thanhbinh89/Bow32/README.md

# Bow32 — MCU RISC-V 32-bit cho mục đích học tập

Bow32 là một vi điều khiển (MCU) 32-bit đơn giản, xây dựng quanh lõi
[lowRISC Ibex](https://github.com/lowRISC/ibex) (RV32IMC), được thiết kế để
**học kiến trúc SoC từ RTL tới firmware** và kiểm chứng trên board
**AMD Kria KV260 (SOM K26)**. Bow32 có một **ISP (image signal processor)**,
một **bộ thu MIPI CSI-2** tự viết (D-PHY trên primitive I/O của UltraScale+,
không dùng IP của AMD) và một **bộ mã hoá H.264** tự viết cùng **DMA** và
**video RAM 1 MiB**: camera → CSI-2 → ISP → H.264 → DMA → RAM là một luồng
phần cứng liền mạch, ra file **MP4** trên PC. Chạy thử với Raspberry Pi camera
v2 (IMX219) của KV260 ở **1080p30** hoặc **720p60**. Bộ thu còn có bản **4 lane ×
1440 Mbit/s** cho Sony IMX274 trên bo **Huins MFP-VP1902** (AMD Versal Premium; D-PHY
trên XPHY của Versal, cũng không dùng IP; chạy trên bo lần đầu 2026-11-10: 1080p30 / 720p60,
H.264 1080p). Bow32 còn có khối tăng tốc
**mã khối MKV** theo TCVN 14263:2024 (MKV-128 / MKV-256, đủ 6 phiên bản khoá),
kiểm chứng với Phụ lục A của chuẩn, **SDRAM DDR2/DDR3**:
controller **LiteDRAM** (sinh từ Python) trên PHY riêng của Bow32 (`ODDRE1`/`IDDRE1` +
MMCM dịch pha, điều khiển level shifter, hiệu chỉnh bằng phần mềm), và **HyperRAM**
(bộ điều khiển HyperBus tự viết cho S80KS2562: read buffer, ghi posted, BIST, quản lý
nguồn), cả hai chạy trên bo **Arm MPS4** (Virtex UltraScale+) và Huins MFP-VP1902.

```
                 +-----------------------------------------------------------+
                 |                         bow32_top                         |
                 |                                                           |
                 |  +-----------+ instr +------------------+                 |
                 |  |   Ibex    |------>|                  |---> ROM   8 KiB |  0x0000_0000
                 |  |  RV32IMC  |       |   main crossbar  |---> FLASH 128KiB|  0x0800_0000
                 |  | (2-stage) |------>|  3 hosts x 9 dev |---> SRAM  16KiB |  0x2000_0000
                 |  +-----------+ data  +------------------+---> VRAM  1 MiB |  0x2400_0000
                 |        ^           DMA --^      |  +-----> ISP buffer     |  0x3000_0000
                 |        ^ irq_fast[12:0]         |  +--------> AXI4-Lite --+--> m_axil_*  0x5000_0000
                 |        |                        |  +--> HyperRAM -------+--> hr_io_*   0x6000_0000
                 |        |                        |  +--> DDR (LiteDRAM) --+--> ddr_io_*  0x8000_0000
                 |        |                        v                         |
                 |        |                       +----------------+         |
                 |        +-----------------------| periph xbar    |         |  0x4000_0000
                 |                                |  SYSCTRL       |         |  + reset manager
                 |                                |  FLASH_CTRL    |         |
   uart0 <-------+--------------------------------|  UART0         |         |  console / bootloader
                 |                           +----|  UART1         |         |
   gpioa[7:0] <--+---------------------------|----|  GPIOA         |         |  PA7 = camera enable
   gpiob[7:0] <--+---------------------------+--->|  GPIOB         |         |  PB0/PB1 = UART1
                 |                                |  ISP regs -----+---+     |  0x4000_6000
   i2c0 <--------+--------------------------------|  I2C0          |   |     |  0x4000_7000
                 |       +------------------------|  CSI2RX regs   |   |     |  0x4000_8000
                 |       |                  +-----|  H264 regs     |   |     |  0x4000_9000
                 |       |                  |  +--|  DMA regs      |   |     |  0x4000_A000
                 |       |                  |  |  |  MKV cipher    |   |     |  0x4000_B000
                 |       |                  |  |  |  DDR CSR, PHY  |   |     |  0x4000_C000, _E000
                 |       |                  |  |  |  HyperRAM regs |   |     |  0x4000_F000
                 |       |                  |  |  +----------------+   |     |
                 |       v                  |  |                       v     |
   D-PHY (J9) ---+--> CSI-2 RX ---> ISP: BLC DPC WB demosaic CCM gamma CSC --+--> isp_* RGB/YUV
   (2 lane)      |                          v  v                YUV 4:4:4    |
                 |          H.264 encoder (intra, CAVLC) --stream--> DMA ----+--> VRAM
                 +-----------------------------------------------------------+
```

## Tính năng

| Khối | Mô tả |
|---|---|
| CPU | Ibex cấu hình "small": RV32IMC + Zicsr, pipeline 2 tầng, mul 3 chu kỳ, ngắt nhanh (fast IRQ) |
| Bus | Giao thức kiểu OBI (giống bus native của Ibex), crossbar có arbiter round-robin, bus error cho địa chỉ không ánh xạ |
| SRAM | 16 KiB, 0 wait-state (BRAM) |
| Flash nội | 128 KiB, mô phỏng ngữ nghĩa NOR flash: erase theo page 1 KiB / mass erase, program chỉ xoá bit 1→0, khoá bằng key, có ngắt EOP |
| Boot ROM | 8 KiB, kiểm tra header + CRC32 của ảnh trong flash, **UART loader** để nạp chương trình vào flash |
| UART ×2 | 8N1, baud lập trình được, FIFO TX/RX 16 byte, ngắt |
| GPIO (IOPAD) ×2 | 2 port × 8 chân: hướng, push-pull/open-drain, set/clear/toggle nguyên tử, ngắt theo cạnh, **chức năng thay thế** (UART1 trên PB0/PB1); 6 chân ra PMOD của KV260 |
| SYSCTRL | Chip ID, tần số clock, nguyên nhân reset, soft reset, **UART BREAK → reset vào bootloader** |
| **ISP** | RAW10 Bayer → RGB888 / YUV444, 1 pixel/clock (200 MHz trên KV260): BLC, DPC, white balance, demosaic, CCM, gamma, CSC; thống kê AE/AWB/AF + histogram; capture có lọc thu nhỏ; test pattern; 2 miền clock ([docs/ip/isp.md](docs/ip/isp.md)) |
| **Bộ thu MIPI CSI-2** | CSI-2 RX 1, 2 hoặc 4 lane: máy trạng thái LP, tìm sync, ghép lane, ECC, CRC-16, lọc VC/DT, RAW10/RAW8 → AXI4-Stream 1 pixel/clock; D-PHY RX không dùng IP AMD: primitive I/O của UltraScale+ (`IBUFDS_DPHY`, `IDELAYE3`, `ISERDESE3`, `BUFGCE_DIV`; KV260) hoặc XPHY chế độ native của Versal (`bow_dphy_io_versal`: `IBUFDS_DPHY`, XPHY, XPLL, BISC; Huins MFP-VP1902); eye hiệu chỉnh bằng phần mềm; bộ đếm lỗi, log packet, word thô của PHY; 2 × 912 Mbit/s với IMX219 (KV260), 4 × 1440 Mbit/s với IMX274 (Huins, chạy trên bo lần đầu 2026-11-10) ([docs/ip/csi2rx.md](docs/ip/csi2rx.md)) |
| **Bộ mã hoá H.264** | Constrained Baseline, intra only (IDR mỗi frame, `I_16x16` đủ 4 mode luma + 4 mode chroma, chọn mode theo SAD), CAVLC, 4:2:0, QP 10…51 mỗi frame, cờ deblocking; 392 chu kỳ/macroblock ở 200 MHz (1080p tới ~62 fps); stream Annex B chuẩn, bit-exact với mô hình Python, giải mã bằng FFmpeg trùng từng pixel ([docs/ip/h264.md](docs/ip/h264.md)) |
| **DMA** | 2 kênh, bus master thứ ba của main crossbar: memory→memory, stream→memory (tuyến tính / vòng / bỏ), đếm packet (frame), lỗi bus, ngắt ([docs/ip/dma.md](docs/ip/dma.md)) |
| **Video RAM** | 1 MiB (UltraRAM), 0 wait-state, cổng crossbar riêng cho buffer DMA / stream video |
| **Mã khối MKV** | TCVN 14263:2024: MKV-128 (khoá 128/192/256) và MKV-256 (khoá 256/384/512), lược đồ khoá trong phần cứng, mã hoá / giải mã 4R + 4 chu kỳ mỗi khối (một nửa vòng / chu kỳ, mỗi lệnh làm hai lần và đối chiếu để phát hiện lỗi tiêm vào), xoá khoá sau khi dùng, CLEAR, ngắt; 9 500 LUT; khớp Phụ lục A của chuẩn từng khoá vòng, 360/360 khối ngẫu nhiên trên KV260 trùng mô hình Python ([docs/ip/mkv.md](docs/ip/mkv.md)) |
| **DDR2/DDR3 (LiteDRAM + PHY Bow32)** | cửa sổ 512 MiB ở `0x8000_0000` cho CPU/DMA; controller LiteDRAM sinh từ cấu hình (`make litedram`, phiên bản ghim): bank machine, refresh, DFII, BIST; DDR2 x8 (bo RAM, CK 133,33 MHz) và DDR3 x16 chế độ DLL-off (≤ 125 MHz, mô phỏng), BL8; bộ chuyển DFI 1:4 sang PHY riêng chỉ dùng `ODDRE1`/`IDDRE1` + 3 MMCM (pha đọc và pha ghi dịch được 1/504 CK); hiệu chỉnh mắt đọc bằng phần mềm qua DFII + chụp thô; đọc-sửa-ghi khi không có chân DM; điều khiển DIR/OE của level shifter cho bo RAM mở rộng; DRAM giả lập tổng hợp được (kiểm tra luật JEDEC) để chạy trên bo khi chưa có chip ([docs/ip/ddr.md](docs/ip/ddr.md)) |
| **HyperRAM** | bộ điều khiển HyperBus tự viết cho HyperRAM 2.0 x8 (S80KS2562, 32 MiB): cửa sổ ở `0x6000_0000` cho CPU (thực thi mã được), read buffer 4 line với line fill wrapped (word cần trước), ghi posted gộp khối 32 byte thành một burst, latency cố định / biến đổi theo RWDS, BIST trong phần cứng, CR0/CR1, deep power down / hybrid sleep; mọi thông số thời gian là thanh ghi; PHY `ODDRE1`/`IDDRE1` + 2 MMCM (pha đọc 1/672 CK trên cả chu kỳ, pha ghi ±3T/16), bộ căn dữ liệu theo RWDS, điều khiển DIR/OE của level shifter; HyperRAM giả lập tổng hợp được cho bản loopback; đã chạy trên chip thật qua bo RAM ở khe FMC+ của MPS4: toàn 32 MiB 0 lỗi, BIST 184 MB/s ([docs/ip/hyperram.md](docs/ip/hyperram.md)) |
| I2C master | 100/400 kHz, START lặp lại, clock stretching; điều khiển cảm biến camera |
| Cầu AXI4-Lite | cửa sổ `0x5000_0000` tới IP AXI4-Lite của block design (hiện để trống), timeout → bus error |
| Công cụ | `bow32_flash.py` (nạp qua UART), `bow32_cam.py` (chụp ảnh → PNG, xem trực tiếp), `bow32_video.py` (quay video → `.h264` + `.mp4`), `bow32_mkv.py` (kiểm chứng IP MKV trên board), `bow32_ddr.py` (self-test, hiệu chỉnh, mắt đọc, băng thông, kiểm tra dữ liệu DDR trên board), `bow32_hyperram.py` (như vậy cho HyperRAM), `bow32_mps4.py` (chép bitstream lên thẻ microSD của MPS4, khởi động lại bo qua console MCC, trả lại cấu hình cũ), `huins_pins.py` (XDC chân của bo Huins từ netlist cục bộ lúc build), `bow32_image.py` (header/CRC), `gen_memmap.py` (memory map một nguồn), `isp_model.py` (mô hình ISP bit-exact), `csi2_model.py` (mô hình bộ thu CSI-2), `h264/h264_model.py` (mô hình encoder bit-exact + decoder), `h264/mp4.py` (ghi MP4, không cần ffmpeg), `mkv/mkv_model.py` (mô hình MKV + véc tơ trích từ PDF của chuẩn) |
| Kiểm chứng | Lint Verilator `-Wall` (cả RTL mức bo của Versal với stub chỉ có cổng của primitive AMD), 15 test mô phỏng hệ thống (boot, nạp qua UART, BREAK, flash, ngắt, GPIO, camera, CSI-2, H.264, MKV, DDR, HyperRAM; bản IMX274 4 lane + PHY Versal: camera, CSI-2, video) + test riêng của ISP, bộ thu CSI-2, bộ mã hoá H.264, khối MKV (so với mô hình Python), DDR (lõi LiteDRAM thật + mô hình DRAM, level shifter) và HyperRAM (mô hình S80KS2562 mức chân viết từ datasheet, level shifter), chạy trong CI; test chân D-PHY (UltraScale+ và XPHY của Versal), chân DDR / HyperRAM và MMCM bằng xsim (cần Vivado) |
| FPGA | Flow Vivado bằng script cho Kria KV260 (bản cơ bản và bản camera `kv260_cam`, không cần IP/license MIPI), overlay để nạp bằng `xmutil` trên Linux; Arm MPS4 (`BOARD=mps4`, XCVU13P) có bộ điều khiển DDR và HyperRAM, nạp qua thẻ microSD của MCC; Huins MFP-VP1902 (`BOARD=huins_vp1902`, Versal Premium xcvp1902): bo RAM ở khe FMC+ (DDR2 + HyperRAM) hoặc camera IMX274 qua bo chuyển của Huins ở FMC+01 (`CARD=cam`), PDI nạp qua USB JTAG, số chân của Huins không có trong repo (sinh từ netlist cục bộ lúc build) |

## Bắt đầu nhanh

```bash
git clone --recursive https://github.com/thanhbinh89/Bow32.git
cd Bow32
# (đã clone mà quên --recursive)  git submodule update --init --recursive

pip install -r requirements.txt   # pyserial, PyYAML

make sw        # boot ROM + ứng dụng mẫu   -> build/sw/
make lint      # lint RTL
make test      # chạy toàn bộ test mô phỏng (Verilator)
make test-ip   # test riêng của ISP, bộ thu CSI-2, bộ mã hoá H.264, MKV, DDR và HyperRAM
make test-tools # unit test của công cụ Python
make test-fpga-dv # test mức chân D-PHY I/O + bộ thu CSI-2, D-PHY Versal, chân DDR / HyperRAM + MMCM (xsim, cần Vivado)
make fpga      # bitstream + firmware cho Kria KV260 (cần Vivado)
```

Nạp ứng dụng vào flash qua UART0 (board đang chạy bitstream Bow32):

```bash
python3 tools/bow32_flash.py -p /dev/ttyUSB0 flash build/sw/hello/hello.bin
python3 tools/bow32_flash.py -p /dev/ttyUSB0 monitor
```

Camera (Raspberry Pi camera v2 trên J9, bitstream `kv260_cam`), xem
[docs/camera_kv260.md](docs/camera_kv260.md):

```bash
make fpga BOARD=kv260_cam
python3 tools/bow32_flash.py -p /dev/ttyUSB0 flash build/sw/camera/camera.bin
python3 tools/bow32_cam.py -p /dev/ttyUSB0 --fast 921600 cmd cam "ae on" "awb on"
python3 tools/bow32_cam.py -p /dev/ttyUSB0 -b 921600 snap -o frame.png
# kiểm tra bộ thu CSI-2: nạp build/sw/csi2_test/csi2_test.bin, gõ `test`
```

Camera IMX274 4 lane trên Huins MFP-VP1902 (Versal, bo chuyển camera của Huins ở FMC+01;
chuẩn bị bo, khoá ở `make jtag`, `csi2_test`, ảnh và video), xem
[docs/camera_huins.md](docs/camera_huins.md):

```bash
make fpga BOARD=huins_vp1902 CARD=cam      # cần bản sao cục bộ của tài liệu Huins (HUINS_DOCS)
make fpga-jtag BOARD=huins_vp1902 CARD=cam # in card / khe của PDI và bo phải cắm; có thể từ chối (mục 2 của doc)
```

Video H.264 → MP4 (camera → ISP → H.264 → DMA → video RAM → UART), xem
[docs/video_kv260.md](docs/video_kv260.md):

```bash
python3 tools/bow32_flash.py -p /dev/ttyUSB0 flash build/sw/video/video.bin
python3 tools/bow32_video.py -p /dev/ttyUSB0 --fast 921600 rec -n 45 --skip 1 -o video.mp4
```

Mã khối MKV (bitstream nào cũng có; KV260 hay Arm MPS4), xem [docs/mkv_kv260.md](docs/mkv_kv260.md):

```bash
python3 tools/bow32_flash.py -p /dev/ttyUSB0 flash build/sw/mkv/mkv.bin
python3 tools/bow32_mkv.py -p /dev/ttyUSB0 test          # self-test: mkv: PASS (19/19)
python3 tools/bow32_mkv.py -p /dev/ttyUSB0 verify -n 120 # khoá/khối ngẫu nhiên, so với mô hình
```

DDR2/DDR3 trên Arm MPS4 (bản loopback: PHY lái chân thật, DRAM giả lập trong FPGA), xem
[docs/ddr_mps4.md](docs/ddr_mps4.md):

```bash
make fpga BOARD=mps4 FLASH_VMEM=$PWD/build/sw/ddr/ddr.vmem
python3 tools/bow32_mps4.py deploy                            # chép lên thẻ microSD của MCC, REBOOT bo
PORT=/dev/serial/by-id/usb-FTDI_USB__-__Serial_Converter_<số serial>-if01-port0
python3 tools/bow32_ddr.py -p $PORT test                      # self-test: ddr: PASS (18/18)
python3 tools/bow32_ddr.py -p $PORT verify -n 40              # BIST / memtest với seed của PC, đọc lại so với mô hình
python3 tools/bow32_mps4.py restore                           # trả dòng APPFILE cũ cho nhóm dùng chung thẻ
```

HyperRAM trên Arm MPS4 (cùng bitstream có DDR; bản loopback: PHY lái chân thật, HyperRAM giả
lập trong FPGA; bản bo RAM: chip thật ở khe FMC+, mục 5), xem
[docs/hyperram_mps4.md](docs/hyperram_mps4.md):

```bash
make fpga BOARD=mps4 FLASH_VMEM=$PWD/build/sw/hyperram/hyperram.vmem
python3 tools/bow32_mps4.py deploy
python3 tools/bow32_hyperram.py -p $PORT test                 # self-test: hyperram: PASS (19/19)
python3 tools/bow32_hyperram.py -p $PORT verify -n 40         # BIST / ghi qua cửa sổ với seed của PC, đọc lại so với mô hình
python3 tools/bow32_mps4.py restore
```

### Công cụ cần có

| Công cụ | Phiên bản | Dùng cho |
|---|---|---|
| RISC-V GCC bare-metal (`riscv64-unknown-elf-`, `riscv32-unknown-elf-` hoặc `riscv-none-elf-`) | ≥ 12 | firmware |
| Verilator | ≥ 5.0 (CI dùng 5.020) | lint, mô phỏng |
| Python | ≥ 3.8 | công cụ host |
| Vivado (kèm `bootgen`) | 2022.2 trở lên, có hỗ trợ K26 (đã thử 2025.2; không cần IP MIPI hay license) | FPGA, test chân D-PHY (xsim) |
| `dtc` (device-tree-compiler) | | overlay cho Kria |

Ubuntu 24.04: `sudo apt install gcc-riscv64-unknown-elf verilator python3-serial python3-yaml device-tree-compiler`

## Cấu trúc thư mục

```
Bow32/
├── hw/
│   ├── vendor/lowrisc_ibex/      # Ibex (git submodule, pin theo commit)
│   ├── vendor/*.f                # filelist của Ibex
│   ├── ip/                       # IP của Bow32, mỗi IP: rtl/ + <ip>.f
│   │   ├── bus/                  #   bus package, crossbar, arbiter
│   │   ├── cpu/                  #   wrapper Ibex (cô lập interface CPU)
│   │   ├── mem/                  #   RAM 1 port, SRAM, ROM, video RAM (UltraRAM)
│   │   ├── flash/                #   flash nội + controller
│   │   ├── uart/                 #   UART
│   │   ├── gpio/                 #   GPIO / IOPAD (2 port, chức năng thay thế)
│   │   ├── isp/                  #   ISP: rtl/ + dv/ (test bit-exact với mô hình)
│   │   ├── csi2rx/               #   bộ thu MIPI CSI-2 (bow_mipi_rx, controller bow_csi2rx): rtl/ + dv/
│   │   │                         #   (mô hình máy phát D-PHY)
│   │   ├── dphy_rx/              #   phần số của D-PHY thu (bow_dphy_rx) và PPI (bow_ppi_pkg): rtl/,
│   │   │                         #   fm/ (tương đương hình thức với Formality)
│   │   ├── h264/                 #   bộ mã hoá H.264: rtl/ + dv/ (test bit-exact với mô hình)
│   │   ├── dma/                  #   DMA 2 kênh (bus master)
│   │   ├── mkv/                  #   mã khối MKV (TCVN 14263:2024): rtl/ + dv/ (so với mô hình)
│   │   ├── ddr/                  #   DDR2/DDR3: litedram/ (bộ sinh + lõi LiteDRAM đã sinh), rtl/ (cầu, DFI, PHY,
│   │   │                         #   DRAM giả lập), dv/ (mô hình clock, chân, bo, DRAM)
│   │   ├── hyperram/             #   HyperRAM: rtl/ (cửa sổ, thanh ghi, controller, BIST, PHY, HyperRAM giả lập),
│   │   │                         #   dv/ (mô hình S80KS2562, bo TXV0108, clock, chân)
│   │   ├── i2c/                  #   I2C master
│   │   ├── axil/                 #   cầu Bow32 bus -> AXI4-Lite
│   │   ├── sysctrl/              #   system controller + reset manager
│   │   └── common/               #   FIFO (cả FIFO 2 clock), synchronizer, CDC, RAM 2 port
│   ├── top/
│   │   ├── data/bow32_memmap.yaml#   memory map: NGUỒN DUY NHẤT
│   │   └── rtl/                  #   bow32_top.sv + package sinh tự động
│   ├── fpga/
│   │   ├── common/               #   primitive cho Xilinx, đọc filelist bằng Tcl,
│   │   │                         #   rtl/: D-PHY I/O (UltraScale+, Versal), chân + clock DDR và HyperRAM, dv/: test chân (xsim)
│   │   ├── kv260/                #   top board, XDC, Tcl Vivado, overlay Linux
│   │   ├── kv260_cam/            #   bản camera: D-PHY J9 -> bộ thu CSI-2, clock video 200 MHz
│   │   ├── mps4/                 #   Arm MPS4: top board, XDC (DDR / HyperRAM: loopback / bo RAM), file cho thẻ microSD
│   │   └── huins_vp1902/         #   Huins MFP-VP1902 (Versal): bo RAM (CARD=ram), camera IMX274 (CARD=cam), pins.txt
│   └── lint/                     # waiver Verilator, stub chỉ có cổng của primitive Versal
├── sim/                          # testbench hệ thống (Verilator)
├── sw/
│   ├── common/                   # HAL, driver (UART, I2C, ISP, CSI-2 RX, IMX219, IMX274, H.264, DMA, DDR, HyperRAM...), crt0, linker script,
│   │                             # litedram/ (khởi tạo + hiệu chỉnh DDR qua LiteDRAM)
│   ├── bootrom/                  # romcode: boot + UART loader
│   ├── apps/                     # hello, uart_irq, flash_demo, gpio_demo, camera, csi2_test, video, mkv, ddr, hyperram
│   └── mk/                       # Makefile dùng chung
├── tools/                        # công cụ Python phía host (+ isp/, csi2/, h264/, mkv/: mô hình, MP4)
├── docs/                         # tài liệu (tiếng Việt); tài liệu của Arm/AMD (docs/fpga/) và văn bản
│                                 # chuẩn MKV (docs/ref/) chỉ để bản cục bộ, không có trong git
└── .github/workflows/ci.yml      # CI: gen-check, sw, test-tools, lint, test, ISP / CSI-2 RX / H.264 / MKV / DDR / HyperRAM dv
```

## Tài liệu

| Tài liệu | Nội dung |
|---|---|
| [docs/architecture.md](docs/architecture.md) | Kiến trúc tổng thể, clock/reset, ngắt, quyết định thiết kế |
| [docs/memory_map.md](docs/memory_map.md) | Bản đồ bộ nhớ (sinh tự động) |
| [docs/bus.md](docs/bus.md) | Giao thức bus, crossbar, cách gắn thiết bị mới |
| [docs/ip/](docs/ip/) | Đặc tả từng IP và thanh ghi: CPU, UART, GPIO, flash, sysctrl, bộ nhớ, ISP, bộ thu CSI-2, H.264, DMA, MKV, DDR, HyperRAM, I2C, cầu AXI4-Lite |
| [docs/ip/isp.md](docs/ip/isp.md) | ISP: pipeline, công thức từng stage, thống kê, capture, thanh ghi |
| [docs/ip/csi2rx.md](docs/ip/csi2rx.md) | Bộ thu MIPI CSI-2: D-PHY, I/O UltraScale+ và XPHY của Versal, 4 lane, CDC, packet, thanh ghi, hiệu chỉnh eye, ràng buộc |
| [docs/csi2rx_review.md](docs/csi2rx_review.md) | Đánh giá bộ thu CSI-2 cho camera công nghiệp và SoC camera AI: phát hiện, khoảng cách, kiến trúc và lộ trình đề xuất |
| [docs/ip/mipi_rx_arch.md](docs/ip/mipi_rx_arch.md) | Kiến trúc bộ thu MIPI cho ASIC (đặc tả; RTL tới bước 2 của kế hoạch chuyển): giao diện AFE của D-PHY analog, D-PHY số `bow_dphy_rx`, PPI, bộ điều khiển CSI-2 sau khi tách, thanh ghi, hiệu chỉnh, kiểm chứng, cổng sẵn sàng ASIC, kế hoạch chuyển từng bước |
| [docs/camera_kv260.md](docs/camera_kv260.md) | Chạy camera trên KV260: bitstream, ứng dụng `camera` và `csi2_test`, chụp ảnh về PC |
| [docs/camera_huins.md](docs/camera_huins.md) | Camera IMX274 (4 lane) trên Huins MFP-VP1902: VCCIO và bo nào ở khe nào, build `CARD=cam`, khoá ở `make jtag`, `csi2_test`, `camera`, `video`, danh sách kiểm khi bring-up, D-PHY trên XPHY của Versal |
| [docs/ip/h264.md](docs/ip/h264.md) | Bộ mã hoá H.264: kiến trúc, các khối, quyết định của encoder, stream, thanh ghi, kiểm chứng |
| [docs/ip/dma.md](docs/ip/dma.md) | DMA: chế độ M2M / stream, ring buffer, thanh ghi |
| [docs/ip/mkv.md](docs/ip/mkv.md) | Mã khối MKV: thuật toán (TCVN 14263:2024), so với bản dự thảo, kiến trúc, thanh ghi, kiểm chứng |
| [docs/mkv_kv260.md](docs/mkv_kv260.md) | Chạy và kiểm chứng IP MKV trên Arm MPS4 và KV260: `test`, `kat`, `verify`, `bench` |
| [docs/mkv_security_review.md](docs/mkv_security_review.md) | Đánh giá IP MKV cho SoC camera AI: mô hình đe doạ, chuẩn tham chiếu, phát hiện (tiêm lỗi, kênh kề, khoá, tích hợp), lộ trình sửa |
| [docs/ip/ddr.md](docs/ip/ddr.md) | DDR2/DDR3: lõi LiteDRAM (sinh, CSR), cầu bus, bộ chuyển DFI, PHY, level shifter, khởi tạo, hiệu chỉnh, thanh ghi, kiểm chứng |
| [docs/ddr_mps4.md](docs/ddr_mps4.md) | Chạy bộ điều khiển DDR trên Arm MPS4: build, thẻ microSD, `test`, `cal`, `verify`, `bench` |
| [docs/ip/hyperram.md](docs/ip/hyperram.md) | HyperRAM: giao thức HyperBus, cửa sổ (read / write buffer), controller, PHY, level shifter, thanh ghi, khởi tạo, hiệu chỉnh, BIST, kiểm chứng |
| [docs/hyperram_mps4.md](docs/hyperram_mps4.md) | Chạy bộ điều khiển HyperRAM trên Arm MPS4: build, clock, `test`, `cal`, `verify`, `bench` |
| [docs/ddr_huins.md](docs/ddr_huins.md) | DDR2 và HyperRAM với bo RAM thật trên Huins MFP-VP1902: VADJ, build, nạp PDI qua JTAG, kết quả trên bo |
| [docs/ddr_board_review.md](docs/ddr_board_review.md) | Khả năng làm DDR trên Bow32, bo RAM mở rộng hợp với bo FPGA nào, góp ý schematic |
| [docs/fmc_ram_card_review.md](docs/fmc_ram_card_review.md) | Review toàn bộ bo RAM mở rộng (DDR2 + HyperRAM, cơ khí, BOM), lắp trên Arm MPS4 và Huins MFP-VP1902, chức năng IP test được trên mỗi board |
| [docs/video_kv260.md](docs/video_kv260.md) | Quay video H.264 / MP4 trên KV260: ứng dụng `video`, `bow32_video.py`, kết quả |
| [docs/boot.md](docs/boot.md) | Quy trình boot, định dạng ảnh, giao thức UART loader |
| [docs/simulation.md](docs/simulation.md) | Chạy mô phỏng, xem waveform, viết test mới |
| [docs/fpga_kria.md](docs/fpga_kria.md) | Build và chạy trên Kria KV260 |
| [docs/adding_an_ip.md](docs/adding_an_ip.md) | Hướng dẫn thêm IP mới (ví dụ GPIO) |
| [docs/ip_upgrade.md](docs/ip_upgrade.md) | Nâng cấp Ibex và các IP, quản lý phiên bản |
| [docs/roadmap.md](docs/roadmap.md) | Lộ trình học / mở rộng tiếp theo |

## Giấy phép

Mã nguồn Bow32 dùng giấy phép Apache-2.0 (giống Ibex), xem [LICENSE](LICENSE).
Ibex và các primitive của lowRISC giữ giấy phép gốc trong submodule.
