thanhbinh89/Bow32/docs/roadmap.md

# Lộ trình học và mở rộng

Các bước gợi ý theo độ khó tăng dần. Mỗi bước là một IP/tính năng có thể thêm
theo [adding_an_ip.md](adding_an_ip.md) và kiểm chứng bằng test mô phỏng.

## Mức 1 — ngoại vi cơ bản

- [ ] **Timer / CLINT** (`mtime`, `mtimecmp`) → nối `irq_timer_i`; viết `delay`
      bằng ngắt và một scheduler nhỏ.
- [x] **GPIO / IOPAD**: 2 port × 8 chân, ngắt theo cạnh, open-drain, chức năng thay thế;
      6 chân ra PMOD ([ip/gpio.md](ip/gpio.md)).
- [ ] **Watchdog** reset SoC qua `bow_rstmgr` (thêm `RST_CAUSE.WDOG`).
- [ ] UART: parity, oversampling 16×, ngắt theo mức FIFO.

## Mức 2 — hệ thống

- [ ] **PLIC** đơn giản → `irq_external_i`, nhiều nguồn ngắt có ưu tiên.
- [ ] **SPI master** (cảm biến / màn hình qua PMOD).
- [x] **I2C master** ([ip/i2c.md](ip/i2c.md)): điều khiển cảm biến camera.
- [x] **DMA** ([ip/dma.md](ip/dma.md)): host thứ 3 trên crossbar, 2 kênh M2M /
      stream → bộ nhớ; ghi stream H.264 vào video RAM 1 MiB.
- [ ] Flash: wait-state đọc + prefetch buffer; bật `ICache` của Ibex để thấy hiệu quả.
- [ ] Bộ đếm hiệu năng (`MHPMCounterNum`) và đo CoreMark.

## Mức 3 — debug và phần mềm

- [ ] **Debug module** RISC-V ([pulp riscv-dbg](https://github.com/pulp-platform/riscv-dbg))
      + JTAG → debug bằng OpenOCD/GDB (`debug_req_i` của Ibex).
- [ ] Port **FreeRTOS** (cần timer + ngắt).
- [ ] Bootloader thứ 2 trong flash, cập nhật firmware an toàn (A/B, rollback).
- [ ] Bật **PMP**, tách chế độ M/U.

## Mức 4 — tích hợp với Kria

- [ ] UART của Bow32 ↔ PS qua AXI UART Lite: điều khiển từ Linux, không cần adapter.
- [x] Cầu **Bow32 bus → AXI4-Lite** ([ip/axil_bridge.md](ip/axil_bridge.md)): Bow32 điều khiển IP AXI
      của Xilinx (đã dùng cho CSI-2 RX của AMD; nay cửa sổ để trống cho IP khác).
- [ ] AXI4 master (DMA) để Bow32 ghi ảnh / dữ liệu vào DDR của PS.
- [ ] Flash không bay hơi: backing store trên QSPI/eMMC thông qua PS.
- [ ] Bus TL-UL (OpenTitan) hoặc AXI làm interconnect chính, so sánh độ phức tạp.

## Mức 5 — xử lý ảnh / camera

- [x] **ISP** RAW10 → RGB/YUV 1 pixel/clock, thống kê AE/AWB/AF, capture
      ([ip/isp.md](ip/isp.md)); camera IMX219 1080p30 / 720p60 trên KV260
      ([camera_kv260.md](camera_kv260.md)).
- [x] **Bộ thu MIPI CSI-2 của Bow32** thay IP AMD ([ip/csi2rx.md](ip/csi2rx.md)):
      D-PHY RX trên `IBUFDS_DPHY`/`IDELAYE3`/`ISERDESE3`/`BUFGCE_DIV`, máy trạng
      thái LP, phát hiện SoT, căn byte, ghép lane, lớp packet (header, ECC,
      CRC-16), unpack RAW10/RAW8, eye hiệu chỉnh bằng phần mềm; `csi2_test`
      PASS 18/18 trên KV260. Giai đoạn 0 của review công nghiệp: giữ khung
      dòng/frame khi tràn FIFO, `tuser[1]` dòng lỗi, `FRAME_ERR` mỗi frame,
      deskew, cờ EXTRA, `SETTLE` theo tốc độ lane, kiểm tra lề sau hiệu chỉnh.
- [ ] Bộ thu CSI-2 nâng cao: 4 lane (2 pixel/clock), RAW12, LRTE (nhiều packet
      trong một burst, CSI-2 v2.0+), bám eye và hiệu chỉnh theo nhiệt, ULPS
      ([csi2rx_review.md](csi2rx_review.md) mục 7).
- [x] **Bộ mã hoá H.264** ([ip/h264.md](ip/h264.md)): intra only, `I_16x16`,
      CAVLC; camera → ISP → H.264 → DMA → video RAM → MP4 ([video_kv260.md](video_kv260.md)).
- [ ] H.264 nâng cao: Intra 4x4, frame P (`P_Skip` + tìm chuyển động, cần frame
      tham chiếu trong DDR), rate control theo hàng macroblock, streaming liên tục
      qua UART / Ethernet của PS.
- [ ] Hiển thị: đưa `isp_*` ra DisplayPort (live video của PS) hoặc HDMI.
- [ ] ISP nâng cao: demosaic thích nghi theo cạnh, khử nhiễu, sharpen, lens
      shading, thống kê theo lưới, 2 pixel/clock.

## Mức 6 — mật mã

- [x] **Mã khối MKV** (TCVN 14263:2024, [ip/mkv.md](ip/mkv.md)):
      MKV-128 / MKV-256, 6 phiên bản khoá, lược đồ khoá trong phần cứng, một nửa
      vòng mỗi chu kỳ; kiểm chứng với Phụ lục A và trên KV260, MPS4 ([mkv_kv260.md](mkv_kv260.md)).
- [ ] Chế độ hoạt động trong phần cứng (CTR / CBC / GCM) và nạp dữ liệu bằng DMA.
- [ ] Hàm băm (SHA-2 / SHA-3) và TRNG (ring oscillator) để có khoá sinh ngay trên chip.

## Mức 7 — bộ nhớ ngoài

- [x] **DDR2/DDR3** ([ip/ddr.md](ip/ddr.md)): controller LiteDRAM (sinh từ cấu hình, phiên
      bản ghim) trên PHY riêng (`ODDRE1`/`IDDRE1` + MMCM dịch pha, level shifter), hiệu
      chỉnh bằng phần mềm qua DFII; chạy trên Arm MPS4 với DRAM giả lập
      ([ddr_mps4.md](ddr_mps4.md)).
- [x] **HyperRAM** ([ip/hyperram.md](ip/hyperram.md)): bộ điều khiển HyperBus tự viết cho
      S80KS2562 (x8, 32 MiB): read buffer với line fill wrapped, ghi posted gộp khối, BIST,
      CR0/CR1, deep power down / hybrid sleep, PHY `ODDRE1`/`IDDRE1` + 2 MMCM dịch pha, điều
      khiển level shifter; chạy trên Arm MPS4 với HyperRAM giả lập ([hyperram_mps4.md](hyperram_mps4.md)).
- [ ] Chạy với bo RAM mở rộng thật (DDR2 IS43DR86400E và HyperRAM S80KS2562 qua level shifter)
      khi đã sản xuất ([ddr_board_review.md](ddr_board_review.md)).
- [ ] HyperRAM: prefetch line kế (burst hybrid), cổng AXI4 cho DMA, deskew từng bit
      (`IDELAYE3`), HyperRAM 3.0 x16 / HyperFlash.
- [ ] Cache trước cửa sổ DDR để CPU chạy mã từ DDR; DMA ghi frame H.264 vào DDR.
- [ ] Bo RAM rev-B DDR3 1,5 V nối thẳng FMC (không level shifter): dùng PHY `USPDDRPHY`
      của LiteDRAM ở DDR3-800 trở lên; deskew từng bit bằng `IDELAYE3`.
- [ ] DDR4 SODIMM 8 GB có sẵn trên MPS4 (bank 60–62) với `USPDDRPHY` của LiteDRAM.

## Chất lượng / quy trình

- [ ] Testbench riêng cho từng IP (`hw/ip/<ip>/dv/`), coverage (đã có cho ISP và bộ thu CSI-2: so với mô hình Python).
- [ ] Mô tả thanh ghi bằng file dữ liệu (hjson/YAML) và sinh RTL + header (giống `reggen` của OpenTitan).
- [ ] Formal (SymbiYosys) cho crossbar và FIFO (cả FIFO 2 clock `bow_fifo_async`).
- [ ] Đồng mô phỏng UART ↔ PTY để chạy `bow32_flash.py` thật với mô hình Verilator.
