thanhbinh89/Bow32/docs/memory_map.md

<!-- AUTO-GENERATED by tools/gen_memmap.py from hw/top/data/bow32_memmap.yaml - DO NOT EDIT -->

# Bản đồ bộ nhớ (Memory map)

Tệp này được sinh tự động từ `hw/top/data/bow32_memmap.yaml`. Sửa YAML rồi chạy `make gen`.

- Chip ID: `0xB0320100`
- Boot address (`boot_addr_i`): `0x00000000` (PC sau reset = `0x00000080`)

## Main bus (crossbar)

| Port | Tên | Base | End | Size | Mô tả |
|-----:|-----|---|-----|---|---|
| 0 | `rom` | `0x00000000` | `0x00001FFF` | 8 KiB | Boot ROM (8 KiB, romcode) |
| 1 | `flash` | `0x08000000` | `0x0801FFFF` | 128 KiB | Internal flash (128 KiB) |
| 2 | `sram` | `0x20000000` | `0x20003FFF` | 16 KiB | SRAM (16 KiB) |
| 3 | `periph` | `0x40000000` | `0x4000FFFF` | 64 KiB | Peripheral bus (16 x 4 KiB slots) |
| 4 | `isp_buf` | `0x30000000` | `0x3001FFFF` | 128 KiB | ISP capture buffer (32K x 24 bit, read only) |
| 5 | `axil` | `0x50000000` | `0x5000FFFF` | 64 KiB | AXI4-Lite window (devices of the FPGA block design) |
| 6 | `vram` | `0x24000000` | `0x240FFFFF` | 1 MiB | Video RAM (1 MiB, UltraRAM): DMA buffers, H.264 stream |
| 7 | `ddr` | `0x80000000` | `0x9FFFFFFF` | 512 MiB | DDR2/DDR3 SDRAM window (bow_ddr, 512 MiB decode, real size = DRAM size) |
| 8 | `hyperram` | `0x60000000` | `0x6FFFFFFF` | 256 MiB | HyperRAM window (bow_hyperram, 256 MiB decode, real size = device size) |

## Peripheral bus

| Port | Tên | Base | End | Size | Mô tả |
|-----:|-----|---|-----|---|---|
| 0 | `sysctrl` | `0x40000000` | `0x40000FFF` | 4 KiB | System control, reset manager, boot config |
| 1 | `flash_ctrl` | `0x40001000` | `0x40001FFF` | 4 KiB | Flash controller registers |
| 2 | `uart0` | `0x40002000` | `0x40002FFF` | 4 KiB | UART0 (console / bootloader) |
| 3 | `uart1` | `0x40003000` | `0x40003FFF` | 4 KiB | UART1 (general purpose, pins PB0/PB1) |
| 4 | `gpioa` | `0x40004000` | `0x40004FFF` | 4 KiB | GPIO port A (8 pins) |
| 5 | `gpiob` | `0x40005000` | `0x40005FFF` | 4 KiB | GPIO port B (8 pins, PB0/PB1 = UART1 TX/RX) |
| 6 | `isp` | `0x40006000` | `0x40006FFF` | 4 KiB | ISP registers (image signal processor) |
| 7 | `i2c0` | `0x40007000` | `0x40007FFF` | 4 KiB | I2C master 0 (camera control) |
| 8 | `csi2rx` | `0x40008000` | `0x40008FFF` | 4 KiB | MIPI CSI-2 receiver (D-PHY RX + CSI-2 RX) |
| 9 | `h264` | `0x40009000` | `0x40009FFF` | 4 KiB | H.264 encoder (ISP output -> H.264 stream) |
| 10 | `dma` | `0x4000A000` | `0x4000AFFF` | 4 KiB | DMA controller (2 channels, M2M / stream to memory) |
| 11 | `mkv` | `0x4000B000` | `0x4000BFFF` | 4 KiB | MKV block cipher (TCVN 14263:2024): MKV-128 / MKV-256 |
| 12 | `ddr_ctrl` | `0x4000C000` | `0x4000DFFF` | 8 KiB | DDR controller CSRs (LiteDRAM: DFII, BIST, init status) |
| 13 | `ddr_phy` | `0x4000E000` | `0x4000EFFF` | 4 KiB | DDR PHY and bus bridge registers (bow_ddr) |
| 14 | `hyperram_reg` | `0x4000F000` | `0x4000FFFF` | 4 KiB | HyperRAM controller registers (bow_hyperram: HyperBus master, PHY, BIST) |

Truy cập vào địa chỉ không được ánh xạ trả về bus error (Ibex sinh exception *load/store/instruction access fault*).

## Ngắt nhanh (Ibex `irq_fast_i`)

| Line | mcause | Nguồn | Mô tả |
|-----:|---:|---|---|
| 0 | `0x80000010` | `uart0` | UART0 RX not empty / TX empty |
| 1 | `0x80000011` | `uart1` | UART1 RX not empty / TX empty |
| 2 | `0x80000012` | `flash` | Flash end of operation |
| 3 | `0x80000013` | `gpioa` | GPIO port A pin edge |
| 4 | `0x80000014` | `gpiob` | GPIO port B pin edge |
| 5 | `0x80000015` | `isp` | ISP frame done / capture done / error |
| 6 | `0x80000016` | `i2c0` | I2C0 command done |
| 7 | `0x80000017` | `csi2rx` | CSI-2 RX frame start / frame end / error / log or raw capture done |
| 8 | `0x80000018` | `h264` | H.264 encoder frame done / sequence done / error |
| 9 | `0x80000019` | `dma` | DMA channel done / stream packet / bus error |
| 10 | `0x8000001A` | `mkv` | MKV command done / command error |
| 11 | `0x8000001B` | `ddr` | DDR PHY / bridge: capture / phase done, errors |
| 12 | `0x8000001C` | `hyperram` | HyperRAM: command / capture / BIST done, errors |
