thanhbinh89/Bow32/docs/ip/mipi_rx_arch.md

# Kiến trúc bộ thu MIPI cho ASIC: AFE, D-PHY số, PPI và bộ điều khiển CSI-2

Đặc tả kiến trúc (RTL: bước 1 và 2 của mục 10 xong, đã chạy trên bo Huins; bước 3, kiểm chứng
controller ở PPI, xong trong mô phỏng) cho bộ thu MIPI mà
Bow32 sở hữu trọn vẹn trên **ASIC**: cả **D-PHY** (phần analog lẫn phần số) và **bộ điều khiển
CSI-2**, chia theo các lớp chuẩn của MIPI:

```
module camera ─► D-PHY analog (AFE) ─► [giao diện AFE] ─► D-PHY số ─► PPI ─► bộ điều khiển CSI-2 ─► AXI / ISP
```

FPGA chỉ là nơi kiểm chứng RTL số: trên FPGA, primitive I/O của hãng đứng thay D-PHY analog sau
một adapter. Điểm xuất phát là mã ở `main` `458dd33` (bộ thu 4 lane đã chạy trên bo Huins với
IMX274; PR #17, PR #18). [csi2rx.md](csi2rx.md) mô tả bộ thu hiện tại;
[../csi2rx_review.md](../csi2rx_review.md) mục 5–7 đã đề xuất tách PPI cho SoC camera AI. Tài liệu
này biến đề xuất đó thành đặc tả: giao diện AFE, khối D-PHY số mới `bow_dphy_rx`, PPI của Bow32,
bộ điều khiển sau khi tách, hiệu chỉnh, kiểm chứng, sẵn sàng ASIC và kế hoạch chuyển từng bước.
Chạy trên bo: [../camera_kv260.md](../camera_kv260.md), [../camera_huins.md](../camera_huins.md).

**Quy ước.** Đặc tả MIPI chỉ dành cho thành viên: tài liệu này không chép văn bản nào của nó;
hành vi được mô tả bằng lời của tài liệu này, con số thời gian lấy từ nguồn công khai có dẫn
([S1]…[S23], mục *Nguồn* ở cuối). **[CHƯA CHẮC]** = chưa kiểm được ở nguồn gốc; **[ĐỀ XUẤT]** =
con số do tài liệu này đề nghị, đội liên quan phải xác nhận. Không có số chân, nibble hay slice
của bo Huins. Tên module, tín hiệu và thanh ghi giữ tiếng Anh. "Hiện nay" = `main` `458dd33`;
số dòng theo commit đó.

| Thông số | Giá trị |
|---|---|
| Đích | ASIC: Bow32 sở hữu AFE (D-PHY analog), D-PHY số và controller CSI-2; FPGA (KV260, Huins MFP-VP1902) kiểm chứng phần số |
| Lớp vật lý | D-PHY RX một chiều: 1 lane clock + 1, 2 hoặc 4 data lane (tham số tới 8), clock liên tục hoặc không; 80 Mbit/s … 2,5 Gbit/s mỗi lane (đích B, đã chốt ở mục 0: `clk_act` của AFE bắt buộc, mục 1.2) |
| D-PHY số | máy LP, settle, termination, cổng byte clock, SoT và căn byte, deskew (nhận ra, rồi hiệu chỉnh), lỗi, ULPS; escape LPDT/trigger để sau |
| Ranh giới | giao diện AFE (dưới PPI: word chưa căn, byte clock, mức LP, điều khiển analog) và PPI 8 bit mỗi lane (16 bit ở v2) |
| CSI-2 | lớp giao thức v1.x trên D-PHY, mốc v1.3; đường lên v2.x |
| Khối mới | `bow_dphy_rx`, `bow_dphy_rx_regs`, `bow_dphy_raw`, `bow_dphy_dsk`, `bow_dphy_prbs`, `bow_ppi_pkg`, `bow_mipi_rx` (wrapper Bow32), `bow_mipi_rx_apb` (wrapper APB4 cho ASIC), `bow_csi2rx_ppi_flat` (controller với cổng PPI phẳng cho PHY chuẩn, bước 3); FPGA: `bow_dphy_dly_xusp`, `bow_dphy_dly_xphy` (logic adapter không có primitive); DV: `bow_ppi_bfm` và `tb_csi2rx_ppi` (bước 3), `bow_dphy_afe_model`, `bow_dphy_tx` |
| Đổi vai | `bow_dphy_io_xusp`, `bow_dphy_io_versal` thành **adapter AFE** (giữ tên file và tên instance mà XDC dùng) |
| Giữ nguyên | lớp CSI-2 của `bow_csi2rx` (ghép lane, packet, unpack, FIFO, đầu ra, LOG); bản đồ `CSI2RX` ở `0x4000_8000` (thanh ghi PHY chuyển sang D-PHY ở `0x4000_8C00`; không có alias, driver chọn theo `INFO[6]`, mục 6.3) |
| Trạng thái | đặc tả; RTL: bước 1 và 2 xong, `csi2_test` `test` PASS 17/17 trên bo Huins ngày 2026-11-11 (bước 1: `bow_dphy_rx` tách bên trong `bow_csi2rx`; bước 2: `bow_mipi_rx` ghép `bow_dphy_rx` và controller `bow_csi2rx` bằng PPI v1 cộng một dải phụ tạm thời; cổng và thanh ghi không đổi, tương đương chứng minh bằng Synopsys Formality, D8 sửa đổi đã duyệt, mục 0 và 10); bước 3 xong trong mô phỏng 2026-11-12: bench controller ở PPI `tb_csi2rx_ppi` với `bow_ppi_bfm`, hai chế độ thời gian (D-PHY Bow32, PHY chuẩn qua wrapper cổng phẳng) đều sạch, hồ sơ PPI mục 5.5 sửa theo kết quả, không đổi RTL nào có sẵn; các quyết định kiến trúc đã chốt ngày 2026-11-11 (mục 0); kế hoạch chuyển gồm các bước 0–11, mỗi bước giữ mọi test hiện có, build và chạy trên bo Huins (KV260 chỉ kiểm bằng mô phỏng, quyết định D1), kỳ vọng nào đổi thì ghi rõ (mục 10) |

## 0. Quyết định đã chốt (2026-11-11)

Chủ dự án đã duyệt các điểm sau trong review PR #19. Các mục còn lại của tài liệu đã được sửa cho
khớp; số **[ĐỀ XUẤT]** vẫn chờ đội liên quan chốt như ghi ở từng mục.

| ID | Quyết định | Hệ quả | Mục |
|---|---|---|---|
| D1 | Thanh ghi D-PHY ở `0x4000_8C00`, **không có alias**; driver đọc `INFO[6]` và từ chối bitstream cũ | firmware và bitstream luôn build từ cùng commit. Ở các bước chuyển, phần cứng chỉ **build và chạy thử trên Huins** (PDI camera, `csi2_test`); KV260 không build bitstream và không chạy trên bo cho tới khi cần (cấu hình KV260 vẫn kiểm bằng mô phỏng trong CI); lần chạy KV260 sau phải nạp bitstream mới cùng firmware mới | 6.3, 10 |
| D2 | Đích tốc độ ASIC: **B = 80 Mbit/s … 2,5 Gbit/s** | `clk_act` bắt buộc trong AFE; ba sửa tốc độ thấp (a)–(c) của mục 4.5 và bộ máy deskew (trên 1,5 Gbit/s) là điều kiện sign-off; PPI 16 bit có thể cần ở node chậm (quyết ở bước 9, Q5); cổng sẵn sàng theo cột B của mục 9.7 | 1.2, 4.5, 4.6, 9.7 |
| D3 | Hợp đồng đồng bộ AFE: phát ở cạnh xuống, bắt ở cạnh lên kế tiếp, với các số của mục 3.3; cổng clock đồng bộ trong AFE, squelch ở bộ thu HS lane clock, `des_rst` không dừng bộ chia | dùng làm đề xuất ban đầu giao đội analog; số cuối chốt theo node | 3.2, 3.3 |
| D4 | Tư cách thành viên MIPI (quyền đọc đặc tả, chọn phiên bản D-PHY, kế hoạch tuân thủ / CTS) là **điều kiện trước khi đóng băng AFE** | không đóng băng hợp đồng AFE trước khi có | 9.7, R1 |
| D5 | Bật termination: mặc định **(a)** `lp_clk` của ASIC ≥ 250 MHz chạy liên tục, `LP_FILTER` = 1; **(b)** termination tự động trong AFE (`AfeTermAuto`) là phương án dự phòng | chốt cuối cùng với đội clock / nguồn của SoC | 3.4, Q1, Q2 |
| D6 | Ranh giới AFE nằm **dưới PPI**: AFE giao word chưa căn, byte clock và mức LP thô; mọi quyết định giao thức nằm ở `bow_dphy_rx` | `bow_dphy_rx` dùng lại được với mọi AFE theo hợp đồng mục 3 | 3.1 |
| D7 | PPI **8 bit** mỗi lane ở v1; 16 bit quyết sau tổng hợp thử | — | 5, bước 9 |
| D8 | Kế hoạch chuyển bước 0–11, **mỗi bước một PR**; bước 1–3 là refactor, chứng minh tương đương bằng Yosys eqy (**sửa ngày 2026-11-11: Synopsys Formality**, xem dưới) | — | 10 |

**D8 sửa đổi, đã duyệt (2026-11-11).** Chứng minh tương đương của các bước refactor dùng
**Synopsys Formality**, RTL với RTL (`make -C hw/ip/dphy_rx/fm equiv STEP=<n>`): mọi compare point
khớp và tương đương, mọi cặp khớp mang đúng tên của reference sau luật đổi tên, mọi cell nằm đúng
khối, không black box, user match hay constant. Lý do: Yosys eqy không có trên máy build (không
được cài công cụ ngoài) và Yosys gốc chỉ đọc một phần SystemVerilog; Formality có license trên
máy, là công cụ kiểm tương đương chuẩn cho ASIC và sẽ dùng tiếp để so RTL với netlist (bước 9).
Formality cần license nên **không chạy trong CI**: luồng chạy ở máy build trước mỗi PR của một
bước refactor, kết quả ghi trong PR; CI vẫn chạy toàn bộ mô phỏng. Thêm Yosys eqy vào CI (trên
runner của CI) để ai cũng chạy lại được là tuỳ chọn về sau.

## 1. Mục tiêu và phạm vi

### 1.1 Mục tiêu

1. **ASIC trước.** Bow32 sở hữu cả D-PHY RX (analog và số) lẫn bộ điều khiển CSI-2 RX. Đội analog
   chỉ cần mục 3 (giao diện AFE) để làm macro; phần số không chứa gì riêng của FPGA.
2. **FPGA để kiểm chứng phần số.** `bow_dphy_rx` và `bow_csi2rx` là cùng một RTL trên FPGA và
   ASIC; mọi khác biệt của FPGA nằm trong adapter AFE. Số liệu đo trên FPGA (eye, tap, BISC) là
   của adapter, không phải của ASIC.
3. **Giữ những gì đã chạy trên bo.** Máy LP, aligner, ghép lane, lớp packet, unpack, eye walk và
   kiểm tra lề đã chạy trên KV260 (IMX219, 2 × 912 Mbit/s) và Huins (IMX274, 4 × 1440 Mbit/s):
   chúng được chuyển nguyên trạng trước, cải tiến sau, và mỗi bước giữ test và bản build xanh.
4. **Ranh giới chuẩn ở giữa.** PPI là giao diện tham khảo giữa PHY và lớp giao thức [S1][S4][S15].
   Controller CSI-2 của Bow32 được thiết kế để ghép với D-PHY của hãng khác (và D-PHY của Bow32 với
   controller khác) qua wrapper cổng phẳng, trong giới hạn của hồ sơ PPI ở mục 5.5. Bước 3 đạt mục
   tiêu này ở mức mô phỏng cho controller: `bow_csi2rx_ppi_flat` với thời gian kiểu PHY chuẩn chạy
   sạch như thời gian của D-PHY Bow32 (mục 5.5, 10), với bốn điều mà phần dựng PHY chuẩn còn mượn
   của D-PHY Bow32 (mục 5.5, *Bước 3*). Chưa thử với PHY của hãng nào: với một PHY cụ
   thể vẫn là mục tiêu thiết kế, chưa phải khả năng đã chứng minh. Mọi chỗ Bow32 lệch khỏi PPI
   công khai được ghi ở mục 5.3.
5. **Hiệu chỉnh dựa trên dữ liệu.** Bài học của bo Huins (tự hiệu chỉnh BISC đặt điểm lấy mẫu ở
   mép sớm của eye) thành yêu cầu kiến trúc: tự hiệu chỉnh trong phần cứng của PHY (BISC của XPHY,
   hay của AFE ASIC) chỉ là điểm xuất phát, điểm lấy mẫu cuối cùng phải được đo trên dữ liệu
   (mục 7).

### 1.2 Dải hỗ trợ

| Hạng mục | RTL v1 (sau khi tách) | Mục tiêu ASIC | Để ngỏ cho |
|---|---|---|---|
| Data lane | 1, 2, 4 (tham số `Lanes`, chọn lúc chạy) | 1, 2, 4 | 8: tham số, địa chỉ thanh ghi và PPI đã có chỗ (logic của lane 4–7 chỉ sinh khi `Lanes` > 4); ghép lane và lớp packet cần mở rộng (mục 6.5) |
| Tốc độ mỗi lane | thiết kế cho ~350 Mbit/s … 1,5 Gbit/s; đã kiểm 770–1050 Mbit/s trong DV, 912 Mbit/s (KV260) và 1440 Mbit/s (Huins) trên bo; giới hạn dưới ở mục 4.5; trên 1,5 Gbit/s hiệu chỉnh bằng eye walk tới khi có bộ máy deskew | **đích B (đã chốt, D2): 80 Mbit/s … 2,5 Gbit/s.** Cần `clk_act` của AFE (bắt buộc, mục 3.2), các sửa (a)–(c) của mục 4.5 (bước 10) và bộ máy deskew trên 1,5 Gbit/s (bước 8); cả ba là điều kiện sign-off (mục 9.7) | trên 2,5 Gbit/s (D-PHY v2.x: equalization, ACS) ngoài phạm vi |
| Lane clock | liên tục hoặc không (dừng mỗi burst hoặc mỗi frame) | như v1 | — |
| Chức năng D-PHY phía thu | LP/HS, SoT, nhận ra burst deskew, lỗi SoT/LP, watchdog HS | + timer lập trình được, ULPS, `ErrSotHS`, bộ máy deskew, ánh xạ lane (`LANE_MAP`) | escape LPDT, trigger |
| PPI | 8 bit mỗi lane | 8 bit; 16 bit cho 2,5 Gbit/s ở node chậm | 16/32 bit (tuỳ chọn từ D-PHY v2.0 [S13]) |
| CSI-2 | v1.x: VC 2 bit, ECC, CRC, FS/FE, RAW8/RAW10, một packet mỗi burst | mốc v1.3 trên D-PHY | v2.x: VCX, RAW16/RAW20, LRTE/EPD (nhiều packet mỗi burst) |

**Mốc CSI-2 v1.3** ở đây là lớp giao thức chung của các bản v1.x trên D-PHY: header 4 byte (DI =
VC 2 bit + DT 6 bit, WC 16 bit, ECC 6 bit), CRC-16 của long packet, short packet FS/FE/LS/LE và
generic, các kiểu dữ liệu ảnh và embedded. Những gì v1.3 thêm so với v1.1 khi dùng D-PHY phải được
một thành viên MIPI kiểm ở đặc tả **[CHƯA CHẮC]**; C-PHY không thuộc phạm vi. Các tính năng v2.x
kể trên lấy theo tài liệu hiện có của Bow32 ([csi2rx.md](csi2rx.md) mục *Giới hạn*,
[../csi2rx_review.md](../csi2rx_review.md) mục 5); phiên bản chính xác đưa vào từng tính năng
**[CHƯA CHẮC]**.

### 1.3 Ngoài phạm vi

- C-PHY, A-PHY, D-PHY TX trên ASIC, DSI, lane hai chiều (turnaround, contention detect,
  `TurnRequest`/`Direction`): bộ thu camera không cần [S1][S4].
- D-PHY trên 2,5 Gbit/s: equalization phía thu (CTLE, đánh dấu từ v3.0 [S13]), alternate
  calibration (ACS) [S4][S5][S9], preamble, embedded clock (v3.5 [S13]).
- Thiết kế mạch analog: tài liệu chỉ đặt giao diện và yêu cầu; kiến trúc mạch, layout, ESD và
  đặc tính điện là việc của đội analog.
- Các tính năng CSI-2 từ v3.0 trở đi (ví dụ bảo mật CSE mà review đã nêu).
- Nhiều PHY hay nhiều cảm biến trên một controller, router N luồng, AXI4 master ghi DDR: kiến
  trúc để ngỏ (mục 6.5), đặc tả riêng sau.
- Thay đổi ISP (2 pixel/clock, RAW12): theo [../csi2rx_review.md](../csi2rx_review.md) mục 7.

### 1.4 Số liệu bo làm đầu vào

| Số liệu (2026-11-09/10) | Dùng ở |
|---|---|
| Huins + IMX274 (lần 1–3): trễ BISC ở mép dưới (tap nhỏ) của eye trên cả 4 lane, cách tâm 98…178 tap = 0,26–0,48 UI (1 tap ≈ 1,87 ps, 1 UI ≈ 374 tap, đo lần 3); eye ~352–360 tap; ở trễ BISC có lỗi CRC (~11 % dòng ở lần 1, 0,2–1,5 lỗi mỗi frame ở lần 2–3); BISC cho cùng kết quả khi cảm biến còn bị reset (LP-00) và khi đang stream | hiệu chỉnh dựa trên dữ liệu, `DLYn.OWN` (mục 3.5, 7) |
| Huins: reset FIFO RX của XPHY mỗi lần cổng byte clock đóng (PA5 = 1; trong mã gọi là "mỗi burst") sạch với `SETTLE` 65–170 ns; PA5 = 0 hỏng sau lần bật lại bộ thu đầu tiên. Cổng chỉ đóng khi lane clock rời HS, nên với IMX274 reset này xảy ra mỗi frame, không phải mỗi burst dữ liệu | `des_rst` bắt buộc, theo mỗi lần mở cổng (mục 3.2, 7.1) |
| IMX274: đúng một packet mỗi HS burst (1091 burst mỗi frame 1080p) | giả định "một packet mỗi burst" của lớp packet vẫn đúng; LRTE chỉ ở đường v2.x |
| IMX274 (và IMX219): lane clock vào HS một lần mỗi frame, LP-11 trong vertical blanking | byte clock chạy suốt frame; D-PHY và controller phải đúng cả khi clock dừng mỗi burst (DV có cả hai) |
| IMX274: standby là LP-00 trên cả 5 lane trước lần stream đầu | `WaitStop` không coi LP-00 là lỗi (mục 4.2) |
| IMX274: `b8` ngay sau HS-zero, lệch giữa lane 1 bit và ổn định; byte clock 180,078 MHz | ghép lane chịu lệch 6 byte clock là đủ |
| KV260 + IMX219: `SETTLE` 6…30 chu kỳ sạch, eye 256–272 tap `IDELAYE3`, tâm đổi theo route của mỗi lần build | adapter UltraScale+ (mục 3.7), eye walk (mục 7.3) |

## 2. Mô hình lớp và sơ đồ khối

### 2.1 Các lớp

```
 Lớp                ASIC                                     FPGA (KV260 / Huins)                     Chủ
 ─────────────────────────────────────────────────────────────────────────────────────────────────────────
 L0 cảm biến        module camera (D-PHY TX)                 IMX219 / IMX274; bow_dphy_tx (loopback)   ngoài / DV
 L1 AFE             macro analog D-PHY RX                     bow_dphy_io_xusp / bow_dphy_io_versal     analog
 ══ giao diện AFE ═════════════════════════════════════════════════════════════════════════════════════════
 L2 D-PHY số        bow_dphy_rx (std cell)                    bow_dphy_rx (cùng RTL)                    PHY số
 ══ PPI (bow_ppi_pkg) ═════════════════════════════════════════════════════════════════════════════════════
 L3 CSI-2 RX        bow_csi2rx: ghép lane, packet, unpack     bow_csi2rx (cùng RTL)                     controller
 ══ AXI4-Stream (pixel) · APB / bus Bow32 (thanh ghi) ═════════════════════════════════════════════════════
 L4 ứng dụng        ISP, DMA, NPU                             ISP Bow32, VRAM                           SoC
```

### 2.2 Sơ đồ khối

```
 chân P/N (lane clock + data lane)      bow_mipi_rx (wrapper Bow32: cửa sổ 4 KiB, ngắt)
     │          ┌──────────────────────────────────────────────────────────────────────────┐
     ▼          │                                                                          │
  ┌──────┐ AFE  │  ┌──────────────────────────┐   PPI   ┌─────────────────────────────┐    │  m_axis RAW10
  │ AFE  │══════╪═►│ bow_dphy_rx              │════════►│ bow_csi2rx                  │────┼──► ISP
  │      │◄═════╪══│ máy LP, timer, termin.,  │         │ ghép lane, packet (ECC,     │    │
  └──────┘      │  │ cổng clock, SoT + căn,   │         │ CRC, VC/DT), unpack, FIFO,  │    │
  HS RX, term,  │  │ deskew, lỗi, ULPS, RAW   │         │ LOG                         │    │
  LP RX, 1:8,   │  │ thanh ghi @ 0xC00        │         │ thanh ghi @ 0x000           │    │
  chia, delay   │  └────────────▲─────────────┘         └──────────────▲──────────────┘    │
                │               └────────────── bus (clk_i) ───────────┴───────────────────┼──► periph 0x4000_8000
                └──────────────────────────────────────────────────────────────────────────┘
 FPGA: AFE = bow_dphy_io_xusp (IBUFDS_DPHY, IDELAYE3, ISERDESE3, BUFGCE_DIV) hoặc
             bow_dphy_io_versal (IBUFDS_DPHY, XPHY native strobe, XPLL, BUFGCE); phần còn lại: cùng RTL
```
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
