thanhbinh89/Bow32/crop.png

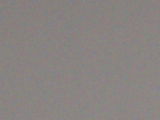
crop.png
