thanhbinh89/Bow32/docs/fpga/ram_extension/FMC_DDR2_HyperRam.PDF

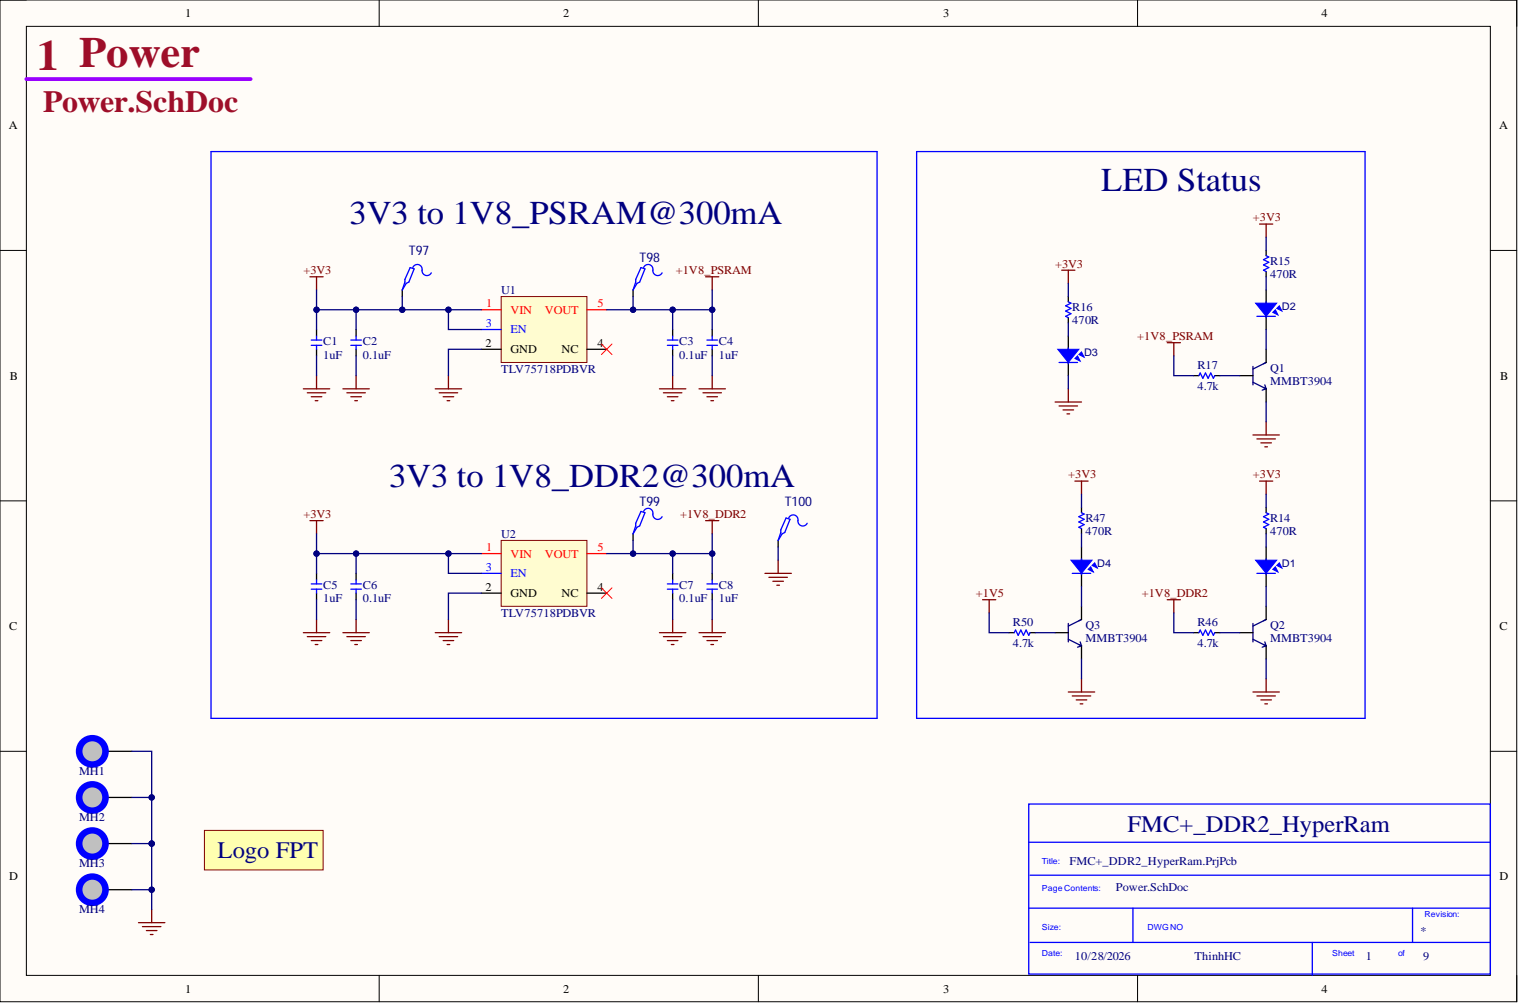
[picture p2: page 1]

S i z e : | DWG N O | R e v i s i o n : *

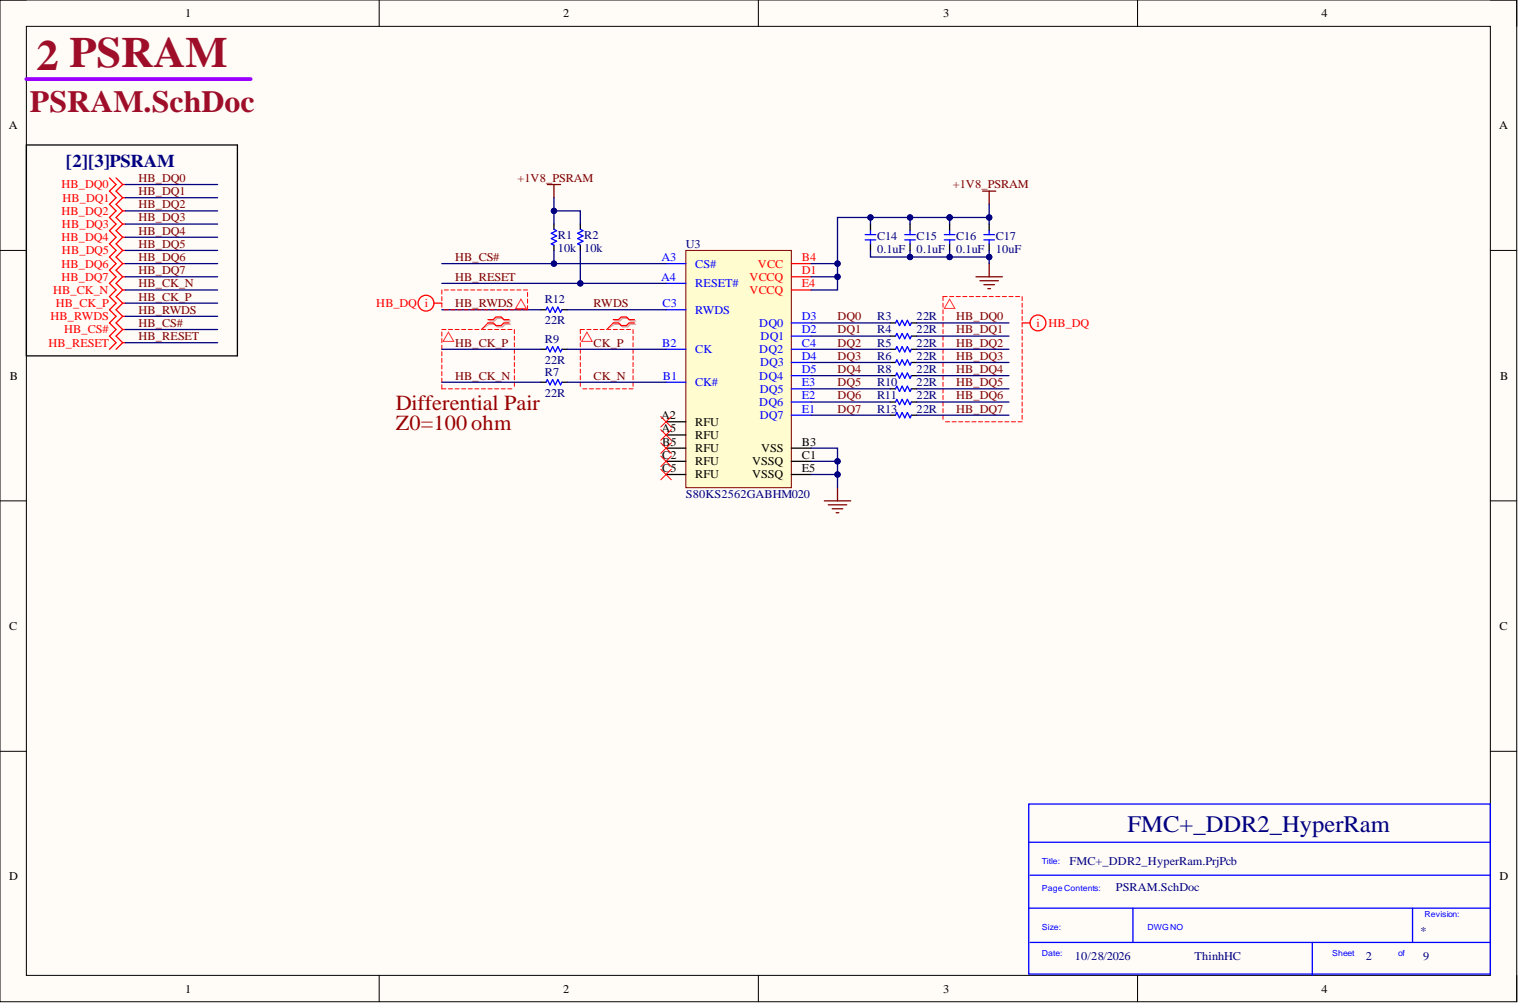
[picture p3: page 2]

CK B2 CK# B1 RFU B5 RFU C2 RFU C5

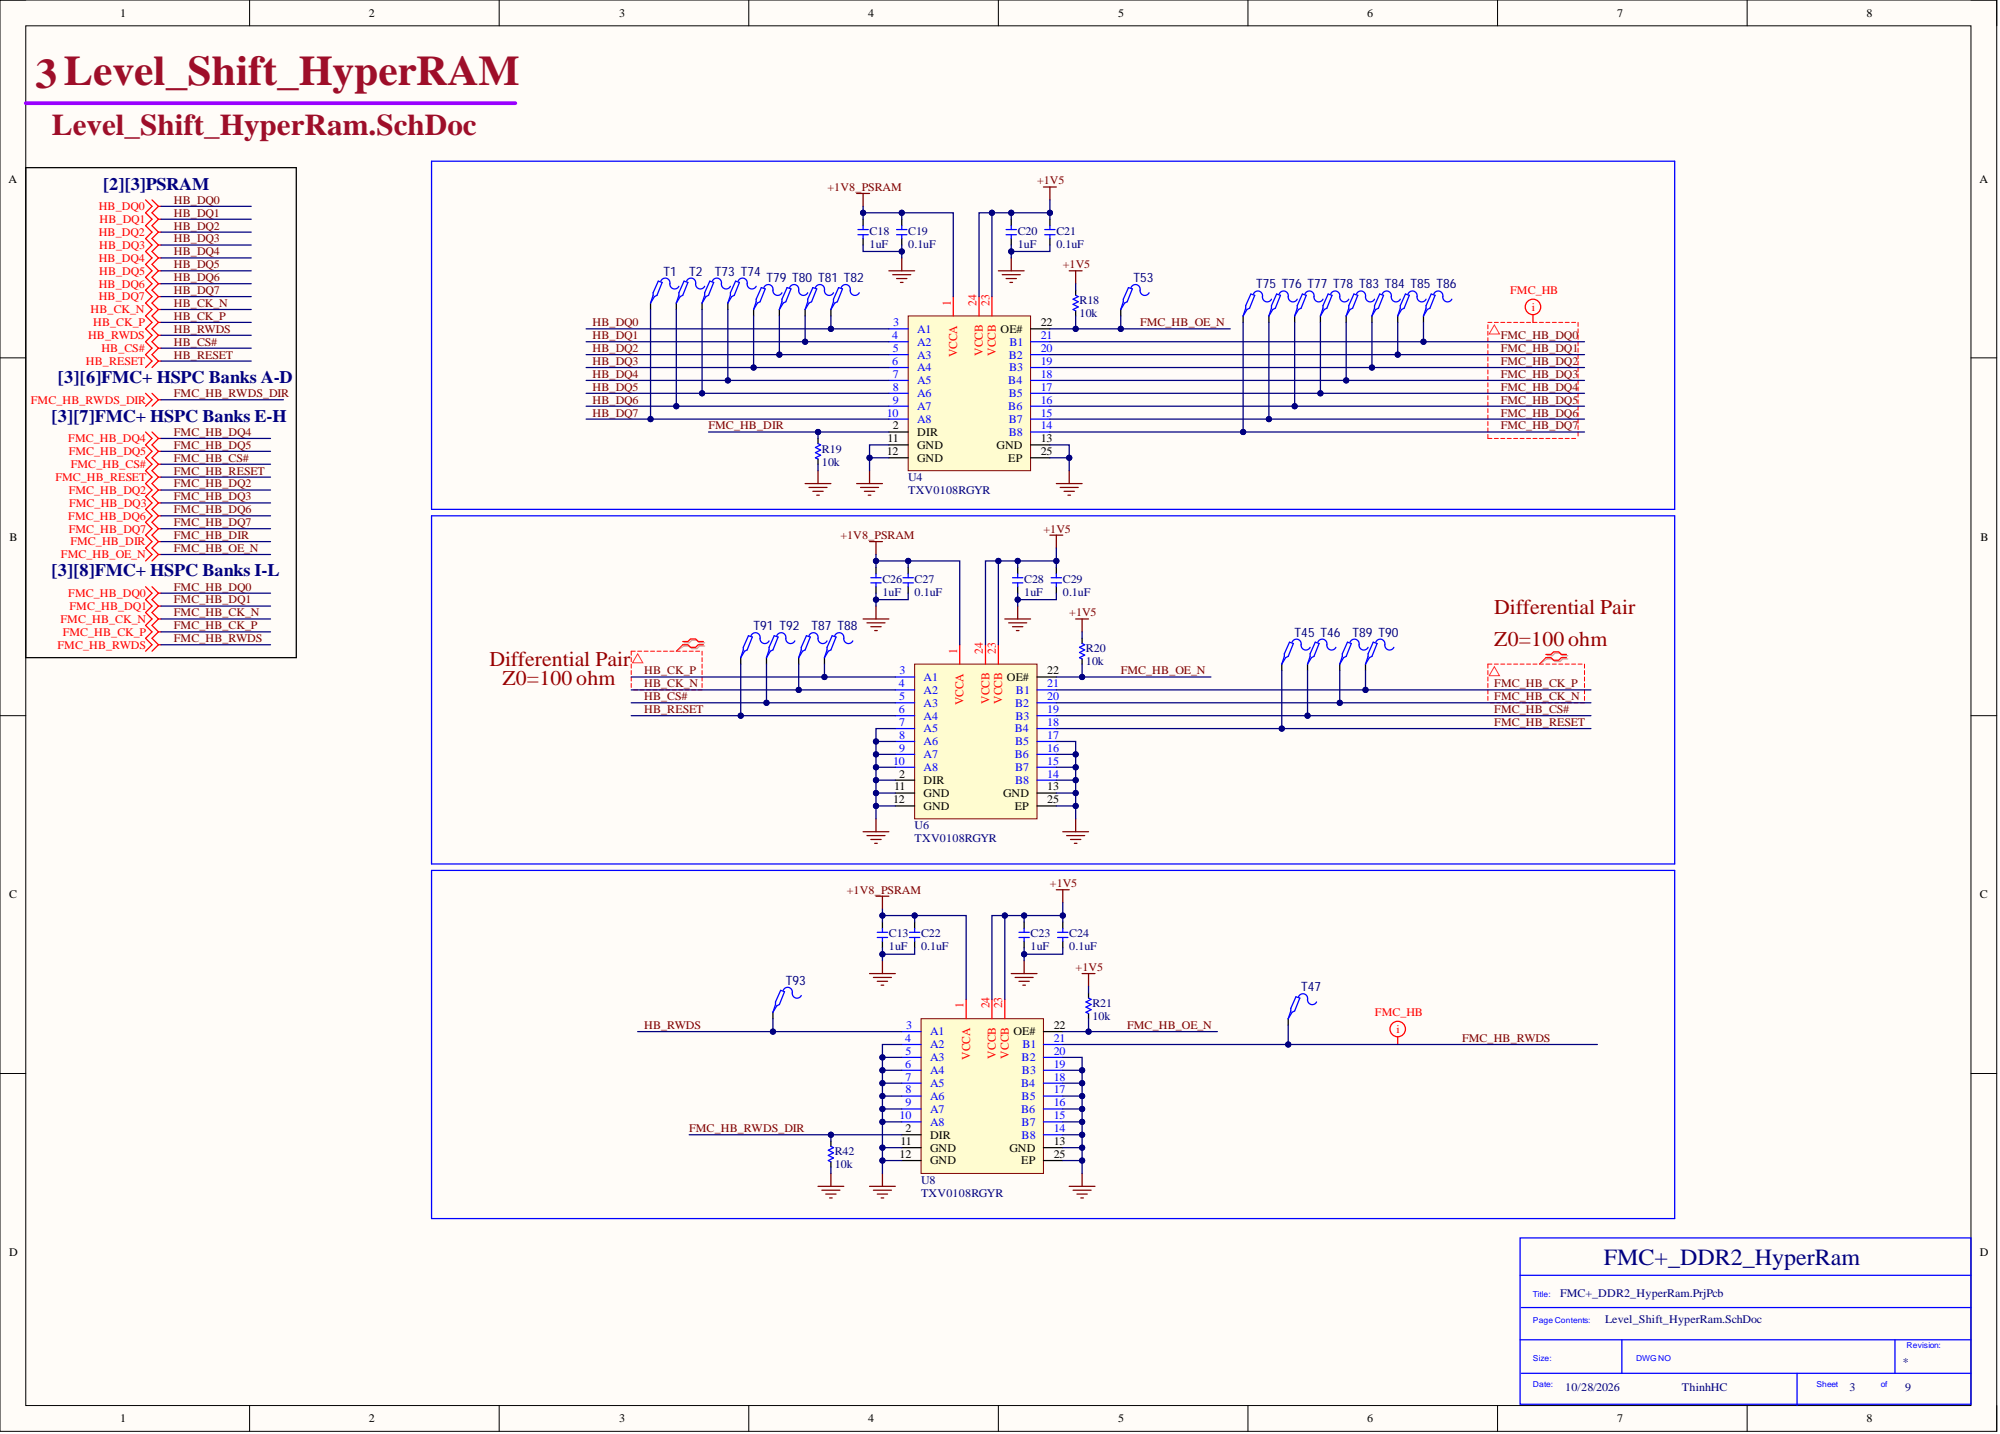
[picture p4: page 3]

14 B7 15 B6 16 B5 17 B4 18 B3 19 B2 20 B1 21 OE# 22 3 B8 | FMC_ HB_ D Q 2

FMC_ HB_ D Q 1

FMC_ HB_ D Q 3
FMC_ HB_ D Q 4
FMC_ HB_ D Q 5
FMC_ HB_ D Q 6
FMC_ HB_ D Q 7

1 0
1 1 | 1
1 2 | 2 | 5

2 1 1

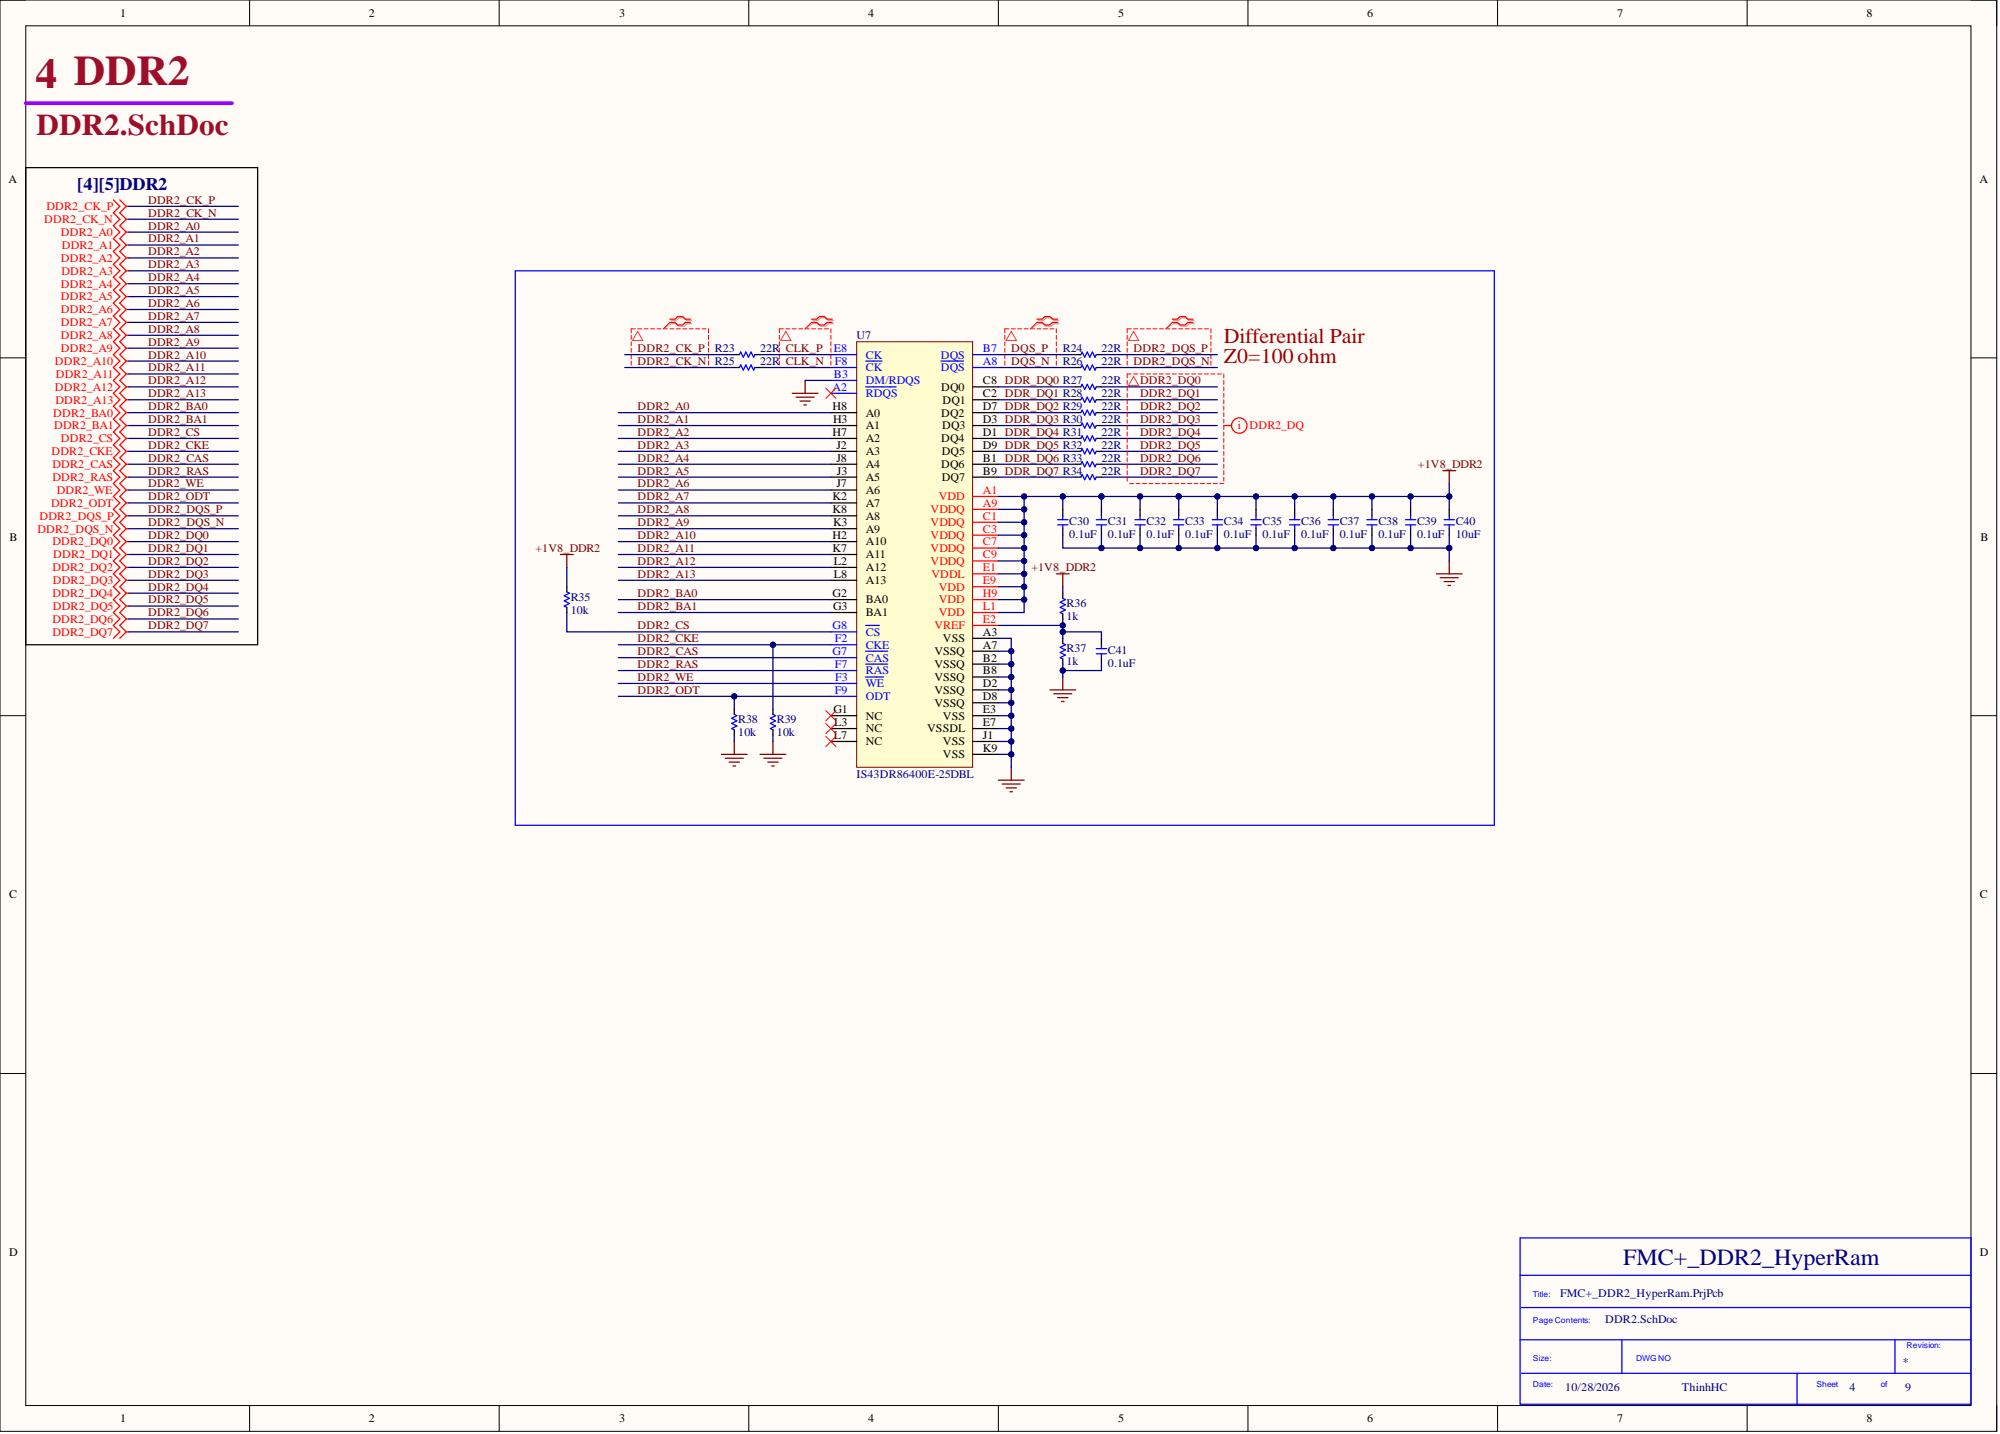
[picture p5: page 4]

E 1
E 9
H 9

A 3
A 7 | | R3 7 1 k

D 2
D 8
E 3

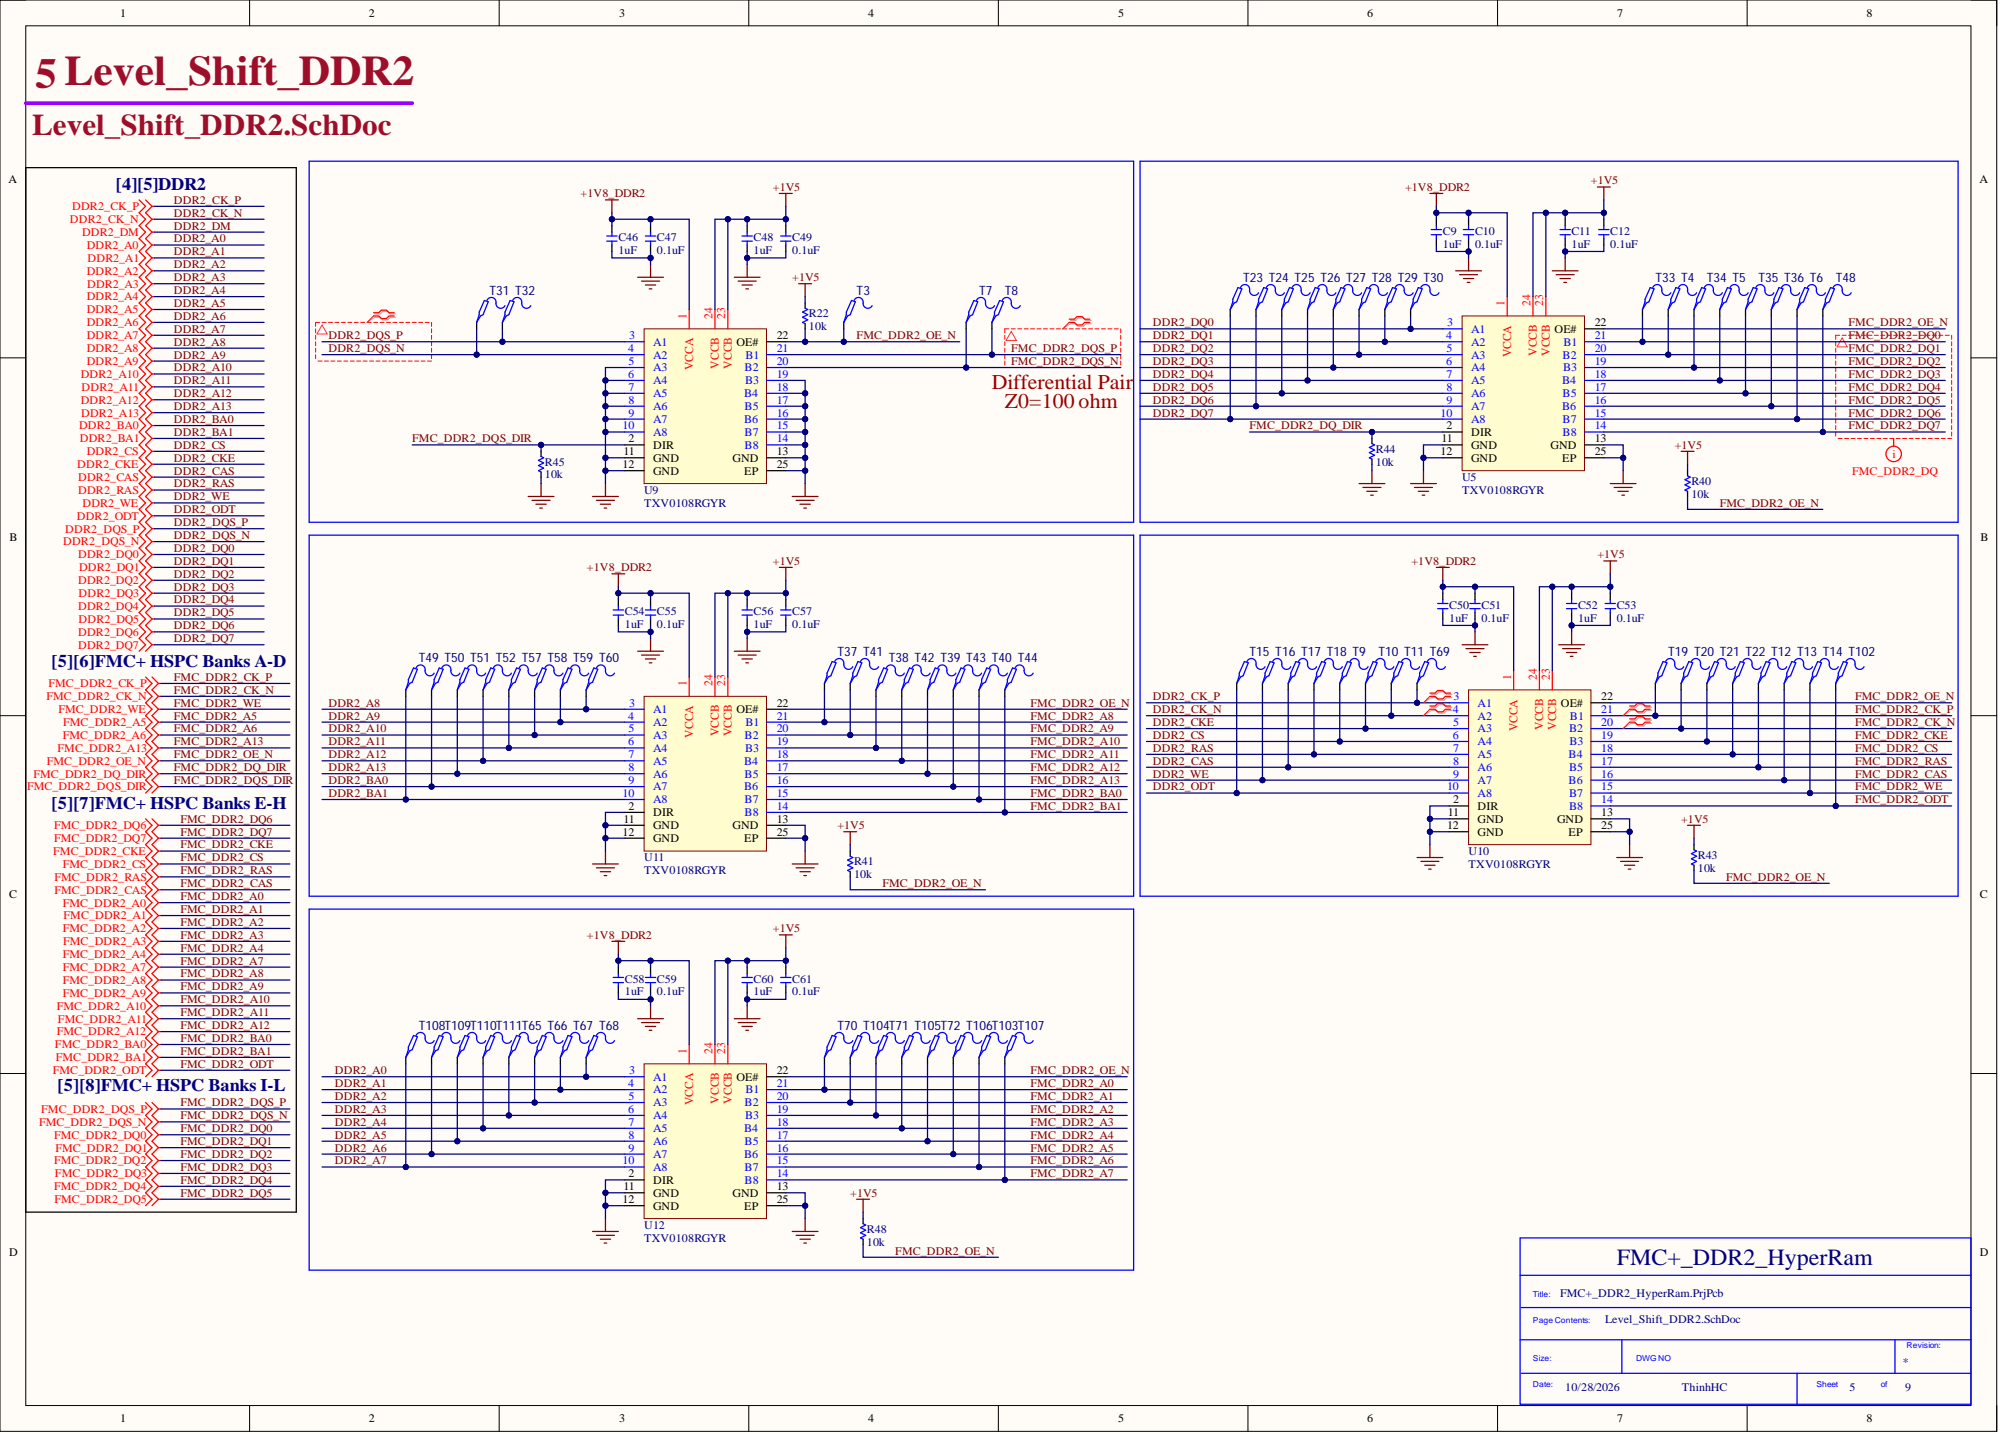
[picture p6: page 5]

FMC_ D DR2 _ C K_P
FMC_ D DR2 _ C K_N
FMC_ D DR2 _ C KE
FMC_ D DR2 _ C S
D DR2 _ RA S

D DR2 _ C A S
D DR2 _W E

1 1 | 1
1 2 | 2 5

1 1
1 2 | 2 | 5

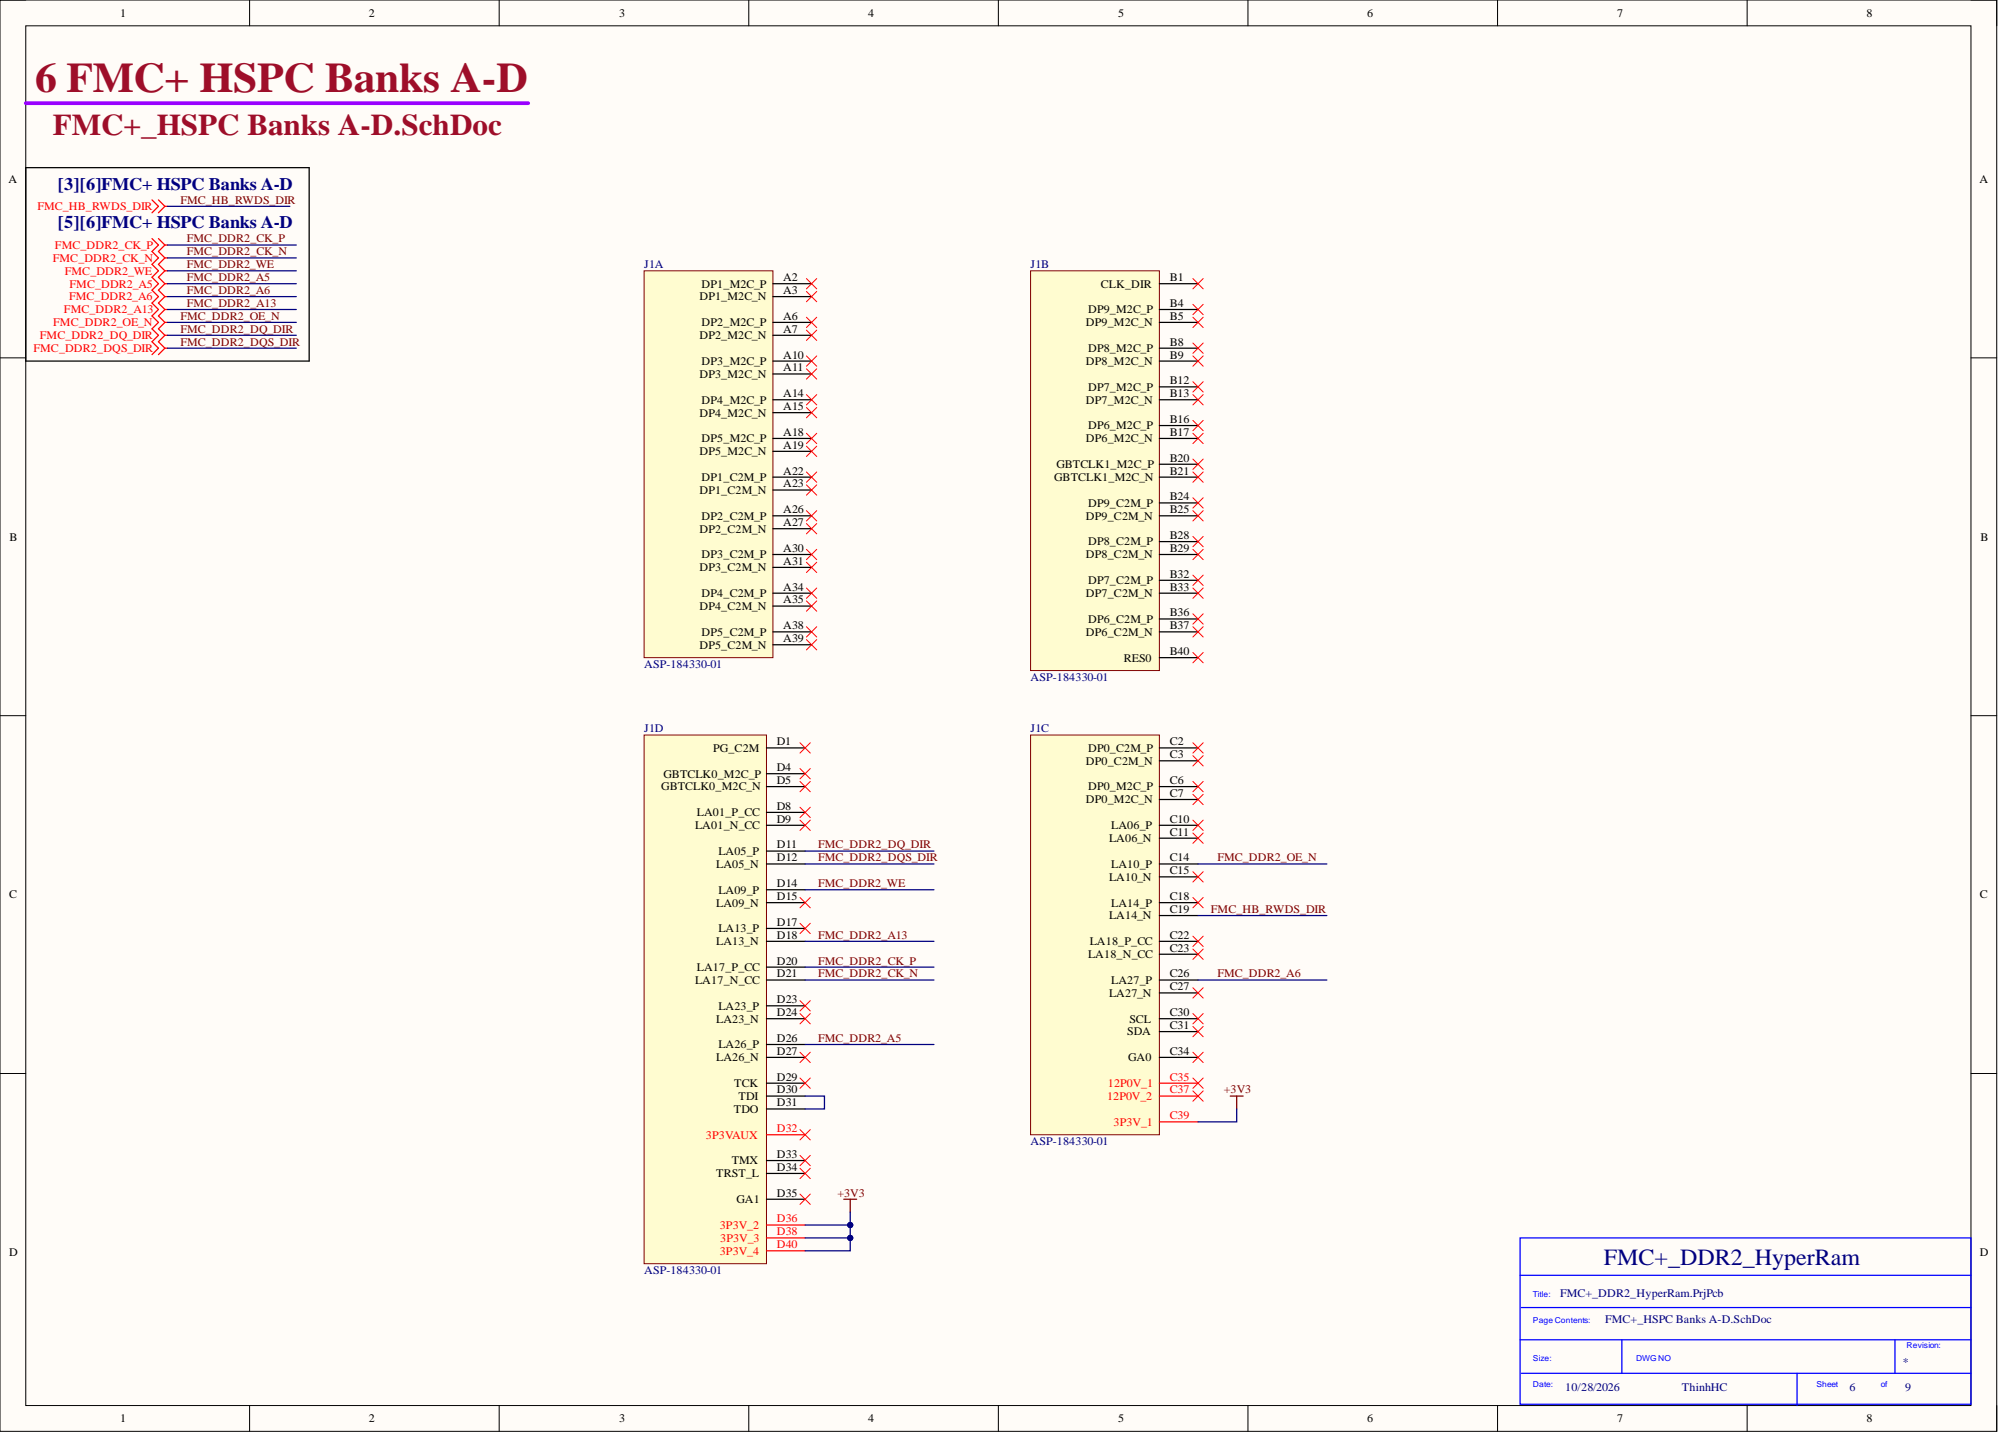
[picture p7: page 6]

FMC+_HSPC Banks A-D.SchDoc 6 FMC+ HSPC Banks A-D

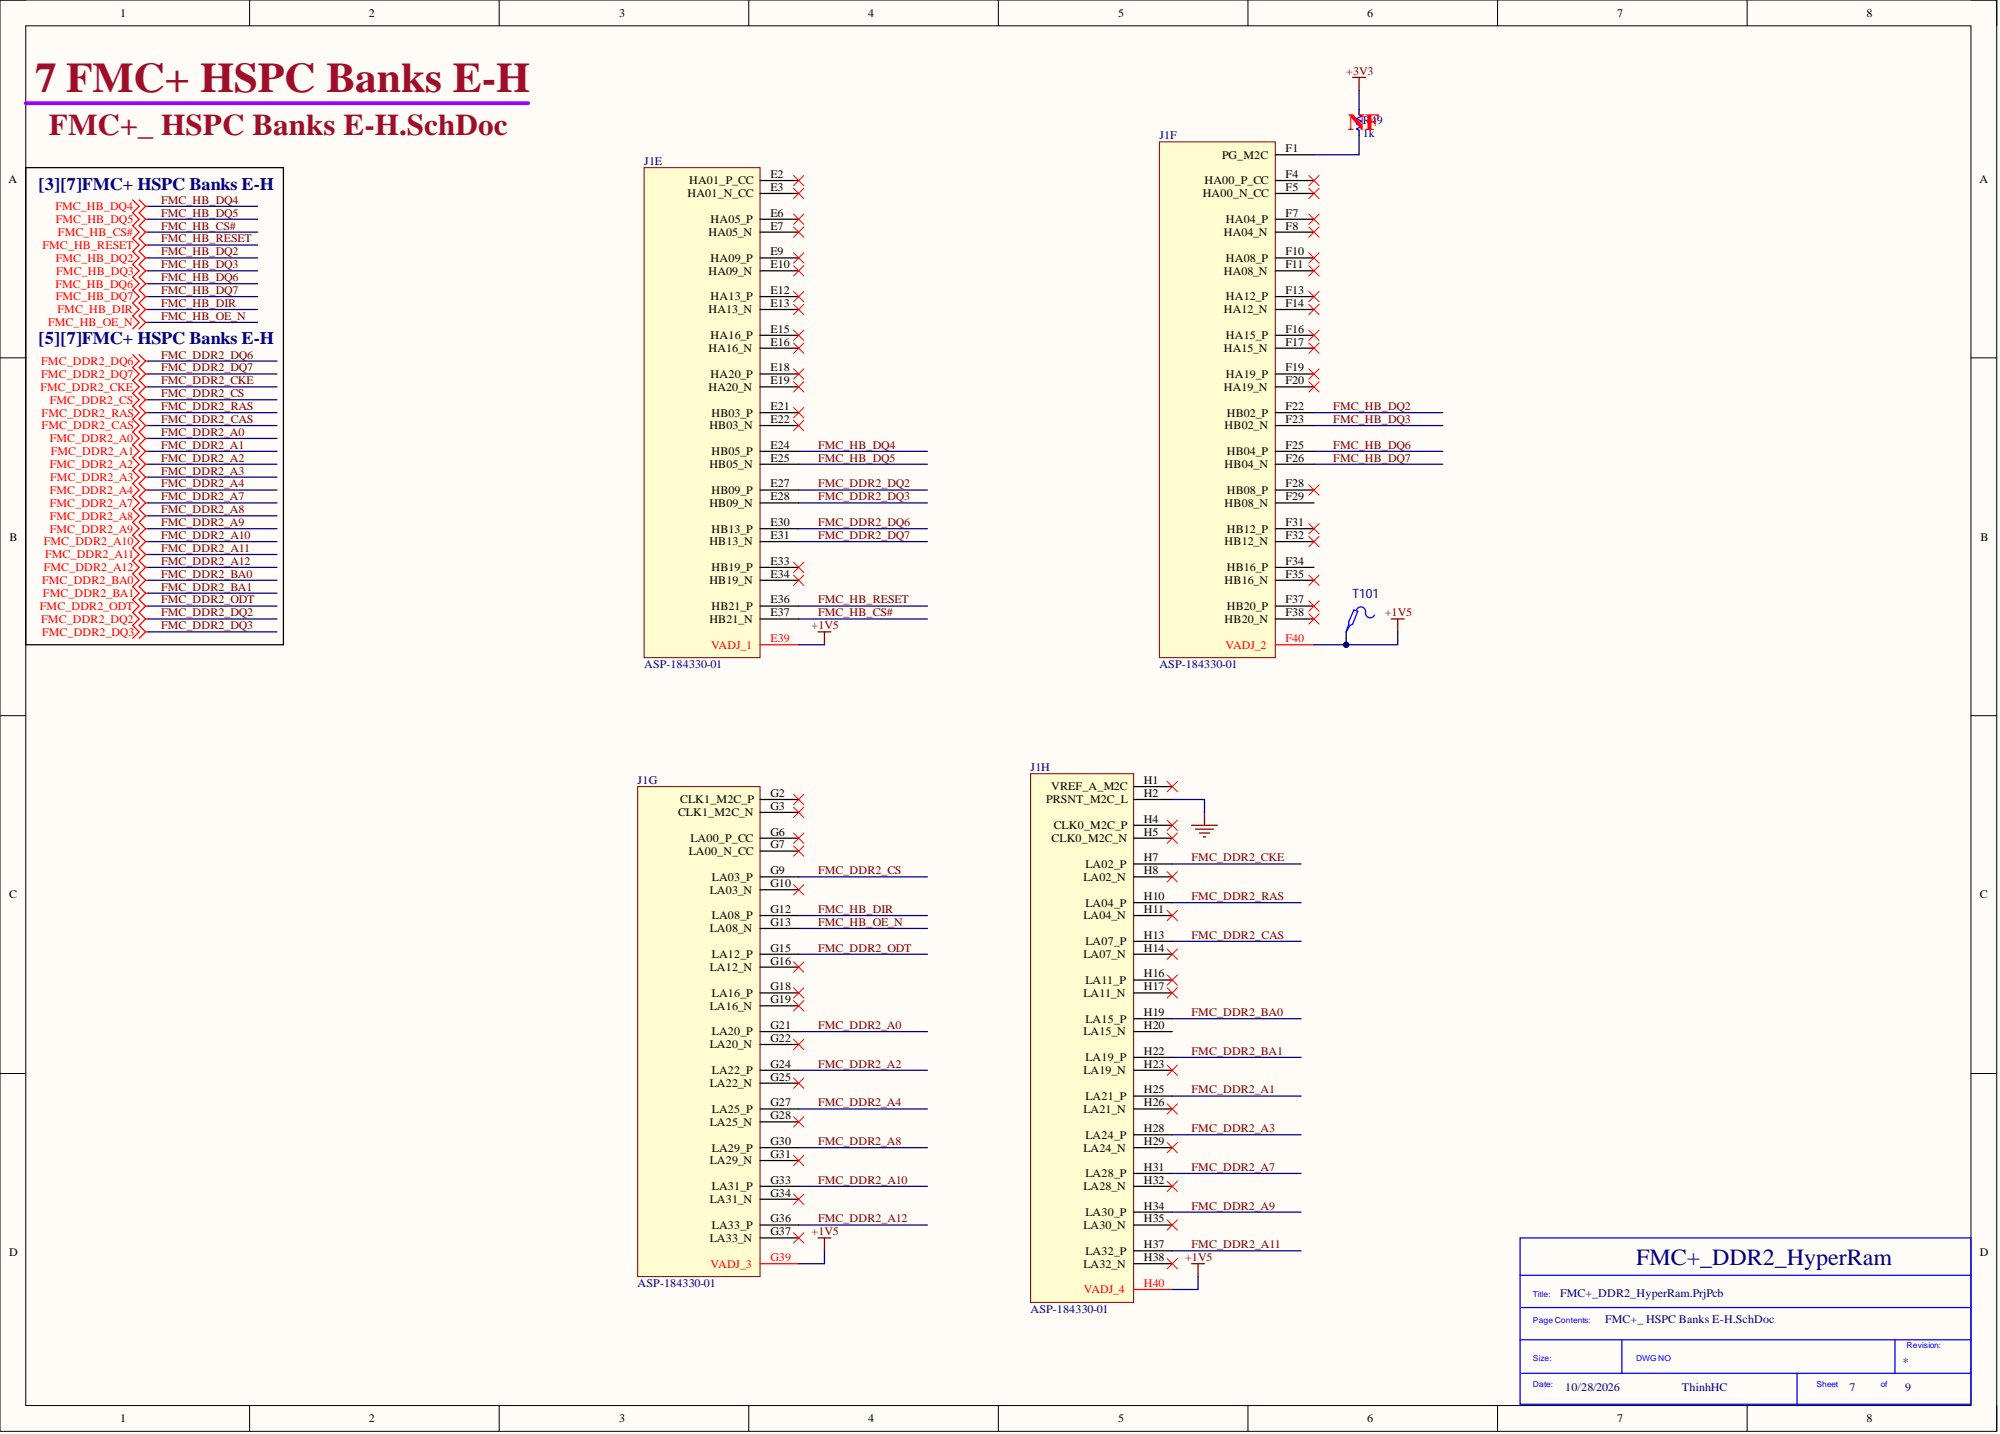
[picture p8: page 7]

FMC+_ HSPC Banks E-H.SchDoc 7 FMC+ HSPC Banks E-H

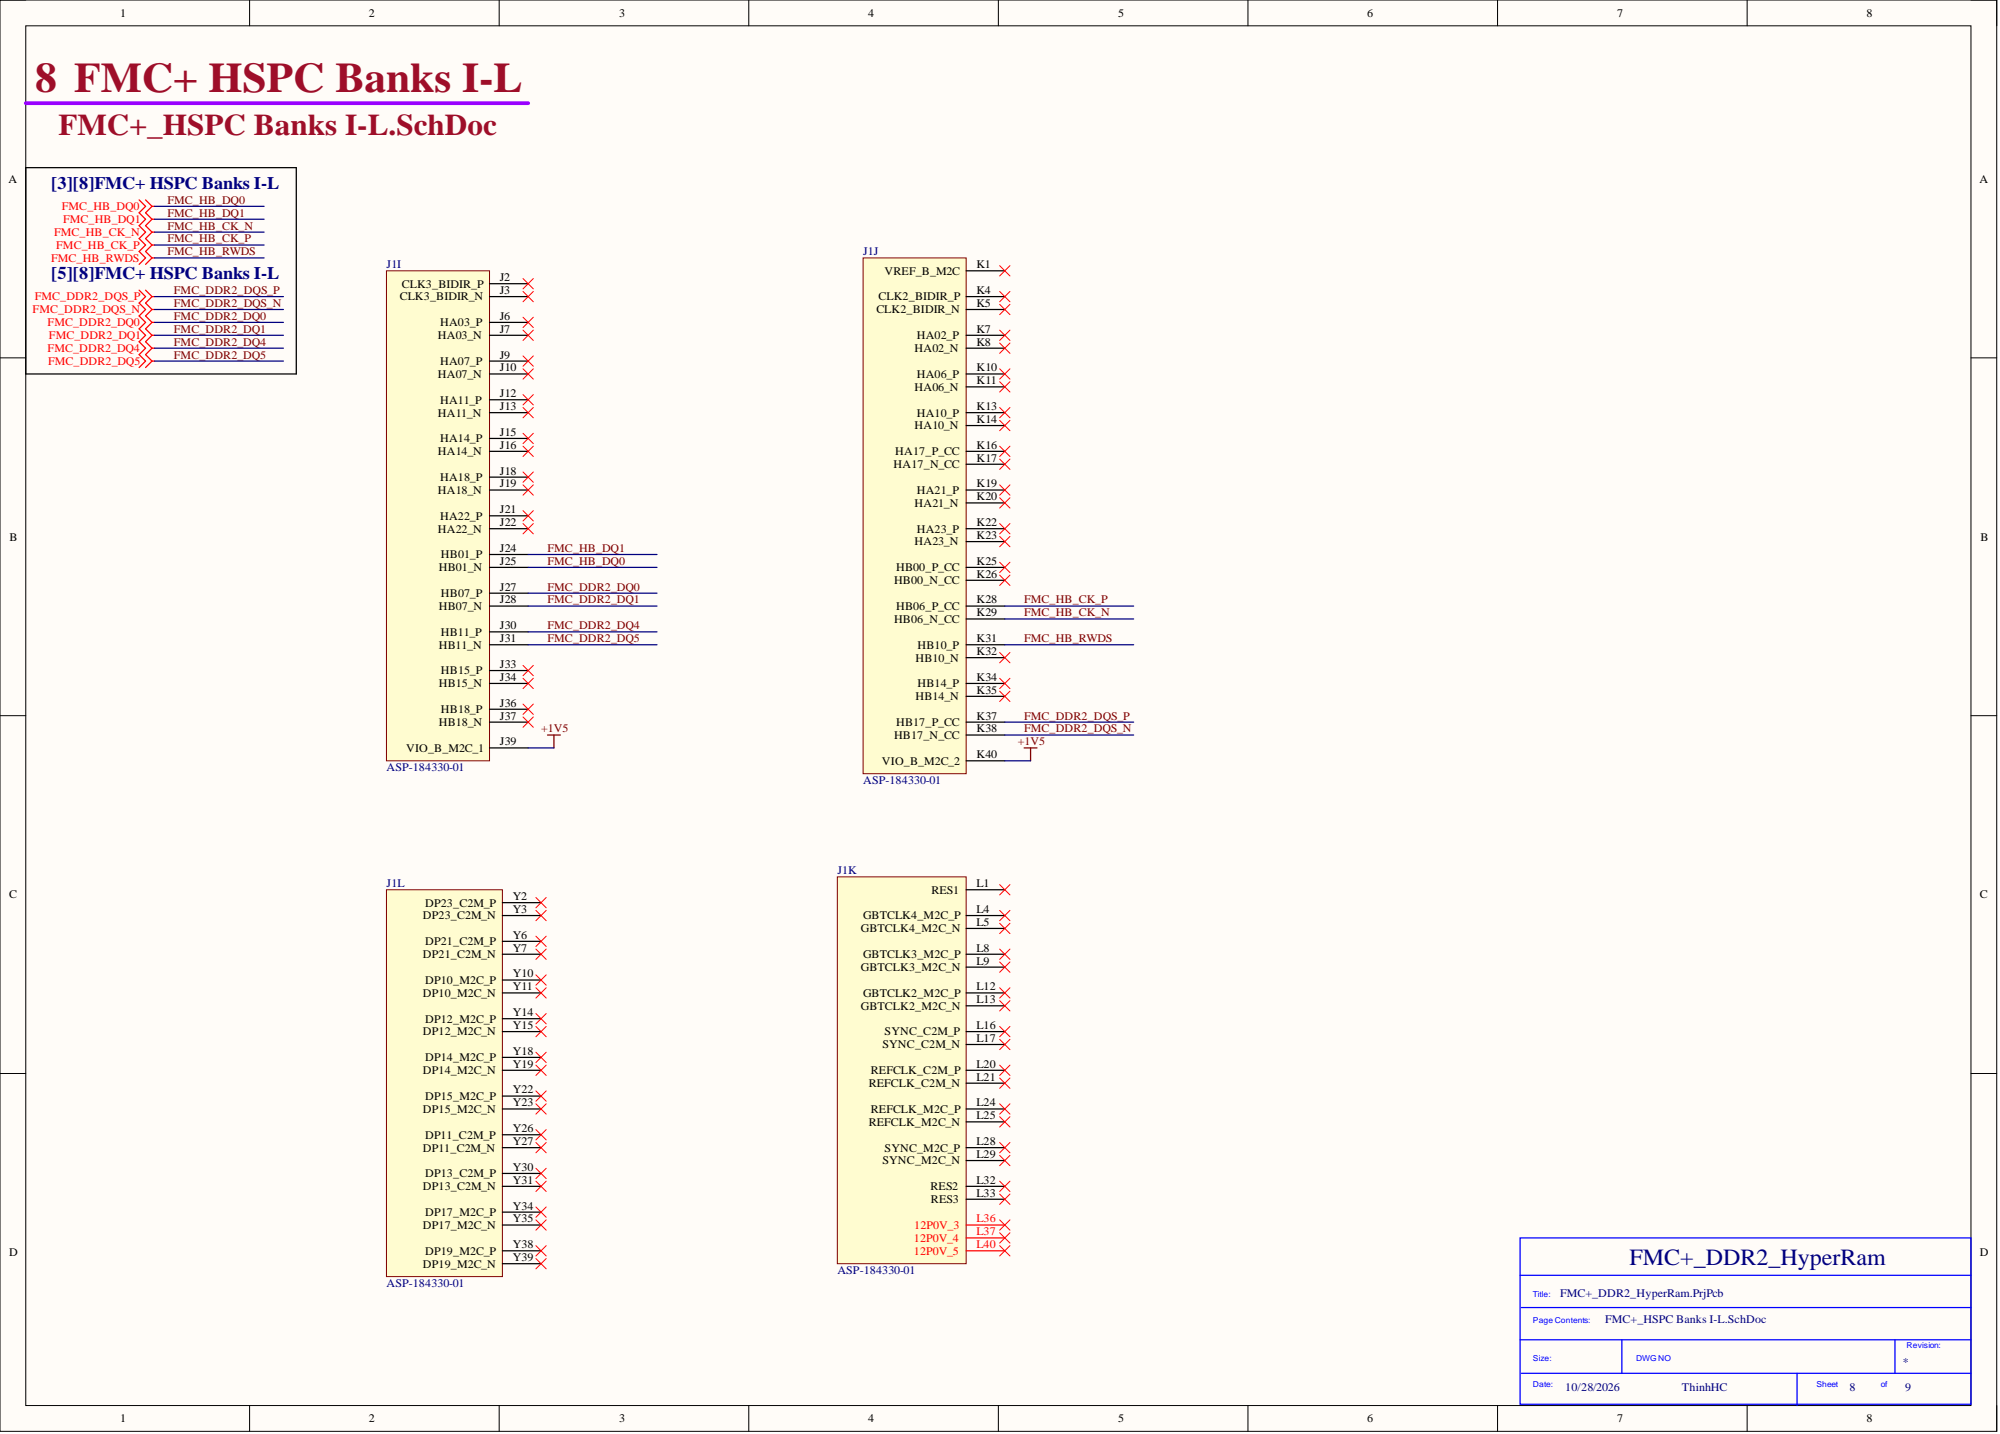
[picture p9: page 8]

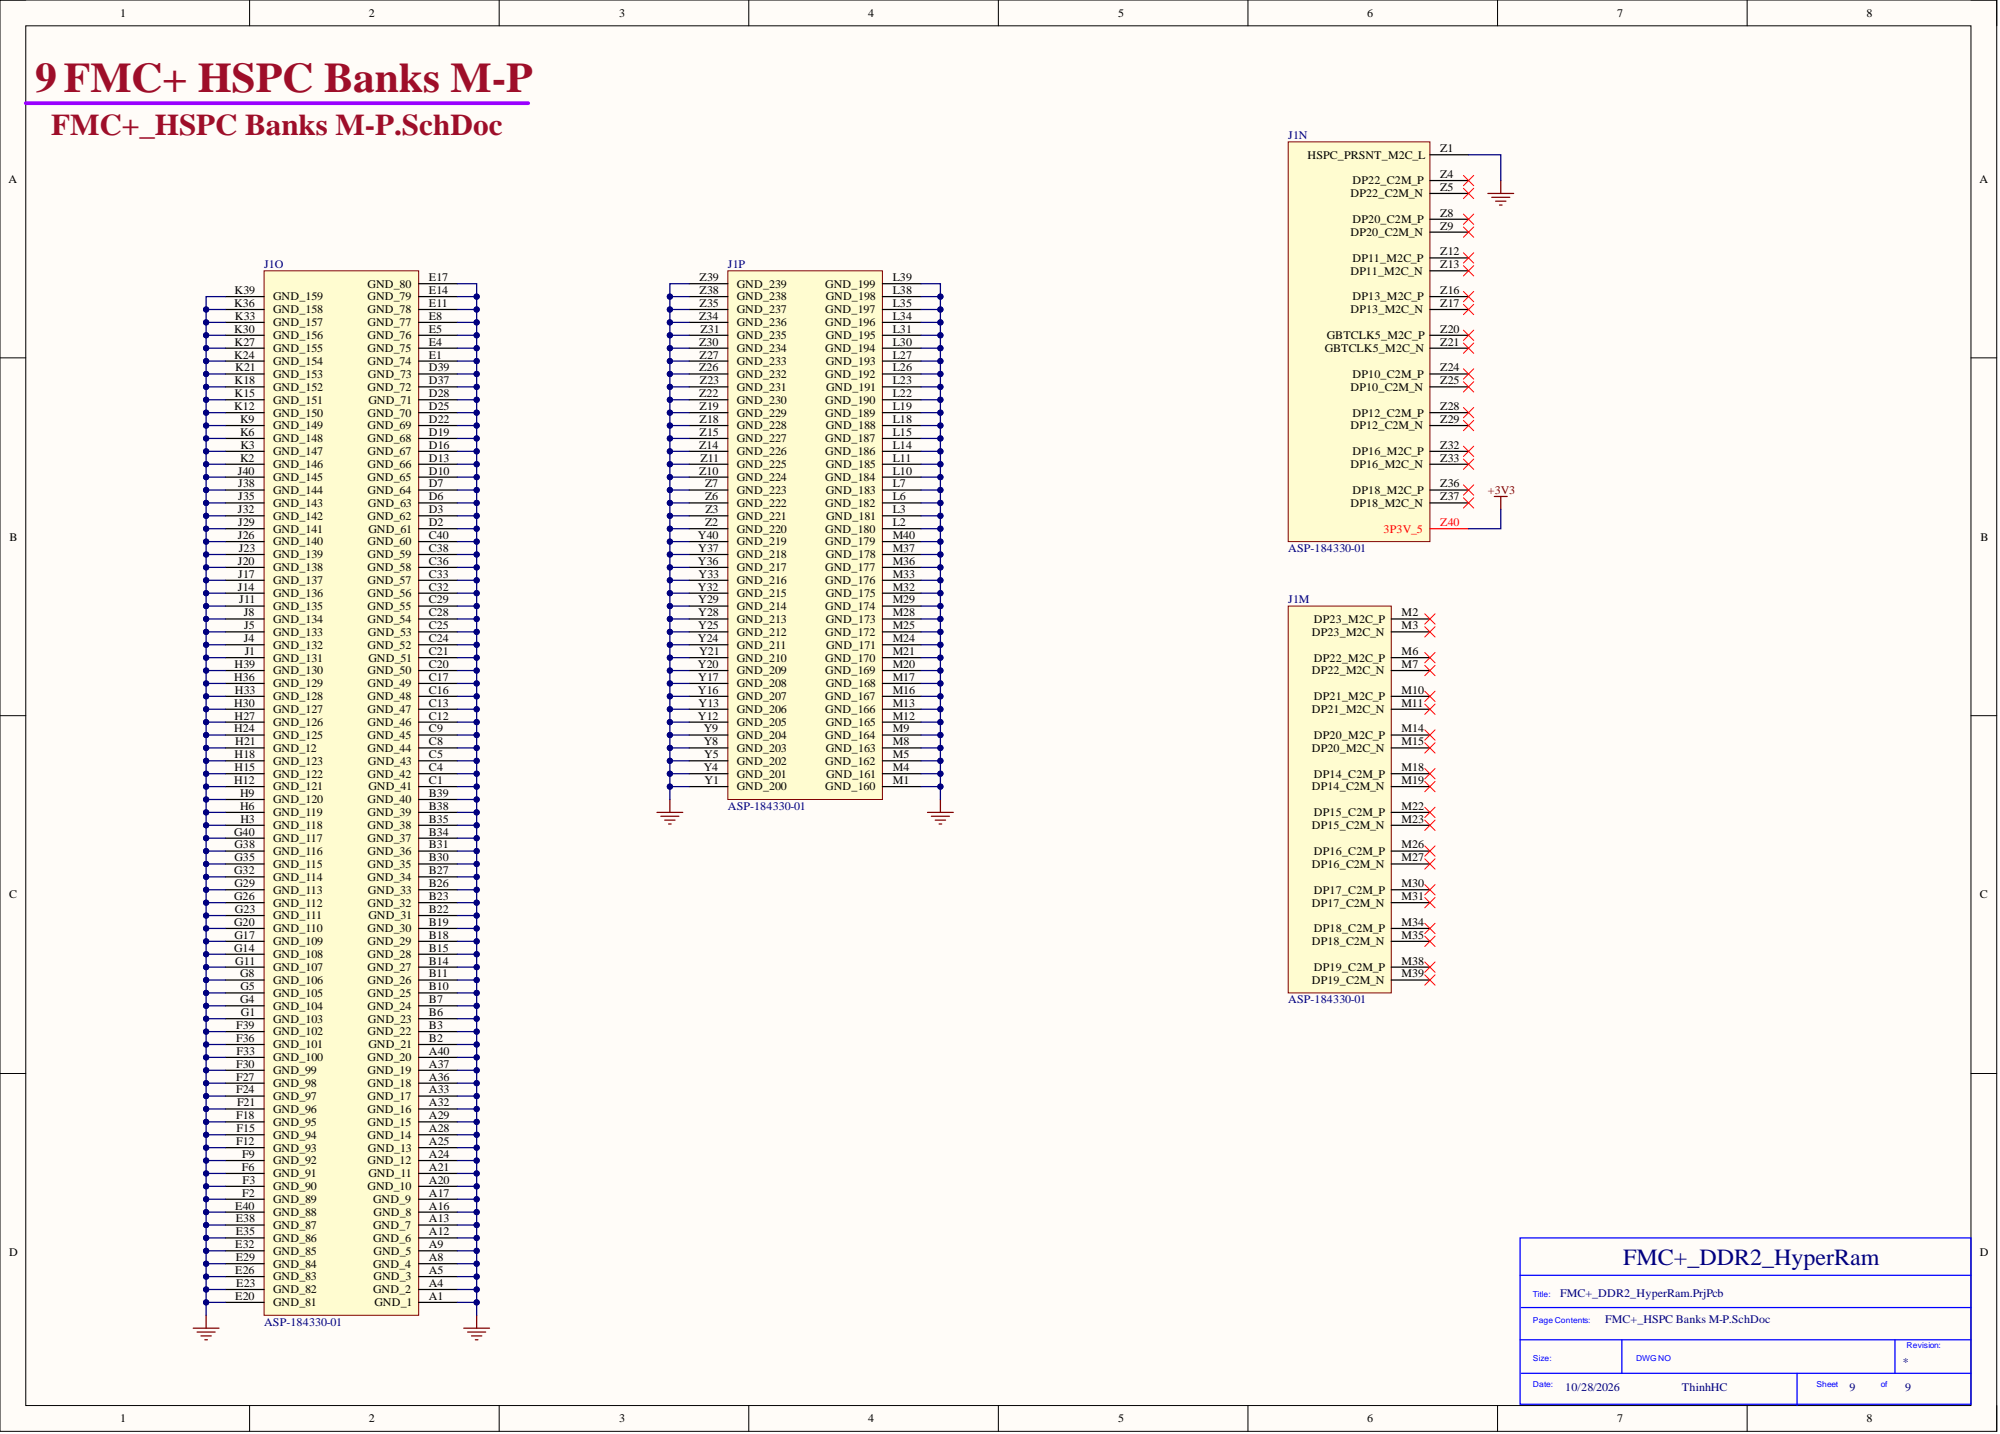
[picture p10: page 9]

GND_120 H9
GND_119 H6
GND_118 H3
GND_117 G40
GND_116 G38
GND_115 G35
GND_114 G32
GND_113 G29

GND_110 G20 GND_111 G23

GND_109 G17
GND_108 G14
GND_107 G11
GND_106 G8
GND_105 G5
GND_104 G4
GND_103 G1
GND_102 F39
GND_101 F36
GND_100 F33
GND_99 F30
GND_98 F27
GND_97 F24
GND_96 F21
GND_95 F18
GND_94 F15
GND_93 F12
GND_92 F9
GND_91 F6
GND_90 F3
GND_89 F2
GND_88 E40
GND_87 E38
GND_85 E32 GND_86 E35

GND_84 E29
GND_83 E26

GND_81 E20

Size: | DWG NO | Revision:

Date: 10/28/2026 ThinhHC | Sheet of 9 9

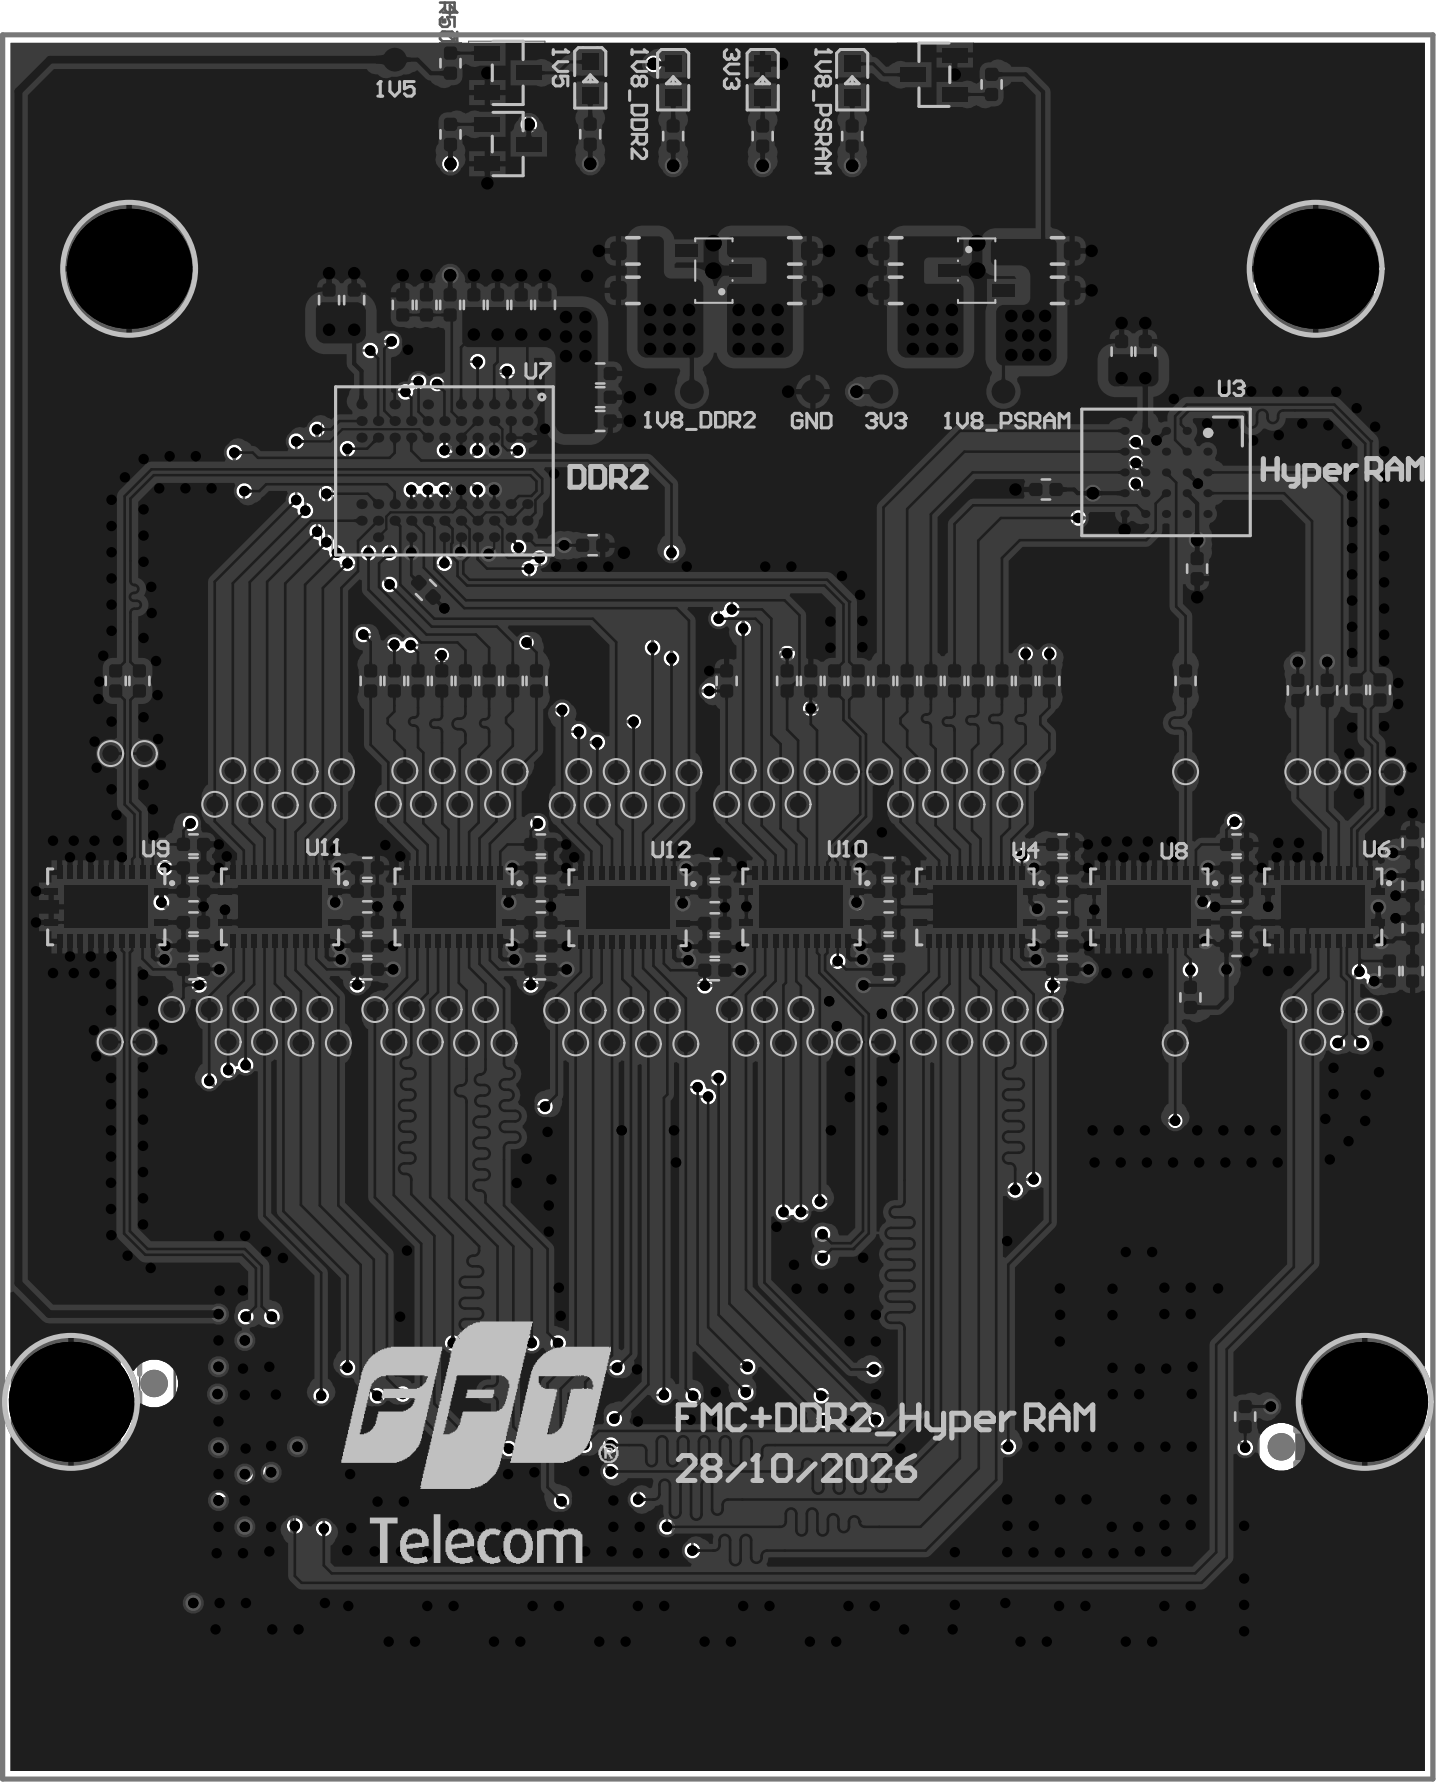
[picture p11: page 10]

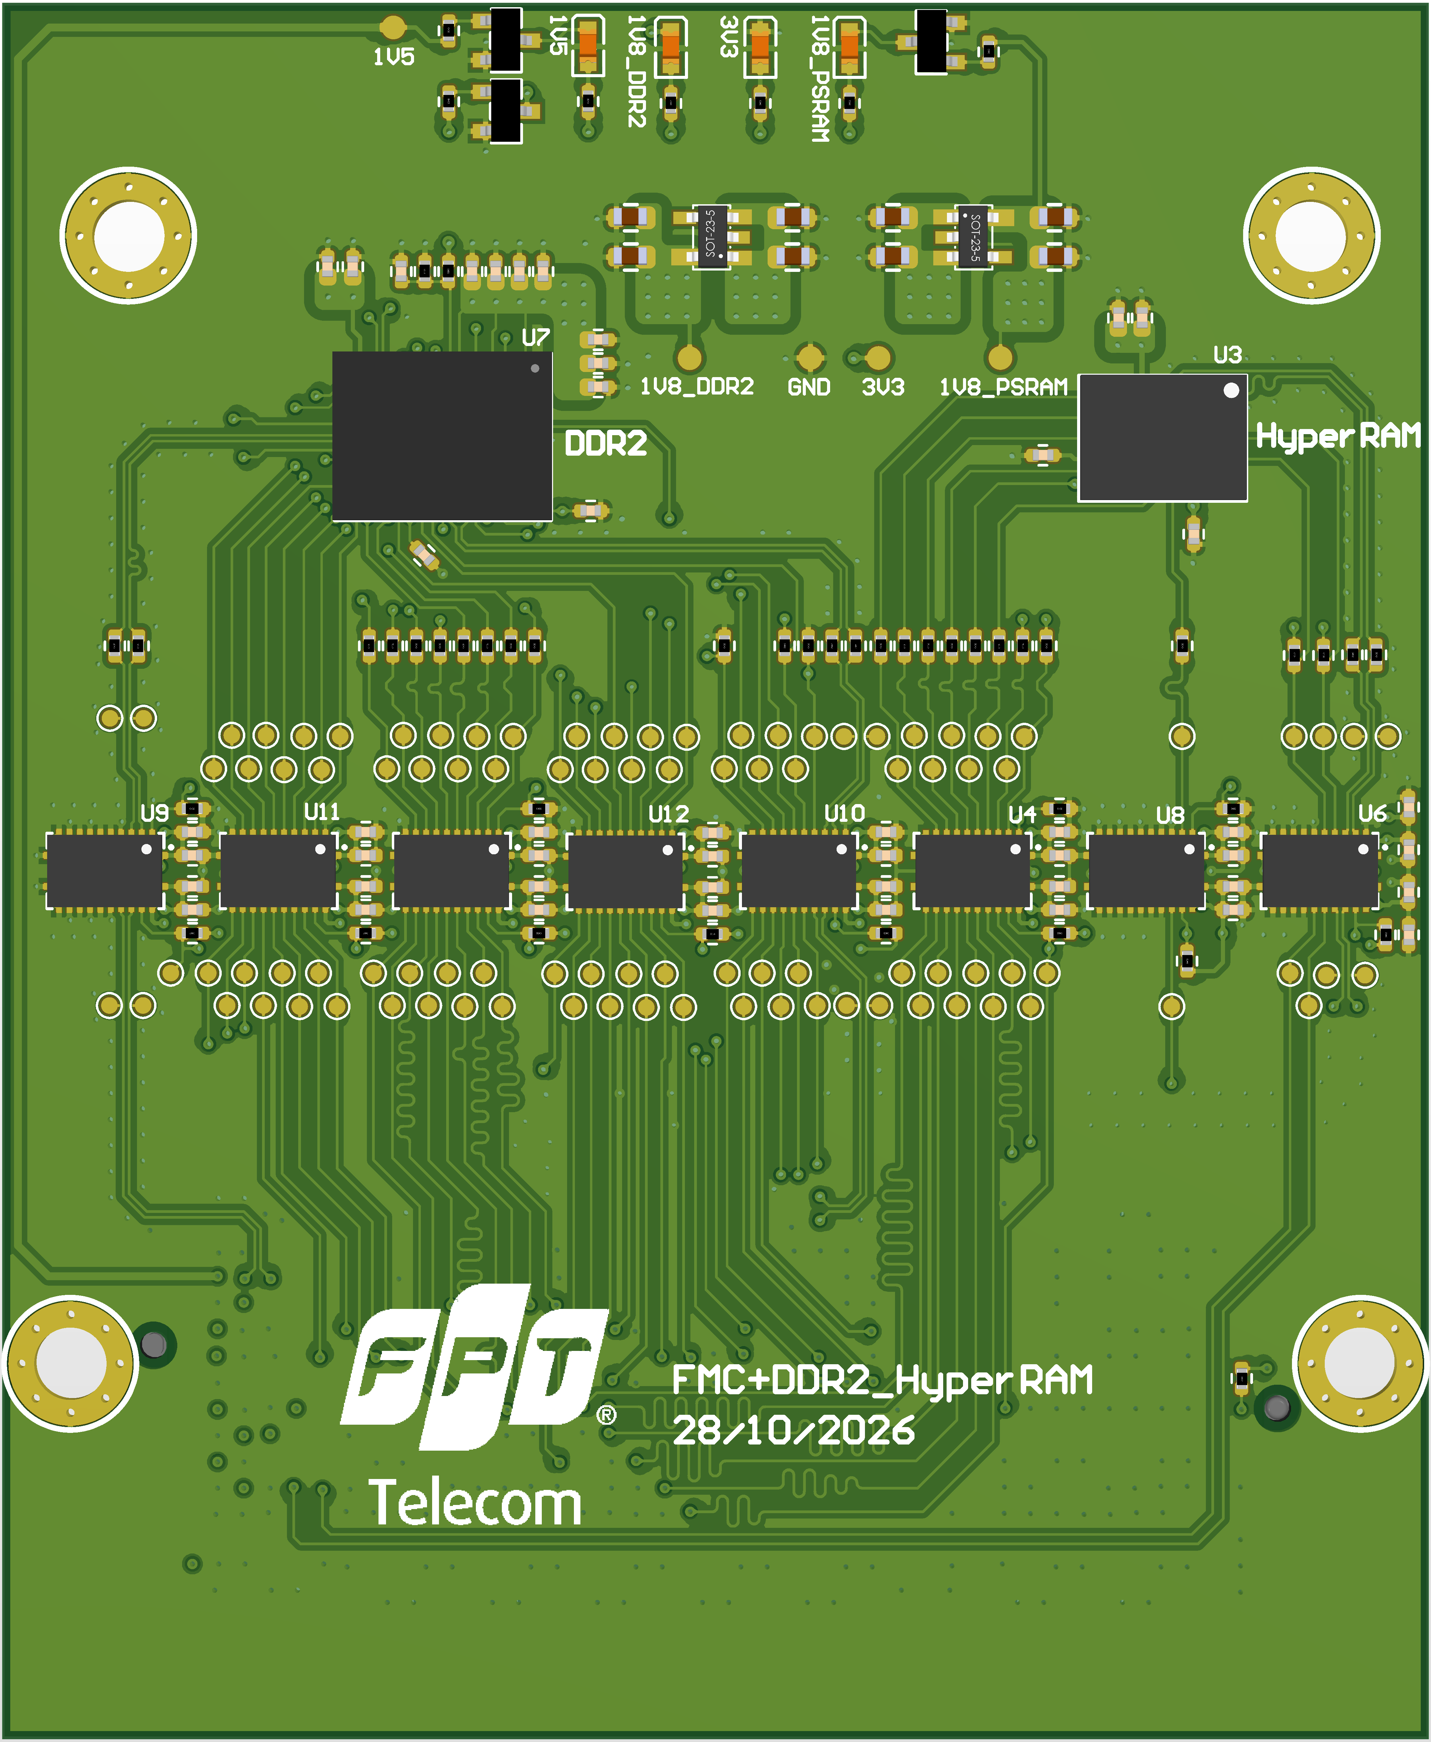
[picture p12: page 11]

# | Comment Designato | | Footprint LCSC Part NumbManufacturer Part Numbe | | | Manufacturer | Quantity | Description | Assembly Type | Link

1 | 1uF | C1, C4, | _0603 | C15849 | CL10A105KB8NNNC | Samsung Electro-Mechanics | 4 | 1uF 0603 50V X5R ±20SM TAssem bly
2 | 0.1uF | C2, C3, | _0603 | C14663 | CC0603KRX7R9BB104 | YAGEO | 4 | 100nF 0603 50V X7R ±SMT Assembl y
3 | 1uF | C9, C11C_0402 | | C52923 | CL05A1 05KA 5NQNC | Sa msungElectro-Mechanics | 16 1uF 0402 25V X5R ±10SM TAssem bly
4 | 0.1uF | C10, C1C_0402 | | C1525 | CL05B10 4KO5NNNC | Sam sungElec tro-Mechanics | 3 0100nF040216VX7R±SMTAssembl y
5 | 10uF | C17, C4C_0402 | | C15525 | CL05A106MQ5NUNC | Samsung Electro-Mechanics | 2 | 10uF 0402 6.3V X5R ±2SMTAssemb ly
6 | LTST-C190YKT | D1, D2, LED 0603-RD_RED | | C125097 | LTST-C190YKT | Lite-On | 4 | -55℃~+85℃ 130° 2.1VSMTAssembly
7 | ASP-184330-01 | J1 | CONN-SMD_ASP-1C5159973 | | ASP-184330-01 | Samtec | 1 | 1.27mm 14 Copper alloSM TAssembly
8 | MMBT3904 | Q1, Q2,SOT-23-3_L2.9-W1.C 20526 | | | MMBT3904 | Changjiang Electronics Tech | 3 | MMBT3904 TRANSISTSMT Assembly
9 | 10k | R1, R2, | _0402 | C25744 | 0402W GF1002TCE | U NI-ROYAL(Uniroyal Elec) | 17 10kΩ 0402 62.5mW ThSMTAssembly
10 22R | | R3, R4, | _0402 | C25092 | 0402W GF2 20JTCE | UNI-ROYAL(Uniroyal Elec) | 2 | 22Ω0402 62.5mW ThiSM TAssembly
11 470R | | R14, R1R_0402 | | C25117 | 0402WGF4700TCE | UNI-ROYAL(Uniroyal Elec) | 4 | 470Ω 0402 62.5mW ThSMTAssembly
12 4.7k | | R17, R4R_042 | | C25900 | 0402WGF4701TCE | UNI-ROYAL(Uniroyal Elec) | 3 | 4.7kΩ 0402 62.5mW TSMTAssembly
13 1k | | R36, R3R_0402 | | C11702 | 0402WGF1001TCE | UNI-ROYAL(Uniroyal Elec) | 2 | 1kΩ 0402 62.5mW ThicSM TAssmbly
14 TLV75718PDBVR | | U1, U2 | SOT-23-5_L3.0-W1.C 507270 | | TLV75718PDBVR | Texas Instruments | 2 | -40℃~+125℃@(Tj) 1 1SMTAssembly
15 S80KS2562GABHM0U3 | | | FBGA-24_L8.0-W6.0C17443 433 | | S8 0K2562GABHM020 | Infineon Technologies | 1 | FBGA-24(6x8) MemorySMTAssembly
16 TXV0108RGYR | | U4, U5, | TQFN-2 4_L5.5-W 3.5C22428389 | | TXV0108RGYR | Texas Instruments | 8 | -40℃~+125℃ 1.14V~3.SM TAssembly
17 IS43DR86400E-25DU7 | | | BGA60N80P10X9_9C1348900 | | IS43DR86400E-25DBL | ISSI | 1 | 512Mbit 400MHz DDR2SMTAssembly

## FMC+_DDR2_HyperRam.PrjPcb
