thanhbinh89/Bow32/hw/top/rtl/bow32_top.sv

// Copyright Bow32 contributors.
// SPDX-License-Identifier: Apache-2.0
//
// Bow32 SoC top level (technology independent).
//
//   Ibex (instr) --+                          +--> ROM    8 KiB
//   Ibex (data) ---+--> main xbar (3 x 9) ----+--> FLASH  128 KiB (memory window)
//   DMA --(no MKV)-+                          +--> SRAM   16 KiB
//                                             +--> VRAM   1 MiB (DMA buffers)
//                                             +--> ISP capture buffer -------------+
//                                             +--> AXI4-Lite bridge --> m_axil_*   |
//                                             +--> DDR2/DDR3 window 512 MiB (bow_ddr) --> ddr_io_* (PHY bundle)
//                                             +--> HyperRAM window 256 MiB (bow_hyperram) --> hr_io_* (PHY bundle)
//                                             +--> periph xbar (1 x 15)            |
//                                                    +--> SYSCTRL (+ reset manager)|
//                                                    +--> FLASH_CTRL               |
//                                                    +--> UART0                    |
//                                                    +--> UART1 --(alternate function)--+
//                                                    +--> GPIOA  8 pins            |    |
//                                                    +--> GPIOB  8 pins, PB0/PB1 <-+----+
//                                                    +--> ISP registers ------+    |
//                                                    +--> I2C0 --> scl/sda    |    |
//                                                    +--> CSI2RX registers -+ |    |
//                                                    +--> H264 registers    | |    |
//                                                    +--> DMA registers     | |    |
//                                                    +--> MKV block cipher (fatal alert -> Ibex NMI)
//                                                    +--> DDR controller CSRs (LiteDRAM)
//                                                    +--> DDR PHY registers         |
//                                                    +--> HyperRAM registers        |
//                                                                           | |    |
//   dphy_* (D-PHY I/O) -> CSI-2 RX (bow_mipi_rx) --RAW10--> ISP (bow_isp) <-+-+----+
//                                             +--> isp_* (RGB888/YUV444 AXI4-Stream)
//                                             +--> H.264 encoder (YUV444) --stream--> DMA channel 0
//
// Addresses and port numbers come from bow32_memmap_pkg (generated from
// hw/top/data/bow32_memmap.yaml). See docs/architecture.md.

module bow32_top import bow_bus_pkg::*; import bow32_memmap_pkg::*; #(
  parameter int unsigned        ClkFreqHz     = 50_000_000,
  // Boot configuration exposed to the ROM through SYSCTRL
  parameter int unsigned        BootBaud      = 115_200,
  parameter int unsigned        BootWaitMs    = 300,
  // UART0 RX low for this many cycles resets the SoC into the bootloader
  parameter int unsigned        BreakCycles   = ClkFreqHz / 100,
  // Memory initialisation ($readmemh, one 32 bit word per line)
  parameter                     RomInitFile   = "",
  parameter                     FlashInitFile = "",
  // CPU options
  parameter ibex_pkg::regfile_e IbexRegFile   = ibex_pkg::RegFileFF,
  // ISP: maximum line width and capture buffer size (24 bit words, the
  // isp_buf window of the memory map holds up to 32768)
  parameter int unsigned        IspMaxWidth   = 2048,
  parameter int unsigned        IspBufWords   = 32768,
  // CSI-2 receiver: data lanes (1, 2 or 4), whether a D-PHY is connected to
  // the dphy_* ports (CSI2RX INFO.PHY), frequency of vid_clk_i (PHY timing),
  // pixel FIFO entries (4 pixels each, power of 2), input delay control in
  // the video clock domain (Versal XPHY, CSI2RX INFO.DLY_VID; 0: byte clock
  // domain, UltraScale+ IDELAYE3)
  parameter int unsigned        CsiLanes      = 2,
  parameter bit                 CsiPhy        = 1'b1,
  parameter int unsigned        VidClkHz      = ClkFreqHz,
  parameter int unsigned        CsiFifoDepth  = 256,
  parameter bit                 CsiDlyVid     = 1'b0,
  // AXI4-Lite window: address bits passed to the AXI device
  parameter int unsigned        AxilAddrWidth = 16,
  // Video RAM (vram window of the memory map: at most 1 MiB)
  parameter int unsigned        VramBytes     = 1024 * 1024,
  // H.264 encoder: maximum width (strip buffers), strips of 16 lines
  parameter int unsigned        H264MaxWidth  = 2048,
  parameter int unsigned        H264Strips    = 4,
  // DDR2/DDR3 SDRAM (docs/ip/ddr.md): LiteDRAM controller core DdrMem (2: DDR2
  // x8 64 MiB, the FMC card; 3: DDR3 x16 128 MiB, DLL-off), Bow32 PHY. The pad
  // widths follow DdrMem (DDR2: 8 DQ, 14 address, 2 bank pins, no DM / RESET#;
  // DDR3: 16 DQ, 13 address, 3 bank pins, DM, RESET#). DdrClkHz = CK,
  // DdrPsSteps = MMCM fine phase steps per CK, DdrPhyKind 1 pins / 2 loopback
  // emulator, DdrEmuBytes = emulator storage (INFO, EMU). DdrEn = 0: stub
  // (window and CSRs answer bus errors, INFO[24] = 0), the ddr_* ports are
  // unused.
  parameter bit                 DdrEn         = 1'b0,
  parameter int unsigned        DdrMem        = 2,
  parameter int unsigned        DdrClkHz      = 133_333_333,
  parameter int unsigned        DdrPsSteps    = 504,
  parameter int unsigned        DdrPhyKind    = 1,
  parameter int unsigned        DdrEmuBytes   = 0,
  // HyperRAM (docs/ip/hyperram.md): HyperBus master for a HyperRAM 2.0 x8
  // device of HrMemBytes (S80KS2562: 32 MiB). HrClkHz = CK, HrPsSteps = MMCM
  // fine phase steps per CK, HrPhyKind 1 pads / 2 loopback emulator, HrHasLs =
  // level shifter controls on the pads, HrEmuBytes = emulator storage (INFO,
  // EMU). HrEn = 0: stub (window answers bus errors, INFO[3] = 0), the hr_*
  // ports are unused.
  parameter bit                 HrEn          = 1'b0,
  parameter int unsigned        HrClkHz       = 100_000_000,
  parameter int unsigned        HrPsSteps     = 672,
  parameter int unsigned        HrPhyKind     = 1,
  parameter bit                 HrHasLs       = 1'b1,
  parameter int unsigned        HrMemBytes    = 32 << 20,
  parameter int unsigned        HrEmuBytes    = 0
) (
  input  logic clk_i,
  input  logic rst_ni,        // asynchronous board reset, active low

  input  logic       uart0_rx_i,
  output logic       uart0_tx_o,

  // GPIO pads: pad = *_oe_o ? *_o : Z, *_i = pad level. After reset all pins
  // are inputs except PB0/PB1, which carry UART1 TX/RX (GPIOB.AF = 0x03).
  input  logic [7:0] gpioa_i,
  output logic [7:0] gpioa_o,
  output logic [7:0] gpioa_oe_o,
  input  logic [7:0] gpiob_i,
  output logic [7:0] gpiob_o,
  output logic [7:0] gpiob_oe_o,

  // I2C0 pads, open drain: *_oe_o = 1 pulls the line low, *_i = line level
  input  logic       i2c0_scl_i,
  output logic       i2c0_scl_oe_o,
  input  logic       i2c0_sda_i,
  output logic       i2c0_sda_oe_o,

  // Video clock domain: CSI-2 receiver PHY control and ISP. ISP output
  // (UG934 order: RGB {R,B,G}, YUV444 {V,U,Y}) must accept one pixel per clock.
  input  logic        vid_clk_i,
  input  logic        vid_rst_ni,
  output logic        isp_tvalid_o,
  input  logic        isp_tready_i,
  output logic [23:0] isp_tdata_o,
  output logic        isp_tuser_o,
  output logic        isp_tlast_o,

  // MIPI D-PHY receive I/O of the CSI-2 receiver (on the KV260:
  // hw/fpga/common/rtl/bow_dphy_io_xusp.sv, on Versal:
  // hw/fpga/common/rtl/bow_dphy_io_versal.sv). LP levels {P, N} and
  // dphy_phy_rdy_i are asynchronous, HS/CE enables are video clock flops,
  // data and rx_valid are in the byte clock domain (gated HS clock / 4), the
  // input delay control in the byte clock domain (CsiDlyVid = 0) or in the
  // video clock domain (CsiDlyVid = 1). A PHY with a word in every byte clock
  // and no ready state (bow_dphy_io_xusp) ties dphy_rx_valid_i = '1 and
  // dphy_phy_rdy_i = 1. Without a camera: CsiPhy = 0, dphy_byte_clk_i = 0,
  // dphy_clk_lp_i = dphy_lp_i = '1 (LP-11), dphy_rx_valid_i = '1,
  // dphy_phy_rdy_i = 1, others '0.
  input  logic                     dphy_byte_clk_i,
  output logic                     dphy_byte_ce_o,
  output logic                     dphy_byte_rst_o,
  input  logic [1:0]               dphy_clk_lp_i,
  output logic                     dphy_clk_hs_en_o,
  input  logic [CsiLanes-1:0][1:0] dphy_lp_i,
  output logic [CsiLanes-1:0]      dphy_hs_en_o,
  input  logic [CsiLanes-1:0][7:0] dphy_rx_data_i,
  input  logic [CsiLanes-1:0]      dphy_rx_valid_i,
  input  logic                     dphy_phy_rdy_i,
  output logic [CsiLanes-1:0][8:0] dphy_dly_tap_o,
  output logic [CsiLanes-1:0]      dphy_dly_load_o,
  input  logic [CsiLanes-1:0][8:0] dphy_dly_tap_i,

  // AXI4-Lite master (axil window of the memory map, clk_i domain)
  output logic [AxilAddrWidth-1:0] m_axil_awaddr_o,
  output logic [2:0]               m_axil_awprot_o,
  output logic                     m_axil_awvalid_o,
  input  logic                     m_axil_awready_i,
  output logic [31:0]              m_axil_wdata_o,
  output logic [3:0]               m_axil_wstrb_o,
  output logic                     m_axil_wvalid_o,
  input  logic                     m_axil_wready_i,
  input  logic [1:0]               m_axil_bresp_i,
  input  logic                     m_axil_bvalid_i,
  output logic                     m_axil_bready_o,
  output logic [AxilAddrWidth-1:0] m_axil_araddr_o,
  output logic [2:0]               m_axil_arprot_o,
  output logic                     m_axil_arvalid_o,
  input  logic                     m_axil_arready_i,
  input  logic [31:0]              m_axil_rdata_i,
  input  logic [1:0]               m_axil_rresp_i,
  input  logic                     m_axil_rvalid_i,
  output logic                     m_axil_rready_o,

  // DDR2/DDR3 clocks and PHY bundle (docs/ip/ddr.md). ddr_sys_clk_i = LiteDRAM
  // controller clock CK / 4 from the same MMCM as ddr_clk_i, every rising edge
  // on a ddr_clk_i rising edge. Without DDR: DdrEn = 0, clocks and ddr_rst_ni
  // 0, ddr_ps_done_i / ddr_wps_done_i 0, ddr_io_i '0, ddr_dbg_i '0.
  input  logic                     ddr_sys_clk_i,  // controller clock (CK / 4, edge aligned)
  input  logic                     ddr_clk_i,      // CK-rate clock, 0 deg
  input  logic                     ddr_rst_ni,     // async active low (MMCM locked)
  input  logic                     ddr_rd_clk_i,   // read capture clock (same frequency, fine PS)
  output logic                     ddr_ps_en_o,    // read-phase MMCM PSEN (PSCLK = ddr_clk_i)
  output logic                     ddr_ps_inc_o,
  input  logic                     ddr_ps_done_i,
  output logic                     ddr_wps_en_o,   // write-phase MMCM PSEN (PSCLK = ddr_clk_i)
  output logic                     ddr_wps_inc_o,
  input  logic                     ddr_wps_done_i,
  output bow_ddr_pkg::ddr_io_out_t ddr_io_o,       // ddr_clk_i domain
  input  bow_ddr_pkg::ddr_io_in_t  ddr_io_i,       // ddr_rd_clk_i domain
  input  logic [31:0]              ddr_dbg_i,      // board debug word (loopback emulator)

  // HyperRAM clocks and PHY bundle (docs/ip/hyperram.md). hr_clk_i = CK rate
  // (controller, PHY, PSCLK of both MMCMs); the write clock (DQ / RWDS, fine
  // phase shift hr_wps_*) only reaches the pad wrapper. Without HyperRAM: HrEn
  // = 0, clocks and hr_rst_ni 0, hr_ps_done_i / hr_wps_done_i 0, hr_io_i '0,
  // hr_rwds_pad_i 0, hr_dbg_i '0.
  input  logic                          hr_clk_i,
  input  logic                          hr_rst_ni,      // async active low (MMCMs locked)
  input  logic                          hr_rd_clk_i,    // read capture clock (same frequency, fine PS)
  output logic                          hr_ps_en_o,     // read-phase MMCM PSEN (PSCLK = hr_clk_i)
  output logic                          hr_ps_inc_o,
  input  logic                          hr_ps_done_i,
  output logic                          hr_wps_en_o,    // write-phase MMCM PSEN (PSCLK = hr_clk_i)
  output logic                          hr_wps_inc_o,
  input  logic                          hr_wps_done_i,
  output bow_hyperram_pkg::hr_io_out_t  hr_io_o,        // hr_clk_i domain
  input  bow_hyperram_pkg::hr_io_in_t   hr_io_i,        // hr_rd_clk_i domain
  input  logic                          hr_rwds_pad_i,  // RWDS pad level (asynchronous)
  input  logic [31:0]                   hr_dbg_i,       // board debug word (loopback emulator)

  // Status (for LEDs / debug)
  output logic       sys_rst_no,
  output logic       core_sleep_o
);

  // ---------------------------------------------------------------------------
  // Clock and reset
  // ---------------------------------------------------------------------------
  logic por_rst_n, sys_rst_n, sys_rst_req;

  bow_rstmgr u_rstmgr (
    .clk_i,
    .por_ni        (rst_ni),
    .sys_rst_req_i (sys_rst_req),
    .por_rst_no    (por_rst_n),
    .sys_rst_no    (sys_rst_n)
  );

  assign sys_rst_no = sys_rst_n;

  // ---------------------------------------------------------------------------
  // Interrupts
  // ---------------------------------------------------------------------------
  logic        uart0_irq, uart1_irq, flash_irq, gpioa_irq, gpiob_irq, isp_irq, i2c0_irq;
  logic        csi2rx_irq, h264_irq, dma_irq, mkv_irq, ddr_irq, hr_irq;
  logic        mkv_alert_fatal;   // MKV locked itself: NMI of the CPU
  logic [14:0] irq_fast;

  always_comb begin
    irq_fast                = '0;
    irq_fast[IrqFastUart0]  = uart0_irq;
    irq_fast[IrqFastUart1]  = uart1_irq;
    irq_fast[IrqFastFlash]  = flash_irq;
    irq_fast[IrqFastGpioa]  = gpioa_irq;
    irq_fast[IrqFastGpiob]  = gpiob_irq;
    irq_fast[IrqFastIsp]    = isp_irq;
    irq_fast[IrqFastI2c0]   = i2c0_irq;
    irq_fast[IrqFastCsi2rx] = csi2rx_irq;
    irq_fast[IrqFastH264]   = h264_irq;
    irq_fast[IrqFastDma]    = dma_irq;
    irq_fast[IrqFastMkv]    = mkv_irq;
    irq_fast[IrqFastDdr]    = ddr_irq;
    irq_fast[IrqFastHyperram] = hr_irq;
  end

  // ---------------------------------------------------------------------------
  // CPU
  // ---------------------------------------------------------------------------
  localparam int unsigned HostInstr = 0;
  localparam int unsigned HostData  = 1;
  localparam int unsigned HostDma   = 2;
  localparam int unsigned NumHosts  = 3;

  bus_req_t [NumHosts-1:0] host_req;
  bus_rsp_t [NumHosts-1:0] host_rsp;

  bow_cpu_ibex #(
    .BootAddr (BootAddr),
    .RegFile  (IbexRegFile)
  ) u_cpu (
    .clk_i,
    .rst_ni         (sys_rst_n),
    .instr_req_o    (host_req[HostInstr]),
    .instr_rsp_i    (host_rsp[HostInstr]),
    .data_req_o     (host_req[HostData]),
    .data_rsp_i     (host_rsp[HostData]),
    .irq_software_i (1'b0),
    .irq_timer_i    (1'b0),
    .irq_external_i (1'b0),
    .irq_fast_i     (irq_fast),
    .irq_nm_i       (mkv_alert_fatal),
    .core_sleep_o
  );

  // ---------------------------------------------------------------------------
  // Main crossbar
  // ---------------------------------------------------------------------------
  bus_req_t [MainNumDevices-1:0] main_req;
  bus_rsp_t [MainNumDevices-1:0] main_rsp;

  bow_bus_xbar #(
    .NumHosts   (NumHosts),
    .NumDevices (MainNumDevices),
    .DevBase    (MainDevBase),
    .DevMask    (MainDevMask)
  ) u_main_xbar (
    .clk_i,
    .rst_ni     (sys_rst_n),
    .host_req_i (host_req),
    .host_rsp_o (host_rsp),
    .dev_req_o  (main_req),
    .dev_rsp_i  (main_rsp)
  );

  bow_rom #(
    .SizeBytes   (RomSize),
    .MemInitFile (RomInitFile)
  ) u_rom (
    .clk_i,
    .rst_ni    (sys_rst_n),
    .bus_req_i (main_req[MainDevRom]),
    .bus_rsp_o (main_rsp[MainDevRom])
  );

  bow_sram #(
    .SizeBytes (SramSize)
  ) u_sram (
    .clk_i,
    .rst_ni    (sys_rst_n),
    .bus_req_i (main_req[MainDevSram]),
    .bus_rsp_o (main_rsp[MainDevSram])
  );

  // Video RAM: accesses above VramBytes wrap around inside the window
  bow_vram #(
    .SizeBytes (VramBytes)
  ) u_vram (
    .clk_i,
    .rst_ni    (sys_rst_n),
    .bus_req_i (main_req[MainDevVram]),
    .bus_rsp_o (main_rsp[MainDevVram])
  );

  // ---------------------------------------------------------------------------
  // Peripheral bus
  // ---------------------------------------------------------------------------
  bus_req_t [PeriphNumDevices-1:0] periph_req;
  bus_rsp_t [PeriphNumDevices-1:0] periph_rsp;

  bow_bus_xbar #(
    .NumHosts   (1),
    .NumDevices (PeriphNumDevices),
    .DevBase    (PeriphDevBase),
    .DevMask    (PeriphDevMask)
  ) u_periph_xbar (
    .clk_i,
    .rst_ni     (sys_rst_n),
    .host_req_i (main_req[MainDevPeriph]),
    .host_rsp_o (main_rsp[MainDevPeriph]),
    .dev_req_o  (periph_req),
    .dev_rsp_i  (periph_rsp)
  );

  bow_sysctrl #(
    .ChipId      (ChipId),
    .ClkFreqHz   (ClkFreqHz),
    .BootBaud    (BootBaud),
    .BootWaitMs  (BootWaitMs),
    .BreakCycles (BreakCycles)
  ) u_sysctrl (
    .clk_i,
    .rst_ni        (por_rst_n),
    .bus_req_i     (periph_req[PeriphDevSysctrl]),
    .bus_rsp_o     (periph_rsp[PeriphDevSysctrl]),
    .uart0_rx_i,
    .sys_rst_req_o (sys_rst_req)
  );

  bow_flash #(
    .SizeBytes   (FlashSize),
    .MemInitFile (FlashInitFile)
  ) u_flash (
    .clk_i,
    .rst_ni    (sys_rst_n),
    .mem_req_i (main_req[MainDevFlash]),
    .mem_rsp_o (main_rsp[MainDevFlash]),
    .reg_req_i (periph_req[PeriphDevFlashCtrl]),
    .reg_rsp_o (periph_rsp[PeriphDevFlashCtrl]),
    .irq_o     (flash_irq)
  );

  localparam logic [15:0] BootBaudDiv = 16'((ClkFreqHz + BootBaud / 2) / BootBaud);

  bow_uart #(
    .ResetBaudDiv (BootBaudDiv)
  ) u_uart0 (
    .clk_i,
    .rst_ni    (sys_rst_n),
    .bus_req_i (periph_req[PeriphDevUart0]),
    .bus_rsp_o (periph_rsp[PeriphDevUart0]),
    .rx_i      (uart0_rx_i),
    .tx_o      (uart0_tx_o),
    .irq_o     (uart0_irq)
  );

  logic uart1_rx, uart1_tx;

  bow_uart #(
    .ResetBaudDiv (BootBaudDiv)
  ) u_uart1 (
    .clk_i,
    .rst_ni    (sys_rst_n),
    .bus_req_i (periph_req[PeriphDevUart1]),
    .bus_rsp_o (periph_rsp[PeriphDevUart1]),
    .rx_i      (uart1_rx),
    .tx_o      (uart1_tx),
    .irq_o     (uart1_irq)
  );

  // ---------------------------------------------------------------------------
  // GPIO ports (IOPAD). UART1 is the alternate function of PB0 (TX) and PB1 (RX).
  // ---------------------------------------------------------------------------
  bow_gpio #(
    .Width (8)
  ) u_gpioa (
    .clk_i,
    .rst_ni    (sys_rst_n),
    .bus_req_i (periph_req[PeriphDevGpioa]),
    .bus_rsp_o (periph_rsp[PeriphDevGpioa]),
    .gpio_i    (gpioa_i),
    .gpio_o    (gpioa_o),
    .gpio_oe_o (gpioa_oe_o),
    .af_out_i  ('0),
    .af_oe_i   ('0),
    .af_in_o   (),
    .irq_o     (gpioa_irq)
  );

  logic [7:0] gpiob_af_in;

  bow_gpio #(
    .Width   (8),
    .AfMask  (8'h03),
    .AfReset (8'h03)
  ) u_gpiob (
    .clk_i,
    .rst_ni    (sys_rst_n),
    .bus_req_i (periph_req[PeriphDevGpiob]),
    .bus_rsp_o (periph_rsp[PeriphDevGpiob]),
    .gpio_i    (gpiob_i),
    .gpio_o    (gpiob_o),
    .gpio_oe_o (gpiob_oe_o),
    .af_out_i  ({7'h0, uart1_tx}),
    .af_oe_i   (8'h01),
    .af_in_o   (gpiob_af_in),
    .irq_o     (gpiob_irq)
  );

  assign uart1_rx = gpiob_af_in[1];

  logic unused_af;
  assign unused_af = ^{gpiob_af_in[7:2], gpiob_af_in[0]};

  // ---------------------------------------------------------------------------
  // Camera path: MIPI CSI-2 receiver -> ISP (registers on the peripheral bus,
  // capture buffer on the main bus), I2C0 for the sensor control
  // ---------------------------------------------------------------------------
  // cam_tuser[1] (line error at tlast) is not used yet: the ISP drops frames
  // whose geometry is wrong, a line with a CRC error passes.
  logic       cam_tvalid, cam_tready, cam_tlast;
  logic [1:0] cam_tuser;
  logic [9:0] cam_tdata;

  // bow_mipi_rx = digital D-PHY (u_csi2rx/u_dphy_rx) + CSI-2 controller (u_csi2rx/u_csi2rx)
  // joined by the PPI; the instance keeps the name u_csi2rx of the FPGA constraints
  bow_mipi_rx #(
    .Lanes     (CsiLanes),
    .PhyClkHz  (VidClkHz),
    .CpuClkHz  (ClkFreqHz),
    .HasPhy    (CsiPhy),
    .FifoDepth (CsiFifoDepth),
    .DlyVid    (CsiDlyVid)
  ) u_csi2rx (
    .clk_i,
    .rst_ni          (sys_rst_n),
    .bus_req_i       (periph_req[PeriphDevCsi2rx]),
    .bus_rsp_o       (periph_rsp[PeriphDevCsi2rx]),
    .irq_o           (csi2rx_irq),
    .vid_clk_i,
    .vid_rst_ni,
    .m_axis_tvalid_o (cam_tvalid),
    .m_axis_tready_i (cam_tready),
    .m_axis_tdata_o  (cam_tdata),
    .m_axis_tuser_o  (cam_tuser),
    .m_axis_tlast_o  (cam_tlast),
    .byte_clk_i      (dphy_byte_clk_i),
    .byte_ce_o       (dphy_byte_ce_o),
    .byte_rst_o      (dphy_byte_rst_o),
    .clk_lp_i        (dphy_clk_lp_i),
    .clk_hs_en_o     (dphy_clk_hs_en_o),
    .lp_i            (dphy_lp_i),
    .hs_en_o         (dphy_hs_en_o),
    .rx_data_i       (dphy_rx_data_i),
    .rx_valid_i      (dphy_rx_valid_i),
    .phy_rdy_i       (dphy_phy_rdy_i),
    .dly_tap_o       (dphy_dly_tap_o),
    .dly_load_o      (dphy_dly_load_o),
    .dly_tap_i       (dphy_dly_tap_i)
  );

  logic unused_cam;
  assign unused_cam = cam_tuser[1];

  logic        isp_tvalid, isp_tuser, isp_tlast;
  logic [23:0] isp_tdata;

  assign isp_tvalid_o = isp_tvalid;
  assign isp_tdata_o  = isp_tdata;
  assign isp_tuser_o  = isp_tuser;
  assign isp_tlast_o  = isp_tlast;

  bow_isp #(
    .MaxWidth (IspMaxWidth),
    .BufWords (IspBufWords)
  ) u_isp (
    .clk_i,
    .rst_ni          (sys_rst_n),
    .reg_req_i       (periph_req[PeriphDevIsp]),
    .reg_rsp_o       (periph_rsp[PeriphDevIsp]),
    .buf_req_i       (main_req[MainDevIspBuf]),
    .buf_rsp_o       (main_rsp[MainDevIspBuf]),
    .irq_o           (isp_irq),
    .vid_clk_i,
    .vid_rst_ni,
    .s_axis_tvalid_i (cam_tvalid),
    .s_axis_tready_o (cam_tready),
    .s_axis_tdata_i  (cam_tdata),
    .s_axis_tuser_i  (cam_tuser[0]),
    .s_axis_tlast_i  (cam_tlast),
    .m_axis_tvalid_o (isp_tvalid),
    .m_axis_tready_i (isp_tready_i),
    .m_axis_tdata_o  (isp_tdata),
    .m_axis_tuser_o  (isp_tuser),
    .m_axis_tlast_o  (isp_tlast)
  );

  // ---------------------------------------------------------------------------
  // Video encoding: ISP output (YUV 4:4:4) -> H.264 encoder -> DMA channel 0
  // -> memory (VRAM). DMA channel 1 has no stream (memory to memory).
  // ---------------------------------------------------------------------------
  logic        h264_tvalid, h264_tready, h264_tlast;
  logic [31:0] h264_tdata;

  bow_h264 #(
    .MaxWidth  (H264MaxWidth),
    .NumStrips (H264Strips)
  ) u_h264 (
    .clk_i,
    .rst_ni          (sys_rst_n),
    .reg_req_i       (periph_req[PeriphDevH264]),
    .reg_rsp_o       (periph_rsp[PeriphDevH264]),
    .irq_o           (h264_irq),
    .m_axis_tvalid_o (h264_tvalid),
    .m_axis_tready_i (h264_tready),
    .m_axis_tdata_o  (h264_tdata),
    .m_axis_tlast_o  (h264_tlast),
    .vid_clk_i,
    .vid_rst_ni,
    .s_axis_tvalid_i (isp_tvalid && isp_tready_i),
    .s_axis_tdata_i  (isp_tdata),
    .s_axis_tuser_i  (isp_tuser),
    .s_axis_tlast_i  (isp_tlast)
  );

  logic [1:0] dma_tready;
  bus_req_t   dma_host_req;
  bus_rsp_t   dma_host_rsp;

  bow_dma #(
    .NumCh (2)
  ) u_dma (
    .clk_i,
    .rst_ni     (sys_rst_n),
    .reg_req_i  (periph_req[PeriphDevDma]),
    .reg_rsp_o  (periph_rsp[PeriphDevDma]),
    .host_req_o (dma_host_req),
    .host_rsp_i (dma_host_rsp),
    .s_tvalid_i ({1'b0, h264_tvalid}),
    .s_tready_o (dma_tready),
    .s_tdata_i  ({32'h0, h264_tdata}),
    .s_tlast_i  ({1'b0, h264_tlast}),
    .irq_o      (dma_irq)
  );

  assign h264_tready = dma_tready[0];
  logic unused_dma;
  assign unused_dma = dma_tready[1];   // channel 1 has no stream source

  // The DMA must not reach the MKV block cipher (key, encryption on behalf of
  // the CPU): its requests to the MKV window end with a bus error here.
  bow_bus_deny #(
    .DenyBase (MkvBase),
    .DenyMask (~(MkvSize - 32'd1))
  ) u_dma_deny_mkv (
    .clk_i,
    .rst_ni     (sys_rst_n),
    .host_req_i (dma_host_req),
    .host_rsp_o (dma_host_rsp),
    .dev_req_o  (host_req[HostDma]),
    .dev_rsp_i  (host_rsp[HostDma])
  );

  // ---------------------------------------------------------------------------
  // MKV block cipher (TCVN 14263:2024), registers only
  // ---------------------------------------------------------------------------
  // Its fault counter and LOCKED live in the power-on reset domain: a system
  // reset (software, UART break) does not give an attacker new tries. Bow32
  // has no alert handler: the fatal alert is the NMI, the recoverable one
  // (each fault) is only the FAULT interrupt.
  bow_mkv u_mkv (
    .clk_i,
    .rst_ni        (sys_rst_n),
    .por_rst_ni    (por_rst_n),
    .bus_req_i     (periph_req[PeriphDevMkv]),
    .bus_rsp_o     (periph_rsp[PeriphDevMkv]),
    .irq_o         (mkv_irq),
    .alert_fault_o (),
    .alert_fatal_o (mkv_alert_fatal)
  );

  bow_i2c u_i2c0 (
    .clk_i,
    .rst_ni    (sys_rst_n),
    .bus_req_i (periph_req[PeriphDevI2c0]),
    .bus_rsp_o (periph_rsp[PeriphDevI2c0]),
    .scl_i     (i2c0_scl_i),
    .scl_oe_o  (i2c0_scl_oe_o),
    .sda_i     (i2c0_sda_i),
    .sda_oe_o  (i2c0_sda_oe_o),
    .irq_o     (i2c0_irq)
  );

  // ---------------------------------------------------------------------------
  // DDR2/DDR3 SDRAM: memory window on the main crossbar, LiteDRAM CSRs and the
  // PHY / bridge registers on the peripheral bus, PHY bundle to the board pad
  // wrapper
  // ---------------------------------------------------------------------------
  if (DdrEn) begin : g_ddr
    bow_ddr #(
      .DdrMem   (DdrMem),
      .ClkHz    (DdrClkHz),
      .PsSteps  (DdrPsSteps),
      .PhyKind  (DdrPhyKind),
      .EmuBytes (DdrEmuBytes)
    ) u_ddr (
      .clk_i,
      .rst_ni         (sys_rst_n),
      .mem_req_i      (main_req[MainDevDdr]),
      .mem_rsp_o      (main_rsp[MainDevDdr]),
      .csr_req_i      (periph_req[PeriphDevDdrCtrl]),
      .csr_rsp_o      (periph_rsp[PeriphDevDdrCtrl]),
      .reg_req_i      (periph_req[PeriphDevDdrPhy]),
      .reg_rsp_o      (periph_rsp[PeriphDevDdrPhy]),
      .irq_o          (ddr_irq),
      .ddr_sys_clk_i,
      .ddr_clk_i,
      .ddr_rst_ni,
      .ddr_rd_clk_i,
      .ddr_ps_en_o,
      .ddr_ps_inc_o,
      .ddr_ps_done_i,
      .ddr_wps_en_o,
      .ddr_wps_inc_o,
      .ddr_wps_done_i,
      .ddr_io_o,
      .ddr_io_i,
      .ddr_dbg_i
    );
  end else begin : g_ddr_stub
    bow_ddr_stub u_ddr (
      .clk_i,
      .rst_ni         (sys_rst_n),
      .mem_req_i      (main_req[MainDevDdr]),
      .mem_rsp_o      (main_rsp[MainDevDdr]),
      .csr_req_i      (periph_req[PeriphDevDdrCtrl]),
      .csr_rsp_o      (periph_rsp[PeriphDevDdrCtrl]),
      .reg_req_i      (periph_req[PeriphDevDdrPhy]),
      .reg_rsp_o      (periph_rsp[PeriphDevDdrPhy]),
      .irq_o          (ddr_irq),
      .ddr_sys_clk_i,
      .ddr_clk_i,
      .ddr_rst_ni,
      .ddr_rd_clk_i,
      .ddr_ps_en_o,
      .ddr_ps_inc_o,
      .ddr_ps_done_i,
      .ddr_wps_en_o,
      .ddr_wps_inc_o,
      .ddr_wps_done_i,
      .ddr_io_o,
      .ddr_io_i,
      .ddr_dbg_i
    );
  end

  // ---------------------------------------------------------------------------
  // HyperRAM: memory window on the main crossbar, registers on the peripheral
  // bus, PHY bundle to the board pad wrapper
  // ---------------------------------------------------------------------------
  if (HrEn) begin : g_hr
    bow_hyperram #(
      .ClkHz    (HrClkHz),
      .PsSteps  (HrPsSteps),
      .PhyKind  (HrPhyKind),
      .HasLs    (HrHasLs),
      .MemBytes (HrMemBytes),
      .WinBits  ($clog2(HyperramSize)),
      .EmuBytes (HrEmuBytes)
    ) u_hr (
      .clk_i,
      .rst_ni         (sys_rst_n),
      .mem_req_i      (main_req[MainDevHyperram]),
      .mem_rsp_o      (main_rsp[MainDevHyperram]),
      .reg_req_i      (periph_req[PeriphDevHyperramReg]),
      .reg_rsp_o      (periph_rsp[PeriphDevHyperramReg]),
      .irq_o          (hr_irq),
      .hr_clk_i,
      .hr_rst_ni,
      .hr_rd_clk_i,
      .hr_ps_en_o,
      .hr_ps_inc_o,
      .hr_ps_done_i,
      .hr_wps_en_o,
      .hr_wps_inc_o,
      .hr_wps_done_i,
      .hr_io_o,
      .hr_io_i,
      .hr_rwds_pad_i,
      .hr_dbg_i
    );
  end else begin : g_hr_stub
    bow_hyperram_stub u_hr (
      .clk_i,
      .rst_ni         (sys_rst_n),
      .mem_req_i      (main_req[MainDevHyperram]),
      .mem_rsp_o      (main_rsp[MainDevHyperram]),
      .reg_req_i      (periph_req[PeriphDevHyperramReg]),
      .reg_rsp_o      (periph_rsp[PeriphDevHyperramReg]),
      .irq_o          (hr_irq),
      .hr_clk_i,
      .hr_rst_ni,
      .hr_rd_clk_i,
      .hr_ps_en_o,
      .hr_ps_inc_o,
      .hr_ps_done_i,
      .hr_wps_en_o,
      .hr_wps_inc_o,
      .hr_wps_done_i,
      .hr_io_o,
      .hr_io_i,
      .hr_rwds_pad_i,
      .hr_dbg_i
    );
  end

  // ---------------------------------------------------------------------------
  // AXI4-Lite window (devices of the FPGA block design)
  // ---------------------------------------------------------------------------
  bow_axil_bridge #(
    .AddrWidth (AxilAddrWidth)
  ) u_axil (
    .clk_i,
    .rst_ni    (sys_rst_n),
    .bus_req_i (main_req[MainDevAxil]),
    .bus_rsp_o (main_rsp[MainDevAxil]),
    .m_axil_awaddr_o,
    .m_axil_awprot_o,
    .m_axil_awvalid_o,
    .m_axil_awready_i,
    .m_axil_wdata_o,
    .m_axil_wstrb_o,
    .m_axil_wvalid_o,
    .m_axil_wready_i,
    .m_axil_bresp_i,
    .m_axil_bvalid_i,
    .m_axil_bready_o,
    .m_axil_araddr_o,
    .m_axil_arprot_o,
    .m_axil_arvalid_o,
    .m_axil_arready_i,
    .m_axil_rdata_i,
    .m_axil_rresp_i,
    .m_axil_rvalid_i,
    .m_axil_rready_o
  );

endmodule
