thanhbinh89/Bow32/hw/ip/hyperram/dv/tb_bow_hyperram.sv

// Copyright Bow32 contributors.
// SPDX-License-Identifier: Apache-2.0
//
// IP-level testbench of the Bow32 HyperRAM controller bow_hyperram (the real
// RTL: window, registers, controller, BIST, PHY) against the DV models of
// this directory, Verilator --binary --timing (and xsim), self-checking
// ("tb_bow_hyperram: PASS" / "FAIL"). One Verilator model per configuration
// (parameters below, see the Makefile).
//
// Board side (PhyKind):
//   2  the MPS4 loopback build: bow_hyperram_io_sim (Loopback) + the RTL's
//      emulator bow_hyperram_dev (EmuBytes; its protocol checks: DBG)
//   1  bow_hyperram_io_sim (pads) + hyperram_board_model (HasLs = 1: the
//      FMC+ card with TXV0108 level shifters; 0: direct board) +
//      hyperram_model (S80KS2562 from its data sheet: tIS / tIH / tCSM /
//      tRWR / latency / RWDS / power state checks, independent of the RTL)
// Stub = 1: the DUT is bow_hyperram_stub (HrEn = 0, same ports).
// Every model is instantiated in every configuration (the unused one sees
// idle pins): the testbench reaches the model's backdoor without generate
// scopes. Clocks: clk_i 50 MHz; hyperram_clk_model (hr_clk, write clock,
// read clock at a random start phase, two fine phase shift ports); hr_rst_ni
// = MMCM locked. The pads show the PHY register only once the MMCMs are
// locked (the FPGA's configuration state before: see pin_io).
//
// The IP is driven through its register slot and window exactly like the
// driver sw/common/src/bow_hyperram.c (bow_hr_cmd: wait !BUSY, clear
// CMD_DONE / CMD_ERR, write CMD, poll; the functions below carry the C
// names). The bus transfer and the CMD protocol run in two engine processes
// (Verilator inlines every task call; nested timing tasks with many call
// sites made an 18 MB C++ function). Flow:
//   1  probe: ID, INFO, CLK_HZ, PS_NOW[31:16], EMU, reset values of CTRL /
//      LAT / TIM0 / WB_TMO; the stub: INFO.HR_EN = 0, window bus errors, done
//   2  bow_hr_enable (CTRL / LAT / TIM0 for the PHY kind; TRST / TWAKE matched
//      to the shortened model times), CLK_OK, APPLY; bow_hr_reset (HW_RESET)
//   3  error paths before the calibration: window access before INIT_DONE
//      (bus error, NOT_READY, ERR_ADDR), CMD with two bits (CMD_ERR)
//   4  the rest of bow_hr_init: coarse read sweep (step 8, REG_RD ID0 with
//      CAP_ARM raw capture, RWDS-located first byte A, eye centre,
//      RFIFO_SYNC, RD_DLY from bow_hr_cap_first_a), ID0 / ID1, bow_hr_configure
//      (CR0 latency for the CK, fixed, legacy 32 byte wrap; CR1 -> TCSM),
//      bow_hr_calibrate (ID0 sweep and 32 byte pattern line-fill sweep,
//      step 4), INIT_DONE; the card: bow_hr_calibrate_write (write phase
//      +-HR_WPS_LIMIT = +-3 * PsSteps / 16, step 8; the model's wr_relax hook
//      is set for its duration: the sweep moves CA and data out of tIS / tIH
//      on purpose)
//   5  device registers: REG_RD ID0 / ID1 / CR0 / CR1 against the model and the
//      CR0 / CR1 shadow registers (also CR1[1:0] after a REG_RD CR1); the
//      controller's guards (ID0 write, reserved CR0 latency: ERR_CODE ARG) and
//      WAKE while active (no CS# pulse)
//   6  window traffic in all 8 modes of RBUF_EN / WRAP_FILL / WPOST: random
//      byte / halfword / word reads and writes (hot region and the whole
//      device), FLUSH, INVAL, against a byte reference and (pads) the model's
//      backdoor (byte 2n = byte A of word n); RANGE (bus error, ERR_ADDR)
//   7  BIST: PRBS and counter patterns, write + read passes, BIST_ERRS = 0, the
//      device contents against an SV twin of the BIST data (backdoor), window
//      reads of BIST data; a BIST burst longer than TCSM refused (TCSM_ERR,
//      BIST_ERR, BIST_DONE, ERR_CODE[15:8] = 3)
//   7b (pads) FLUSH: the posted block must be in the device when WIN_IDLE
//      reads 1 (24 tries); a posted write right before bow_hr_hybrid_sleep
//      must survive the sleep (6 tries)
//   8  VarLat: variable latency (CR0[3] = 0) traffic and BIST with the
//      device's refresh collisions (2x latency counted by ST[4] and, pin
//      model, by the model; the emulator of lb draws 3 in 15 transactions)
//   9  hybrid sleep (window refused, WAKE after tHSIN, data kept, CR1[5] back
//      to 0), deep power down (WAKE after tDPDIN, data lost, CR0 back to its
//      default, a read buffer line kept from before is a NOTE,
//      bow_hr_configure again, traffic); IRQ (CMD_DONE); SNAP statistics
//  10  end: no testbench error, model errors 0, board contention / floats 0,
//      emulator DBG 0, STATUS without RD_ERR / WR_ERR / RFIFO_ERR /
//      BUS_TIMEOUT / TCSM_ERR / BROKEN / RFIFO_BROKEN, bus protocol clean
// Observations that are not errors of the configured checks are printed as
// "tb_bow_hyperram: NOTE" and counted at the end.
//
// RTL issues the testbench recognises (and recovers from: CTRL.CORE_RST,
// APPLY, RFIFO_SYNC, INVAL) are reported as "ERROR RTL ISSUE (<tag>)";
// +WAIVE_<tag> reports them as waived instead (tags: BIST_REFUSE: a refused
// BIST burst never ends the run; WIN_IDLE: WIN_IDLE before the posted data is
// in the device; SLEEP_LOSS: a posted write lost by the sleep entry). The
// first two were found by this testbench and fixed in the RTL (2026-11-07:
// bow_hyperram_bist BReq, posted blocks answered and counted by the window);
// the checks stay as regressions.
// Plusargs: +SEED=<n> (traffic; the Makefile passes the same n to the model
// seeds), +RD_HOLD=<n> (TIM0.RD_HOLD of the configuration, default 1),
// +NTRAF=<n> (random window accesses per window mode, default 150),
// +TIMEOUT_MS=<n> (simulated time limit, default 40), +WAVES, +WAIVE_<tag>,
// and the model plusargs (+hyperram_clk_seed, +hyperram_board_seed,
// +hyperram_mem_seed, +hyperram_refresh_pct, +hyperram_oz_free,
// +hyperram_txn_log).

`timescale 1ps / 1ps
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
