thanhbinh89/Bow32/(commit log)

2026-10-20 Bow32: Ibex-based 32-bit RISC-V learning MCU
    Initial version of the Bow32 SoC and project skeleton.
    Hardware (hw/)
    - lowRISC Ibex as git submodule (pinned 1b29dae8), "small" config
    RV32IMC, wrapped by bow_cpu_ibex so Ibex upgrades stay local.
    - Bow32 bus (Ibex native / OBI subset, fixed 1-cycle response latency)
    with a round-robin crossbar; main bus 2 hosts x 4 devices plus a
    peripheral bus.
    - SRAM 16 KiB, boot ROM 8 KiB, internal flash 128 KiB with NOR
    semantics (key unlock, 1 KiB page / mass erase, program 1->0),
    2 x UART (16 byte FIFOs, IRQ), SYSCTRL with reset manager,
    software reset and UART BREAK reset into the bootloader.
    - Single-source memory map (YAML) generating the S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
    [bootrom.c, bow32.h, bow32_boot_proto.h, bow32_csr.h, bow32_flash.py, bow32_image.h, bow32_image.py, bow32_kv260_top.sv]
2026-10-21 Add schematic K260 and fix script to build fpga
    [bow32_flash.py, kv260.xdc]
2026-10-22 Add GPIO (IOPAD) support with driver and demo application
2026-10-29 Add ISP, I2C master, AXI4-Lite bridge and KV260 camera build
    ISP (hw/ip/isp): RAW10 Bayer to RGB888/YUV444 at 1 pixel/clock with
    separate CPU and video clock domains. Pipeline: input frame check,
    BLC, DPC (5x5), white balance, bilinear demosaic (3x3), CCM, gamma
    LUTs, CSC. Statistics for AE/AWB/AF with a 64-bin histogram, capture
    with a 1/2/4/8 box filter into a 32K x 24 bit buffer, a test pattern
    generator, and staging registers that are applied between frames.
    tools/isp/isp_model.py is a bit-exact model; hw/ip/isp/dv compares the
    RTL against it.
    Also added:
    - bow_i2c: I2C master with repeated START and clock stretching.
    - bow_axil_bridge: AXI4-Lite master window at 0x5000_0000, with a
    t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
2026-10-30 Add Bow32 MIPI CSI-2 receiver (D-PHY RX + CSI-2 RX) for the KV260 camera
    Replace AMD's MIPI CSI-2 RX Subsystem in the kv260_cam build with a
    Bow32-owned receiver: Raspberry Pi camera v2 (IMX219, 2 lanes x
    912 Mbit/s) -> bow_dphy_io_xusp -> bow_csi2rx -> RAW10 -> ISP.
    Hardware
    - hw/ip/csi2rx: LP state machines and byte clock gating, sync search and
    byte alignment, lane merge, CSI-2 packet layer (ECC, CRC-16), RAW10/RAW8
    unpack, async pixel FIFO, AXI4-Stream output; registers (CSI2RX at
    0x4000_8000, irq_fast[7]) with counters, frame/line info, timing,
    IDELAY taps, packet LOG and raw PHY capture. bow_fifo_async in common.
    - hw/fpga/common/rtl/bow_dphy_io_xusp.sv: UltraScale+ component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
    [bow32.h, bow32_kv260_cam_top.sv, bow32_kv260_top.sv, bow32_top.sv, bow_csi2_capture.sv]
2026-10-31 Add H264 and DMA, increase to 1MB RAM
2026-11-04 MKV: wipe keys and data after use, detect fault injection
    Follow-up of the security review of hw/ip/mkv.
    Key and data remanence:
    - KEY needs all k/32 key words written since the last KEY / CLEAR (else
    ERR) and zeroes the KEY registers when it ends: a byte that is not
    written again is never a byte of the previous key, which closes the
    partial-overwrite key recovery through the ENC oracle.
    - The engine keeps K_R, the state and the input at zero while idle, zeroes
    the round keys of a previous longer key during the key schedule and the
    whole round key RAM after a reset (32 cycles, no DONE).
    - DIN is zeroed when ENC / DEC take it, DOUT when KEY starts.
    - fsm_encoding = "none": with Cle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
    [bow_mkv.c, bow_mkv.h, bow_mkv.sv, bow_mkv_core.sv, main.c, tb_bow32.sv, tb_bow_mkv.sv]
2026-11-05 DDR: DDR2/DDR3 IP on LiteDRAM with the Bow32 PHY, Arm MPS4 target
    bow_ddr (hw/ip/ddr): the generated LiteDRAM controller (pinned LiteX /
    LiteDRAM, reproducible with `make litedram` / `make litedram-check`;
    DDR2 x8 BL8 core for the FMC DDR2 card, DDR3 x16 DLL-off core for
    simulation) on Bow32's own PHY behind a DFI 1:4 adapter. 512 MiB window
    at 0x8000_0000, LiteDRAM CSRs at 0x4000_C000, PHY / bridge registers at
    0x4000_E000, irq_fast[11]. Read capture with an MMCM phase shift over a
    whole CK, write phase knob, DIR/OE windows for the card's TXV0108 level
    shifters, read-modify-write without DM, synthesizable DRAM emulator with
    JEDEC checks for the loopback build.
    Arm MPS4 target (hw/fpga/mps4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
    [csr.csv, init.csv]
2026-11-06 MKV: follow the published TCVN 14263:2024 instead of the draft
    The published standard TCVN 14263:2024 is a different cipher from the
    draft TCVN XXXX:2024 that hw/ip/mkv implemented. It differs in three
    points:
    - R = 7 / 8 / 9 rounds for keys of l / 3l/2 / 2l bits (draft 6 / 7 / 8).
    - MixWords rotates column c by c*w/4 bits before M_t (clause 5.4.3):
    y^c = M_t (x^c <<<_w c*w/4); the inverse rotates back after M_t^-1.
    Wiring only in the RTL.
    - The key schedule (clause 5.5) adds Const^0_l in the K^0 branch and
    Const^1_l in the K^1 branch to the counters <2i+1>_l and <2i+2>_l.
    S-box, M4 / M8 and their inverses, XWords, K_int, the round structure
    and the byte order are unchanged. The publis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
2026-11-06 DDR: keep ddr_clk_model out of Verilator inlining (CI, Verilator 5.020)
    The system test ddr failed in CI with "ddr: init: APPLY refused
    (CTRL.EN = 0)" and passed locally. Verilator before 5.022 gives the
    delays of an inlined module the time unit of the module it is inlined
    into (Verilator issue 4806, fixed in 5.022); CI has Ubuntu 24.04's 5.020.
    ddr_clk_model (1 ps) was inlined into tb_bow32 (1 ns): its waits ran in
    ns while $realtime stayed in ps, so the DDR clocks came in bursts 1 ns
    apart with pauses of up to ~2.7 us, CLK_OK dropped during the pauses and
    the APPLY was refused. RTL and firmware are not involved.
    The model now carries /* verilator no_inline_module */, and every CK
    rising e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
    [ddr_clk_model.sv]
2026-11-06 Keep the Arm/AMD documents and the TCVN draft out of git
    The repository is public, so third-party documents are kept only as local
    copies and ignored:
    - docs/fpga/MPS4/: Arm MPS4 documents (TRM 102577, HBI0376B pin lists,
    FMC pin table)
    - docs/fpga/vek280/: AMD VEK280 documents (UG1612, XTP760 schematic,
    RDF0675 master XDC)
    - docs/fpga/xtp682-kria-k26-carrier-card-schematic/: AMD KV260 carrier
    card schematics (XTP682)
    - docs/ref/: the TCVN 14263:2024 draft and the licensed official edition
    The MPS4 TRM, the KV260 schematics and the TCVN draft were also purged
    from the whole history (rewritten on 2026-11-06: every commit has a new
    hash). What the code needs from them is in the repo: th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
2026-11-07 HyperRAM: HyperBus controller IP for the S80KS2562, run on the MPS4
    bow_hyperram (hw/ip/hyperram) is a HyperBus master for HyperRAM 2.0 x8
    (Infineon S80KS2562, 32 MiB), the HyperRAM of the FMC+ DDR2/HyperRAM card
    (behind TI TXV0108 level shifters). Memory window 0x6000_0000 (main xbar
    device 8, 256 MiB decoded, 32 MiB backed), registers 0x4000_F000 (periph
    slot 14), irq_fast[12].
    - Window (clk_i): read buffer of 4 x 32-byte lines with wrapped line fills
    (critical word first), posted writes merged into a 32-byte block and
    pushed as one burst, write-through; RANGE / NOT_READY / timeout ->
    BROKEN until CORE_RST. Every window write, posted or not, is answered
    by the controller and count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
    [bow32.h, bow32_hyperram.py, bow32_kv260_cam_top.sv, bow32_kv260_top.sv, bow32_mps4_top.sv]
2026-11-07 mkv: security review for an AI camera SoC, fault experiments
    docs/mkv_security_review.md reviews the MKV block cipher IP against
    industry practice for secure crypto IP and the standards that apply to an
    AI camera SoC (TCVN 14263, QD 724/QD-BTTTT, ISO/IEC 19790 / 17825, CRA,
    hardware CWE): threat model, strengths, findings on fault injection, side
    channels, key handling and access control, camera use cases, SoC
    integration, verification, and a P0-P2 roadmap.
    hw/ip/mkv/dv/tb_mkv_review.sv (`make -C hw/ip/mkv/dv review`, not part of
    `make test`) backs the findings with eight experiments: an even number of
    flipped bits in one byte of a round key and a round key row copied over
    another release a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
    [tb_mkv_review.sv]
2026-11-07 docs: review the DDR IP for industrial use and a camera AI SoC
    Gap analysis of bow_ddr v2 (LiteDRAM + Bow32 PHY) against two new targets:
    bandwidth budget for 1080p30 + H.264 P frames + a small NPU, refresh at
    Tc > 85 C, ECC (LiteDRAM's is side-band only), drift tracking, QoS,
    address mapping for tiled access, DFI conformance for an ASIC hard PHY,
    verification gaps, and a P0..P3 plan with acceptance criteria. Baseline:
    make -C hw/ip/ddr/dv test passes (lb, card, ddr3, stub, rst) with
    Verilator 5.020.
    Claude-Session: https://claude.ai/code/session_012AakT2MG5xz8ArKopDQm4T
2026-11-07 docs: review the CSI-2 receiver for industrial and AI camera SoCs
    Design review of bow_csi2rx against the needs of industrial cameras and
    AI camera SoCs: 12 findings with code locations (several packets per HS
    burst silently dropped, pixel FIFO overflow breaking the AXI4-Stream line
    framing - reproduced in simulation, CRC/truncation errors not carried with
    the pixels, deskew bursts counted as SOT errors, fixed SETTLE, IDELAY taps
    without VT compensation or tracking...), gap tables per use case, a
    PPI / multi-stream architecture, a roadmap and an extra verification plan.
    Linked from README, docs/ip/csi2rx.md and CHANGELOG.
    Claude-Sessio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
2026-11-07 csi2rx: keep line framing on FIFO overflow, line error, deskew, EXTRA
    Phase 0 of docs/csi2rx_review.md:
    - Pixel FIFO overflow no longer breaks the AXI4-Stream line framing: a
    group that is not the last of its line is only written while the FIFO
    has 2 free slots (new afull_o of bow_fifo_async), so a line that has
    started always ends with tlast (cut to its written groups + its last
    group); with the FIFO full the whole line is dropped, and sof moves to
    the next group when its group is dropped.
    - m_axis_tuser_o[1] with tlast: line error (CRC, format, truncated, cut,
    or a line of the frame lost before it). FIFO group 45 bits. The ISP
    still only uses tuser[0].
    - D-PHY deskew bursts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
    [bow32_top.sv, bow_csi2_packet.sv, bow_csi2_unpack.sv, bow_csi2rx.c, bow_csi2rx.h, bow_csi2rx.sv, bow_csi2rx_out.sv, bow_csi2rx_pkg.sv]
2026-11-08 HyperRAM: fix the confirmed findings of the PR #6 review
    An adversarial review of PR #6 (seven reviewers by area, each finding
    checked by three verifiers: code trace, impact, reproduction; a finding
    is kept when two of three confirm it) confirmed 42 of 49 findings, 38
    distinct issues. All are fixed here. The reviewers' reproduction benches
    pass on the fixed RTL, and the IP testbench now checks the fixed
    behaviour.
    RTL
    - ctrl: a window write staged while a REG_RD / REG_WR waited in XWait
    was taken over by the register access (data lost, no WDONE, WIN_IDLE
    stuck): the staged block is always the next transaction.
    - ctrl: REG_WR to ID0 / ID1 and a CR0 with a reserved latency code are
    refu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
    [bow32_hyperram.py, bow32_mps4_top.sv, bow_hyperram.c, bow_hyperram.h, bow_hyperram.sv, bow_hyperram_bist.sv, bow_hyperram_ctrl.sv, bow_hyperram_dev.sv]
2026-11-08 HyperRAM: second review round of the PR #6 fixes, regression tests for every fix
    A second adversarial review, of the fix commit 5cd7033 only (four
    reviewers by area, one skeptic per finding), confirmed 5 findings and
    left 9 low ones unverified; all 14 are handled here. Writing the missing
    regression tests found two more RTL bugs in the recovery of a channel
    reset (fixed below).
    - win: post_refused was used before its declaration: Vivado xvlog and
    VCS rejected bow_hyperram_win (Verilator and synthesis accept it), so
    the documented xsim run of the IP testbench no longer compiled.
    - regs: the status synchroniser (POWER, CR0, CR1, PS_NOW) reset with the
    channel to 0, so during a chann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
    [bow32_top.sv, bow_hyperram.c, bow_hyperram.h, bow_hyperram_ctrl.sv, bow_hyperram_pkg.sv, bow_hyperram_regs.sv, bow_hyperram_win.sv, hyperram_card.xdc]
2026-11-08 DDR: refresh by temperature, refresh monitor, configuration lock (review P0)
    Fixes of the P0 stage of docs/ddr_review_industrial_ai.md:
    - B1 refresh by temperature: trefi_ns in ddr2.yml / ddr3.yml (3900), the
    LiteDRAM cores regenerated (TRefi 129 / 121 controller cycles, 3.87 us,
    the JEDEC rate for a case temperature of 85..95 C). The generator gives
    LiteDRAM's refresh timer a second period: the core's new port ref_norm
    (CTRL.REF_NORM) makes it refresh every 7.74 us (Tc <= 85 C), from the
    next refresh, so the controller also spends half the time refreshing
    then (BIST on the MPS4: 233.5 / 226.4 MB/s instead of 213.7 / 213.7).
    Elaboration check of bow_ddr at 3.9 us.
    - B6 refresh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
    [bow_ddr.c, bow_ddr.h, bow_ddr.sv, bow_ddr_csr.sv, bow_ddr_dev.sv, bow_ddr_dfi.sv, bow_ddr_lb.sv]
2026-11-08 MKV: fix the findings of the security review, run on the Arm MPS4
    Fixes the IP findings of docs/mkv_security_review.md (PR #8): F1-F6, K3,
    P3 and D1 are fixed, F7, F8, K2, K4 and V1 in part. Section 8 of the
    review has the status of each finding.
    RTL (hw/ip/mkv):
    - Round key RAM: eight interleaved Hsiao (39,32) codewords per row, bound
    to the row address, instead of byte parity. Checked on every read of
    ENC / DEC, the compare of KEY and the read-back of CLEAR. Two flipped
    bits in a byte, bursts up to 24 bits and a row copied over another now
    give FAULT instead of a wrong ciphertext with DONE.
    - DOUT has a complement copy, checked in Check and while the result can
    be read. Each Che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
    [bow32_top.sv, bow_bus_deny.sv, bow_cpu_ibex.sv, bow_mkv.c, bow_mkv.h, bow_mkv.sv, bow_mkv_core.sv]
2026-11-08 MKV docs: board results of the merged build (MPS4 with DDR and HyperRAM)
    After merging main, the MPS4 bitstream has DDR and HyperRAM (loopback):
    WNS +0.169 ns (HyperRAM PHY write path), MKV 13 300 LUT / 2 784 FF, bus
    into MKV +1.418 ns. On the board: power-on self-test PASS, test 19/19
    (seeds 1, 7), kat 6/6, verify 360/360 and 1 800/1 800 blocks, and on
    the same bitstream ddr 21/21 and hyperram 19/19.
    The merged firmware measures 132 / 240 cycles a block of ECB (135 / 247
    before the merge). The driver code is the same; main added sources to
    sw/common, so the link order and the function addresses changed. Each
    firmware gives its own numbers on the same bitstream, so the difference
    is code pl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
2026-11-09 docs: review the FMC+ DDR2/HyperRAM card, fit on the Arm MPS4 and Huins MFP-VP1902
    New docs/fmc_ram_card_review.md: review of the whole FMC+_DDR2_HyperRam card
    (DDR2 and HyperRAM parts, mechanics, BOM) and of its fit on the Arm MPS4 and
    the Huins MFP-VP1902 (Versal Premium VP1902), with the IP functions each
    board can test.
    - The 53 FPGA pins of the card were checked against the schematic, the MPS4
    card XDCs and the Arm pin list (53/53), and against the Huins netlist for
    all eight FMC+ sites (53/53 on every site).
    - New findings: power the card only with VADJ >= 1.5 V (TXV0108 DIR/OE are
    referenced to the 1.8 V side); DDR2 DQ and DQS sit in different TXV0108s,
    a skew the write phase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
2026-11-09 HyperRAM: card run on the Arm MPS4, safe card removal order, self-test (null)
    The real S80KS2562 on the FMC+ RAM card (J11 of the MPS4, FMC_FORCE 1V5,
    card bitstream from main ed949e1) passes: self-test 19/19, verify 40/40,
    write eye open over the whole scan, BIST of all 32 MiB (PRBS with two
    seeds and counter data) and the CPU memtest of all 32 MiB with 0 errors,
    BIST 184.11 MB/s.
    - self-test: detail lines without numbers printed "(null)(null)" (seen on
    the card in check [14], the level shifter note); detail() is variadic
    now and the 35 calls lost their padding arguments.
    - docs/hyperram_mps4.md: the card results (5.3); the run adds BIST and
    memtest over all 32 MiB. LEN / BURST / SEE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
    [selftest.c]
2026-11-09 docs: HyperRAM on an ASIC: what stays, what the PHY must replace
    docs/ip/hyperram.md section 9 answers what an ASIC port needs. The IP
    has no analog part: the core (hw/ip/hyperram/rtl without the emulator,
    about 85 % of the IP's code) is synchronous logic with no FPGA primitive,
    and every CDC goes through bow_sync / bow_rst_sync / bow_fifo_async. The
    FPGA-specific part (pad wrapper, clock wrapper, MMCM phase stepper, XDC)
    becomes a hard PHY: 1.8 V pads, DDR flops, a PLL and a DLL / delay line
    (the one mixed-signal block it must have).
    - What stays and what is replaced, with the parameters of an ASIC build.
    - The read path: keep the calibrated sampling clock (phase range of at
    least T/2, p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
2026-11-09 Huins MFP-VP1902 target: DDR2 and HyperRAM on the FMC+ card (Versal)
    Port of the card build from the Arm MPS4 to the Huins MFP-VP1902-S board
    (AMD Versal Premium xcvp1902), card on FMC+10. Run on the board on
    2026-11-09, the first runs of both IPs with real memories:
    - DDR2: self-test 21/21, verify 40/40, BIST 214 MB/s.
    - HyperRAM: self-test 19/19, verify 40/40, BIST 188 / 180 MB/s.
    - bow_ddr_io_xilinx / bow_hyperram_io_xilinx: parameter TFromOddr (default
    0, the MPS4 build is unchanged). On Versal XPIO the T of a bidirectional
    pad must come from an ODDRE1 in the pad site, on the clock of the data
    ODDR (DRC PDCN-2749).
    - DQ / DM / HyperRAM DQ / RWDS: D1 = ~oe of the previous cycle,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
2026-11-09 Huins docs: HyperRAM ran on the real chip on the MPS4 first (PR #14)
    The DDR2 run on the Huins board is the first one with a real DDR2 chip; the
    HyperRAM had already run on the real S80KS2562 on the MPS4 the same day.
    Claude-Session: https://claude.ai/code/session_017V7xaYy5SohUgA8aqCXMWJ
2026-11-09 Ignore the local camera datasheets
    The Sony IMX274LQC datasheet and the Terasic MIPI D8M-GPIO user manual
    are third-party documents: like the other board documents under
    docs/fpga/, they stay local copies and are never committed.
    Claude-Session: https://claude.ai/code/session_01UnoxuzqWFtrBCmkXs9AiyD
2026-11-10 csi2rx: fix the findings of two reviews of the phase-0 fixes, run on the KV260
    Two independent reviews of PR #10's fixes found 26 and then 18 issues,
    each one reproduced in simulation. This commit fixes them.
    Receiver:
    - Deskew is only taken where the HS-zero leader ends, and only with the
    full FFFFh sync (a candidate of 8 zeros and 8 ones is confirmed by the
    next word). A corrupted 0xB8 followed by 00 FF in the data, or a corrupted
    sync of 8-10 ones before the DI, stays an SOT error.
    - A frame starts at pixel (0, 0) or not at all (ERR_STATUS.SKIP [11]): the
    sof group finds the FIFO full, the first line has no pixel group, or a
    burst of the frame is lost before the first line.
    - A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
    [bow32_top.sv, bow_cdc_pulse.sv, bow_csi2_packet.sv, bow_csi2_unpack.sv, bow_csi2rx.c, bow_csi2rx.h, bow_csi2rx.sv, bow_csi2rx_pkg.sv]
2026-11-10 IMX274 camera on the Huins MFP-VP1902 (FMC+01 camera adapter)
    Run the Leopard LI-IMX274MIPI-FMC (Sony IMX274, 4 lanes x 1440 Mbit/s
    RAW10) on the Huins MFP-VP1902 through the Huins camera adapter on
    FMC+01 (all lanes in XPIO bank 705, site VCCIO 1.2 V), with the same
    test apps as the IMX219 on the KV260.
    - CSI-2 receiver: 1, 2 or 4 lanes (CTRL.LANES4), rx_valid/phy_rdy PHY
    contract, delay loads in the video domain (DlyVid), FIFO depth
    parameter (512 groups for 1080p), lane 2/3 status and counters,
    DLY2/DLY3; KV260 behaviour unchanged (bit-identical in simulation).
    Lane merge no longer outputs the header of a burst dropped for skew.
    - bow_dphy_io_versal: XPHY native-mode D-PHY receiv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
    [bow32_cam.py, bow32_ddr.py, bow32_huins_vp1902_cam_clk.sv, bow32_huins_vp1902_cam_top.sv, bow32_huins_vp1902_top.sv, bow32_hyperram.py, bow32_kv260_cam_top.sv, bow32_kv260_top.sv]
2026-11-10 IMX274: fixes from the first board run and the merge review
    Board run 1 (Huins MFP-VP1902, aaf7ed4, 2026-11-10):
    - VMAX probe: imx274_probe() accepts VMAX 0x906 (the sensor on the board)
    and 0x905 (datasheet); MDSEL1..4, HMAX and the BLKLEVEL read-back must
    still match. On a mismatch the apps print the values read
    (cam_print_not_found(), imx274_probe_regs()) instead of the misleading
    XCLR hint. The sim model resets VMAX to 0x906 (video274 runs with
    0x905, +S274_VMAX_RST).
    - Bayer after a vertical flip: imx274_bayer() returns RGGB for both flip
    values. The sim model flips line pairs and keeps the RGGB phase;
    camera274 expects RGGB (ISP BAYER 0) after 'flip 0 1'.
    - BISC delays at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
    [bow32_video.py, bow_csi2rx.c, bow_csi2rx.h, bow_h264.c, bow_h264.h, cam_sensor.c, cam_sensor.h]
2026-11-10 IMX274: board validation results (run 1), docs
    docs/camera_huins.md from the first board run on the Huins MFP-VP1902
    (2026-11-10, PDI and firmware of aaf7ed4, before the merge of main):
    - status: IMX274 4 x 1440 Mbit/s, 1080p30 and 720p60 without errors
    after calibration, csi2_test PASS 15/15, colour bars and real scene
    right, H.264 1080p30 decodes. The fixes since run 1 are verified in
    simulation, to re-check in board run 2; board run 2 on the final code
    is pending (the board is lent out). Timing of the final camera PDI
    (WNS +0.780 ns, WHS +0.014 ns, bus skew 11/11) and the 2 CDC-11 rows
    of the merged lane 2/3 enable flop that the build's CDC whitelist does
    not list yet (3 CRI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
2026-11-10 Huins camera build: review the CDC-11 of the merged lane 2/3 enables
    With 4 lanes the enables of data lanes 2 and 3 are always equal, and
    synthesis merges them into one lane_en_q flop that feeds two
    synchronisers, exactly like the already reviewed lane 0/1 pair. The
    final PDI's own CDC check listed the two crossings as unreviewed. The
    whitelist now accepts every merged lane-enable flop. Re-running the
    build's checks on that PDI's routed checkpoint gives 0 failures and no
    CRITICAL WARNING.
    Claude-Session: https://claude.ai/code/session_017V7xaV19M7L7sgaQHTu92K
2026-11-11 IMX274: board run 2 on the final code (Huins VP1902), docs
    Board run 2 (2026-11-11) ran the PDI and firmware of cd289e3, identical
    to main 458dd33 in firmware and RTL, and every check passed:
    unpatched probe (VMAX 0x906), csi2_test PASS 17/17, extra 0 at 1080p30
    and 720p60, margin on all 4 lanes (+-88/+-90/+-90/+-88 taps, BER < 1e-8)
    with a hand-set tap kept, first cam calibrates, flip 0 1 natural colours,
    AE/AWB frozen during the test pattern, 5 min at 1080p30 (9012 frames)
    error free, H.264 1080p30 30/30 frames and 720p30 45/45 frames.
    docs/camera_huins.md: status, the run-2 output in sections 5-7 (run-1
    numbers kept where run 2 did not repeat them, labelled), checklist
    results and two ne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
    [bow_csi2rx.c, bow_csi2rx.h]
2026-11-11 IMX274: csi2_test link check over whole frames, rec first QP per mode, jtag hint
    The three software items left open by board run 2 (docs/camera_huins.md
    section 7).
    csi2_test `start`: its link check took 64 packets (6 % of a 1080p frame)
    and printed "link check ok" at the BISC delays, which then gave 0.2-1.5
    CRC errors per frame. It now takes 16 whole frames with the new driver
    function bow_csi2rx_link_check_frames(): frames that start (FS) after the
    counter clear, counted at their FE, stopping at the first link error. 16
    frames see a rate of 0.2 errors per frame 96 % of the time; ~0.55 s at
    1080p30. A tap error still prints "(ERR_STATUS ..), try cal"; the Versal
    build adds "errors in frame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
    [bow_csi2rx.c, bow_csi2rx.h, bow_h264.c, bow_h264.h, main.c, tb_bow32.sv]
2026-11-11 IMX274: board run 3 (follow-up fixes verified, stability, BISC investigation), docs
    Board run 3 on the Huins MFP-VP1902 (2026-11-11): the PDI of cd289e3
    (RTL as main 458dd33) with the firmware of 5c68b53. Docs only; no RTL,
    firmware or tool change.
    - The three fixes after run 2 work on the board: csi2_test `start`
    (16 whole frames) caught the errors at the BISC delays 7 of 7 times
    and printed the cal hint; `rec` picked QP 37 (auto) at 720p/45 frames
    and QP 38 (auto) at 1080p/30 frames, all frames stored and decoded;
    the jtag.tcl hint showed against another team's real hw_server
    2025.1 (nothing loaded, make failed).
    - csi2_test PASS 17/17 on the default and both test PDIs; 30 minut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
2026-11-11 docs: record the MIPI RX architecture decisions and the run-3 BISC results
    The owner reviewed PR #19 and decided:
    - no register alias; the migration steps are built and run on the
    Huins board only, the KV260 stays in simulation until it is needed;
    - ASIC speed target B, 80 Mbit/s to 2.5 Gbit/s (clk_act, the low-rate
    aligner fixes and the deskew engine become sign-off items);
    - the synchronous AFE contract of section 3.3 as the starting proposal;
    - MIPI membership before the AFE contract is frozen;
    - lp_clk >= 250 MHz by default, AFE auto termination as the fallback;
    - AFE boundary below PPI, 8-bit PPI in v1, one PR per migration step.
    New section 0 lists them, and the affected sections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
2026-11-11 MIPI RX step 1a: hierarchy-independent cell selectors for the CSI-2 receiver
    Step 1a of docs/ip/mipi_rx_arch.md section 10, on the unchanged RTL, before
    step 1b moves the D-PHY cells into bow_dphy_rx:
    - kv260_cam.xdc, huins_vp1902_cam.xdc: every set_bus_skew of the CSI-2
    receiver selects its cells with get_cells -hierarchical -filter on the tail
    of the hierarchical name instead of the full u_soc/u_csi2rx/... path: D-PHY
    cells and synchronisers by their own names (*/meter_gray_q_reg[*],
    */u_sync_meter/g_bit[*].u_sync/sync_q_reg[0], */g_dly_vid.u_sync_req/...,
    */u_sync_tap_out/...), the pixel FIFO, register file and capture flops by
    their path below u_csi2rx. The counts the builds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
2026-11-11 MIPI RX step 1b: split the digital D-PHY out of bow_csi2rx as bow_dphy_rx
    Step 1b of docs/ip/mipi_rx_arch.md section 10. The ports and the register map
    of bow_csi2rx do not change.
    - New hw/ip/dphy_rx/rtl/bow_dphy_rx.sv (instance u_dphy_rx inside
    bow_csi2rx) with today's D-PHY functions moved unchanged, instance and
    register names kept: the LP state machines (u_lp_clk, g_lp[l].u_lp), the
    clock edge detection (clk_tog), the ISERDES reset (u_iserdes_rst,
    byte_rst_o), the rx_data / rx_valid word flops, the arm synchroniser, the
    aligners (g_align[l].u_align), the tap loads (g_dly_byte / g_dly_vid) and the
    byte clock meter, together with the synchronisers of these functions
    (u_sync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
    [bow_csi2rx.sv, bow_dphy_align.sv, bow_dphy_lp.sv, bow_dphy_rx.sv, bow_sync_bus.sv]
2026-11-11 MIPI RX step 1: review fixes (F1-F7)
    Fixes of the review of 1a96d15 + a7b2a03 (docs/ip/mipi_rx_arch.md section
    10, step 1). No functional RTL change: bow_csi2rx.sv only gets a comment
    fix (F6).
    - F1 (P2) hw/ip/dphy_rx/fm/equiv.tcl: a run also needs every matched pair
    to have the same name once the rename rules are applied
    (report_matched_points -list, mismatches in names.rpt), every pair
    matched by name (none by user, topology or function), and net name
    matching is off (name_match_based_on_nets false). Formality counts
    pairs matched through net names as "matched by name", and a functional
    check cannot see ASYNC_REG: the review mutant that rebuilds u_sync_tog
    from two plain flo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
    [bow_csi2rx.sv, huins_vp1902_cam.xdc, kv260_cam.xdc]
2026-11-11 MIPI RX step 2: docs, PPI mapping, temporary band and results
    docs/ip/mipi_rx_arch.md:
    - Status: steps 1 and 2 done, except the Huins board run. Section 0: step 2
    also uses Formality (make -C hw/ip/dphy_rx/fm equiv STEP=2), still
    waiting for the owner's decision on the D8 deviation.
    - 5.1: the PPI types of bow_ppi_pkg (ppi_hs_t, ppi_lp_t, ppi_lp_clk_t,
    RxByteClkHS and Enable as plain ports). 5.2: PhyReady comes with steps 4-5.
    - 5.3: ErrControlClk is masked by the controller in steps 2-3 (CLK_FORCE is
    still its register), by the D-PHY from step 4; new table "PPI v1 trong
    RTL (bước 2)": every PPI signal, its struct field, its source in
    bow_dphy_rx (with the step 1 name) and whe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
2026-11-11 MIPI RX step 2: review fixes (F1-F7)
    - F1: the Formality flow applies the rename rules of the steps between
    the reference and the implementation to the implementation only, so
    a reference from step 1 on keeps its hierarchy. Every matched pair,
    unread ones included, must carry the reference's name, and every cell
    must sit in the same block (D-PHY u_dphy_rx/, controller) on both
    sides, with no cell in bow_mipi_rx itself (partition.rpt). The
    review's mutant MA (the phy_rdy synchroniser moved from the D-PHY to
    the controller) passed the old rules; it now fails with 2 pairs
    outside their block.
    - F2: bow_ppi_chk (hw/ip/dphy_rx/dv), bound into bow_dphy_rx by the
    csi2rx DV and the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
    [bow_csi2rx.sv, bow_dphy_rx.sv, bow_mipi_rx.sv, bow_ppi_chk.sv, bow_ppi_pkg.sv, tb_bow32.sv, tb_bow_csi2rx.sv]
2026-11-11 docs: MIPI RX steps 1-2 ran on the Huins board
    The step-2 camera PDI (which contains step 1) passed csi2_test on the
    Huins MFP-VP1902 with the IMX274: test PASS 17/17 at 1080p30 and 720p60,
    margins of +-88..90 taps per lane with 0 errors in 60 frames per point,
    calibrated taps 300/184/260/228 with eyes 352/360/352/352, the same as
    board runs 1-3, and byte clock 180.078 MHz. Section 10 records the run.
    Claude-Session: https://claude.ai/code/session_01UnoxuwDkrELEUsEiBaDuSR
2026-11-11 docs: D8 amended, Formality proves the MIPI RX refactor steps
    The owner approved Synopsys Formality (RTL against RTL) instead of
    Yosys eqy for the equivalence proofs of the refactor steps: eqy is not
    installed on the build host and plain Yosys reads only part of
    SystemVerilog, while Formality is licensed there and is the checker the
    ASIC flow uses next (RTL against netlist). The proof runs on the build
    host before each refactor PR, and CI keeps running every simulation.
    Adding eqy to CI later stays optional. Section 0 records the amended D8;
    the pending notes in sections 8.1 and 10 and the CHANGELOG are updated,
    and steps 1-2 are marked done with their board run.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
2026-11-12 MIPI RX step 3: PPI bench of the CSI-2 controller in two timings, flat-port wrapper
    Step 3 of the MIPI RX migration (docs/ip/mipi_rx_arch.md, section 10): the
    CSI-2 controller alone at its PPI, checked against the same Python receiver
    model as the whole-receiver bench. No existing RTL changes.
    - hw/ip/csi2rx/dv/bow_ppi_bfm.sv, tb_csi2rx_ppi.sv: the PHY of the
    controller in two timings. bow: the D-PHY of Bow32 (bow_csi2rx with its
    PPI and the v1 band driven by the BFM: RxActiveHS from the end of SETTLE,
    RxValidHS gaps like the XPHY's, ErrSotSyncHS at the end of the burst, lp
    errors and HS entries as vid_clk_i pulses, band_lane_en_lp = Enable
    through 2 flops as in the D-PHY, RAW wor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
    [bow_csi2rx_ppi_flat.sv, bow_ppi_bfm.sv, mutants_ppi.py, tb_csi2rx_ppi.sv]
2026-11-12 MIPI RX step 3: review fixes (PPI bench coverage, test-rx in parallel, PPI profile notes)
    Review of bd1e5fe (F1-F7). No RTL changes; all edits are DV, the model and docs.
    - F1: no test reached the wrapper's lane-enable mask. lpmask now runs in both
    timings. In std mode it uses the settled cases only: an LP error of a lane
    that CTRL disabled earlier is counted, and one of an enabled lane marks a
    lost burst. The mask-edge cases stay bow-only. The model's lperr checks the
    lane enable (Receiver.lp_loss), and std mode has no ErrControlClk. New
    mutant flat_lane_en_tied_1 (killed by std lpmask). Rejected:
    flat_lane_en_unsynced. The 2 flops are a CDC structure, and the PHY's
    error tak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
    [bow_ppi_bfm.sv, mutants_ppi.py]
